ThirstySALMON/conv3x3-edge-accelerator/docs/figures/edge_demo_sobel_x.png

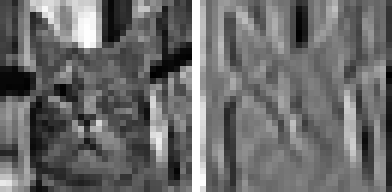
docs/figures/edge_demo_sobel_x.png
