ThirstySALMON/conv3x3-edge-accelerator/docs/figures/waveforms/edges.PNG

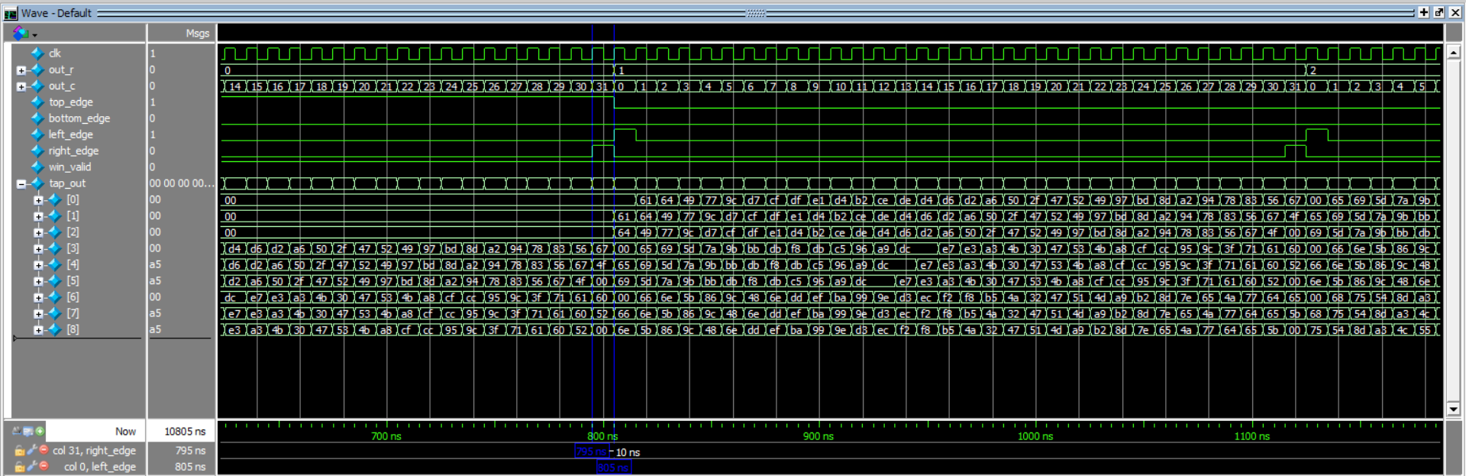
docs/figures/waveforms/edges.PNG
