ThirstySALMON/conv3x3-edge-accelerator/docs/report/REPORT_OUTLINE.md

# Report outline - what each section must say

> **Verified corrections - apply these while writing. They override any bullet below.**
>
> | Claim | Correct value | Source |
> |---|---|---|
> | STREAM state duration | **990 cycles**, not 1024 (cyc 35 -> 1025). Frame = 34 FILL + 990 STREAM + 34 DRAIN + 3 pipeline = 1061. 1024 is the count of inputs and of outputs, not of STREAM cycles - `consume` also runs in IDLE/FILL | `do sim/run.do window` trace |
> | Worst-15 path split | **10** from `bottom_edge_reg` (6 to prod_r[8], 4 to prod_r[6]), 4 from `top_edge_reg`, 1 from `right_edge_reg` | `fpga/reports/paths.rpt` |
> | Line buffers | **16 SRLC32E primitives** (two 8-bit-wide chains of 8), 16 LUTs. Never "2 x SRL32E". Do not claim 0 FFs - `utilization_hier.rpt` shows 61 FFs under LB0 | `synth.log`, `utilization.rpt` |
> | `throughput.PNG` | The shipped capture is the **whole frame** (cursors 515 / 10755 ns, delta 10240 ns = 1024 cycles), not a mid-frame zoom. Caption it as "valid_out unbroken for 1024 consecutive cycles" | the file itself |
> | Window-generator captures | The three `Window_generator_*.PNG` are from the **11 Sep** commit, not the 14 Sep retake; unchanged by later commits (tb_top_window reports 0 errors) | git log |
> | File line counts | cnn_pkg 33, line_buffer 31, window_gen 64, multiplier 8, coeff_reg 34, control_unit 106, top 141 = **417** RTL lines; tb_top 137, tb_top_all 180, tb_top_window 171, tb_window_gen_unit 165; golden.py 80; compile.do 21, run.do 25, build.tcl 76, pynq_z2.xdc 67 | `grep -c ''` |
> | Code line citations | top.sv saturate/ReLU is **lines 116-129**; control_unit nxt_c/nxt_r **40-51**, registered flags **97-100**; window_gen masks **54-62**. (Comments were trimmed on 14 Sep, so any earlier line number is stale - recount before citing, or cite by signal name instead) | the tagged files |
> | COEF_FRAC / Q1.7 | Declared in the package only, **no implementing logic** and no results. Say "a declared toggle with no shift/round stage", or omit | `rtl/cnn_pkg.sv` |
> | xsim version | The SAIF header stamps `VERSION "2020.2"` (the writer's format stamp) though it ran from the Vivado 2025.2 install. Quote both, or run `xsim -version` and quote that | `fpga/tb_top.saif` |
>
> **Also add to section 17 (Assumptions):** kernel size N = 3 assumed (the spec says NxN); coefficients applied unflipped (cross-correlation, the CNN convention, same as golden.py); power-analysis conditions are Vivado defaults (25 C ambient, ThetaJA 11.5 C/W, 250 LFM, no heat sink, commercial grade, typical process).
>
> **Assembly order:** write the report in the announcement's deliverable order - architecture, block diagram, datapath, FSM, memory, window generation, bit-width, RTL, testbench, golden model, waveforms, synthesis, timing, power, tradeoffs, Table 1 - then assumptions, bonuses, conclusion, appendix. The section numbers in this file are authoring groups, not the report's order.
>
> **Appendix fixes:** `modelsim.ini` is at the project root, not in `sim/`. The 14 `hw_out/` files are regenerated by `do sim/run.do all` (tb_top_all); `run.do kernels` rewrites only the five real-kernel `_out.hex`.

Bullets, not prose: the author writes every sentence. Each block says what the section
must cover, with the real numbers, and which figure or table belongs in it.

Numbers come from `fpga/reports/RESULTS.md`, `docs/notes/POWER_METHODOLOGY.md` and
`docs/notes/DESIGN_ITERATIONS.md`. Section order follows the announcement's deliverable list.

Two independent critics reviewed this outline - one against every announcement
requirement, one against the measured numbers. Their findings are at the end; fold them
in while writing.

---

## 1. Accelerator architecture
**Required by:** Deliverable "accelerator architecture"; Instruction 1 "clearly describe the datapath, control FSM, memory/buffer organization, window generation"; Instruction 4 "state all assumptions clearly"; spec items 1, 3, 5 (image size, programmable kernel, stride 1).
**Say:**
- Function (REQUIRED, items 1/3/5): 3x3 same (zero-padded) convolution over a 32x32 grayscale image, stride 1, 1024 input pixels in, 1024 output pixels out, one output pixel per clock.
- Precision at a glance (details in section 7): input 8-bit unsigned Q8.0; coefficients 8-bit signed integer Q8.0 (COEF_FRAC = 0; the package toggle COEF_FRAC = 7 rebuilds for Q1.7); output 16-bit signed, saturating; ReLU is a build-time parameter RELU, default off.
- Programmable kernel (REQUIRED, item 3): 9 coefficients loaded through write_en / write_addr[3:0] / data_write[7:0], write_addr = 3*row + col (0..8), row-major, same order as the taps; addresses 9..15 ignored; writes ignored while busy; reloadable between frames (proven by the back-to-back run, sobel_x then sharpen, kernel swapped while frame 1 drains).
- Architecture type (reuse the exact phrase in Table 1): streaming line-buffer sliding-window convolution, fully parallel 9-multiplier datapath, 3 pipeline register stages after the window, 1.0 output pixel per cycle.
- The architectural claim: strict control/datapath split. control_fsm (rtl/control_unit.sv) owns every counter and flag: state, in_cnt (10b), out_r/out_c (5b each), drain_cnt (6b), four registered edge flags. window_gen, line_buffer, coeff_reg, mult8x8 and the adder tree hold no position state; window_gen has no counters and no valid output.
- Control-to-datapath signals are only: en and the four edge flags into window_gen, busy into coeff_reg (write lock), win_valid into the 3-stage valid chain.
- Datapath in one line: 9 taps (9x8b) x 9 coefficients (9x8b) -> 9 LUT multipliers -> stage-1 register prod_r 9x16b -> three 3-input row adders -> stage-2 register row_r 3x18b -> one 3-input 20-bit adder -> saturate 20b->16b -> ReLU mux -> stage-3 register pixel_out.
- Valid chain runs level with the data: win_valid -> v_prod -> v_row -> valid_out; pipeline registers are free-running, so a valid_in stall becomes a bubble in valid_out exactly 3 cycles later, never corruption.
- Window generation: two 32-deep 8-bit line buffers in series (LB0 from input_in, LB1 from LB0) + 9 tap registers a..i + combinational zero-pad masks driven by the edge flags (section 6).
- Frame sequence: IDLE -> FILL (34 consume-only cycles) -> STREAM (consume + output until the 1024th pixel is consumed) -> DRAIN (34 output-only cycles, en forced high, input ignored) -> DONE (1 cycle, frame_done) -> IDLE. en = valid_in except DRAIN (1) and DONE (0). Consume-only cycles equal output-only cycles (34 = 34) so inputs and outputs both total 1024.
- Interface, 42 pins: clk, rst_n (active-low, synchronous, every module), input_in[7:0] + valid_in, write port 13 pins (write_en, write_addr[3:0], data_write[7:0]), pixel_out[15:0] signed + valid_out, busy. 1 + 1 + 8 + 1 + 13 + 16 + 1 + 1 = 42.
- Flow control: no ready signal. valid_in may drop on any cycle; en gates line buffers, taps and counters together (the window freezes coherently). Source-side frame gating: the source streams exactly 1024 pixels per frame and holds the next frame until busy falls. busy = not IDLE and not DONE; it falls 3 cycles before the last valid_out because the last window is already in the pipeline.
- Latency 37 cycles from first accepted pixel to first valid_out = 34 window fill + 3 pipeline stages. Throughput 1.0 output pixel/cycle peak, gapless within a frame; 1024 outputs in 1061 cycles = 0.965 sustained per frame including fill and drain.
- FoM lever 1 (REQUIRED rationale), throughput = 1 px/cycle: 9 parallel multipliers consume all 9 window pixels every cycle. The 3-multiplier / one-output-per-3-cycles alternative was rejected: throughput x3 for a denominator the pre-implementation estimate put at roughly 1.5x (docs/notes/ARCHITECTURE_LOCKED.md section 4; label it an estimate, not a measurement). It also claims the named bonus.
- FoM lever 2, 0 BRAM (100x penalty per tile): the line buffers are fabric shift registers, inferred as 16 SRLC32E = 16 LUTs for both. Even the cheapest block-RAM mapping (one tile, 100 LUT-equivalents) would raise the denominator from 879 to 879 - 16 + 100 = 963 (arithmetic, +9.6%).
- FoM lever 3, 0 DSP (50x penalty each): use_dsp = "no" attribute on mult8x8 (rtl/multiplier.sv) plus -max_dsp 0 in fpga/build.tcl; the nine 8u x 8s multipliers cost 52-59 LUTs each, 496 in total. Frame this honestly: 9 DSP48E1 would count 450 against 496 LUTs, so the choice is near-neutral on the denominator; it is kept because an 8x8 product uses a fraction of a 25x18 DSP48E1, keeps the whole design in one fabric type with one power model, and keeps the RTL vendor-neutral (one attribute).
- Where the 879 LUTs sit (routed, indicative because Vivado combines LUTs across hierarchy boundaries): 9 multipliers 496, window_gen 132 (116 logic + 16 SRL), coeff_reg 120, control_fsm 80, top-level adder tree / saturate / ReLU 90. DSPs and BRAMs are already 0, so every remaining FoM point is a LUT.
- Constant-coefficient multipliers were rejected: all shipped kernels use only 0, +-1, +-2, +-4, 5 and hardcoding would save roughly 300 LUTs, but forfeits mandatory programmability (item 3).
- Headline results, forward-referenced to sections 12-14: xc7z020clg400-1 (PYNQ-Z2, TUL), Vivado 2025.2, 125 MHz constraint (8.000 ns); 879 LUTs, 441 FFs, 0 DSP, 0 BRAM, 42 IOB, 1 BUFG; WNS +0.742 ns, WHS +0.153 ns, 0 failing endpoints of 602, Fmax 137.8 MHz; total power 0.158 W (0.107 static + 0.052 dynamic, SAIF-annotated, Medium confidence); FoM = 1.0 / (0.158 x 879) = 7.20e-3 at 125 MHz.
- Verification headline, forward-referenced to sections 9-11: golden_model/golden.py (numpy); 22 regression runs all pass (7 kernels x clean / fixed stalls / random stalls + one back-to-back run), RELU=0 and RELU=1 DUTs on the same stimulus; hw_out/ 14 files byte-identical to golden_model/hex/.
- Module/file map: rtl/cnn_pkg.sv (parameters), rtl/control_unit.sv (module control_fsm), rtl/window_gen.sv, rtl/line_buffer.sv, rtl/coeff_reg.sv, rtl/multiplier.sv (module mult8x8), rtl/top.sv (instantiation, 9 multipliers, adder tree, saturate, ReLU, three pipeline registers, valid chain).
- Bonuses claimed by this architecture: one-output-pixel-per-cycle pipelined; multiple kernels (programmable, 5 real kernels verified, reload between frames); ReLU (parameter, verified on all 7 kernels); edge-detection demo in simulation rendered from hw_out/. Board demo not claimed (fpga/top.bit exists for the real PYNQ-Z2 pinout; the pixel-source wrapper was not built).
- Assumptions (REQUIRED, Instruction 4), state as a list: 32x32 fixed image; zero-padded same convolution (1024 outputs) rather than valid (30x30); coefficient port order row-major; watts for the FoM power term (the PDF gives no unit); FoM at 125 MHz; no ready signal, source-side frame gating; I/O timing excluded from timing closure; write port ignored while busy; input is raster order, one pixel per cycle, stalls allowed; kernel choices are the standard ones.
**Show:**
- Table: Design parameters (rtl/cnn_pkg.sv) - Parameter | Value | Kind (fixed / toggle / derived) | Note - rows: IMG_W 32 fixed; IMG_H 32 fixed; KSIZE 3 fixed; NTAP 9 derived; N_MAC 9 fixed (fully parallel); LB_DEPTH 32 = IMG_W (one full row, not IMG_W-3); IN_W 8 unsigned Q8.0; COEF_W 8 signed; COEF_FRAC 0 toggle (7 = Q1.7 rebuild); OUT_W 16 signed saturating; RELU_EN 0 toggle (top parameter RELU); PROD_W 16 derived; ACC_W 20 derived; OUT_MAX +32767; OUT_MIN -32768; FILL_CYCLES 34 = LB_DEPTH + 2; NPIX 1024; DRAIN_CYCLES 34 = FILL_CYCLES.
- Table: Module map - File | Module | Role | Owns - rows from the module/file bullet above; mark control_fsm as the only holder of position state.
- Figure: docs/figures/waveforms/throughput.PNG - mid-frame, valid_out solid high, pixel_out changing every cycle: the 1 px/cycle claim (also reused in the throughput/bonus section).
- Diagram to draw: forward reference to the 5-box block diagram in section 2 - see docs/report/BLOCK_DIAGRAM_NOTES.md.
**Avoid:**
- Do not write "STREAM lasts 1024 cycles": FILL already consumes 34 pixels, so STREAM has 1024 - 34 = 990 consume+output cycles (control_unit.sv leaves STREAM at in_cnt == 1023). 1024 is the per-frame input/output count; the frame total 1061 = 34 + 1024 + 3 only adds up that way.
- Do not list mac3x3.sv, saturate.sv or relu.sv as modules (docs/notes/ARCHITECTURE_LOCKED.md names them, the shipped RTL folds them into top.sv). Do not call the input port pixel_in; it is input_in.
- Do not present 0 DSP as a large FoM saving (450 vs 496); do not fold Fmax 137.8 MHz into the FoM; do not say High confidence on power; do not claim a board demo.
- Do not quote the 3-MAC "1.7-1.9x better" figure from ARCHITECTURE_LOCKED.md as a measured result.
- Do not describe the design as vendor-locked or as needing the PS7; it is PL-only (the ZPS7-1 DRC warning is expected).
**Sources:** rtl/cnn_pkg.sv, rtl/top.sv, rtl/control_unit.sv, docs/notes/ARCHITECTURE_LOCKED.md (sections 1, 4, 5, 6), docs/notes/DESIGN_ITERATIONS.md (section 0), docs/report/BLOCK_DIAGRAM_NOTES.md (I/O count), fpga/reports/RESULTS.md, fpga/build.tcl, rtl/multiplier.sv.

## 2. Block diagram
**Required by:** Deliverable "block diagram" (listed separately from "datapath" and "FSM state diagram", so this figure is the top-level view only).
**Say:**
- One figure, five boxes, left to right: control_fsm (top-left), window_gen (with LB0, LB1, 9 tap registers and the zero-pad masks drawn inside), coeff_reg, MAC datapath (9 x mult8x8 + prod_r + 3 row adders + row_r + final 20-bit adder), saturate / ReLU + output register.
- Draw the control/datapath split as a horizontal divide: control_fsm alone above the line (holds counters and flags, no pixel data); the four datapath boxes below (hold data, no position state). Say this in the caption.
- External pins at the boundary, 42 total: clk, rst_n; input_in[7:0], valid_in; write_en, write_addr[3:0], data_write[7:0]; pixel_out[15:0], valid_out, busy. Annotate "42 pins" (it explains the 27% I/O share of power later).
- Arrows out of control_fsm: en (to window_gen), top_edge / bottom_edge / left_edge / right_edge (to window_gen, draw a register symbol on each - they are flip-flops computed one position ahead), busy (to coeff_reg as the write lock, and to the pin), win_valid (into the valid chain), frame_done (internal, may be shown dashed).
- Arrows into control_fsm: valid_in only (plus clk/rst_n). Nothing else - it never sees pixel data.
- Data arrows: input_in[7:0] -> window_gen; window_gen -> MAC datapath: tap_out[0..8], 9 x 8b; coeff_reg -> MAC datapath: coef[0..8], 9 x 8b; MAC datapath -> saturate/ReLU: acc, 20b; saturate/ReLU -> pixel_out[15:0].
- Valid chain drawn level with the three data registers: win_valid -> v_prod (next to prod_r) -> v_row (next to row_r) -> valid_out (next to pixel_out).
- Three dashed vertical stage boundaries labelled stage 1 (after the multipliers, prod_r 9x16b), stage 2 (after the row adders, row_r 3x18b), stage 3 (after saturate/ReLU, pixel_out 16b). This is the picture for the "Pipeline stages = 3" row of Table 1.
- Annotations to write on the figure: "LB0, LB1: 32 x 8, inferred as 16 SRLC32E (two 8-bit-wide chains), 16 LUTs, 0 BRAM"; "ReLU: RELU parameter, default off"; "latency 37 = 34 fill + 3 stages" near the output; "0 DSP: use_dsp = no" on the multiplier box.
- Optional per-box LUT labels (routed, indicative): control_fsm 80, window_gen 132, coeff_reg 120, multipliers 496, adder tree/saturate/ReLU 90; total 879.
- Show the write-lock explicitly: busy into coeff_reg with a note "writes ignored while busy".
- Show the stall path in one sentence in the caption: en = valid_in freezes window_gen and the counters; the pipeline registers keep clocking and the valid chain carries the bubble.
- Caption gist: "Top-level block diagram. control_fsm holds every counter and flag and no pixel data; window_gen, coeff_reg and the MAC datapath hold data and no position state. Solid arrows data, dashed arrows control. Three pipeline register stages follow the window; the valid bit travels with the data. 879 LUTs, 0 DSP, 0 BRAM on xc7z020clg400-1."
- Keep the detailed datapath drawing for section 3 and the state diagram for section 4; this figure must not duplicate their internals.
**Show:**
- Diagram to draw: 5-box block diagram exactly as sketched under "Block diagram (new figure, 5 boxes)" in docs/report/BLOCK_DIAGRAM_NOTES.md, with corrections 1-9 from that file applied (registered edge flags, valid chain level with stages, SRL annotation, RELU toggle, stage boundaries, latency 37, control outputs, 42 pins).
- Table: Inter-block signals (use it to label the drawing) - Signal | From | To | Width | Meaning - rows: en (control_fsm -> window_gen, 1, shift enable = valid_in except DRAIN/DONE); top/bottom/left/right_edge (control_fsm -> window_gen, 4 x 1, registered zero-pad selects); win_valid (control_fsm -> valid chain, 1); busy (control_fsm -> coeff_reg and pin, 1); frame_done (control_fsm internal, 1); tap_out (window_gen -> multipliers, 9 x 8); coef (coeff_reg -> multipliers, 9 x 8); prod_r (9 x 16, stage 1); row_r (3 x 18, stage 2); acc (20, combinational); pixel_out (16, stage 3).
**Avoid:**
- No BRAM, DSP, FIFO, AXI or ready/handshake symbols anywhere on the figure; nothing of the kind exists in the design.
- Do not label the line buffers 29 x 8 (an old, wrong figure); they are 32 x 8.
- Do not draw the edge flags as combinational decodes of out_r/out_c; they are registers.
- Do not draw mac3x3 / saturate / relu as separate modules or files.
- Do not draw a reset synchroniser or PS7; the RTL has neither.
**Sources:** docs/report/BLOCK_DIAGRAM_NOTES.md, rtl/top.sv (port list and instance names u_cu, u_wg, u_cr, g_mul[k].u_mul), rtl/control_unit.sv (output list), fpga/reports/utilization_hier.rpt (per-box LUTs).

## 5. Memory organization
**Required by:** Deliverable "memory organization"; Instruction 1 "memory/buffer organization"; spec item 9 "BRAMs" in the implementation results; the FoM's 100 x BRAMs term.
**Say:**
- (REQUIRED, item 9) Block RAM used: 0 of 140 tiles (RAMB36 0, RAMB18 0); LUT as Distributed RAM: 0; the only memory-class primitive in the whole design is 16 x SRLC32E (LUT as Shift Register 16). fpga/reports/utilization.rpt sections 1 and 3.
- The image is never stored. State on chip at any time is 2 rows + 9 pixels: two 32-deep line buffers (2 x 32 x 8 = 512 bits) and nine 8-bit tap registers (72 bits). One external read per output pixel; the 9 window pixels come from internal registers, nothing is re-read.
- Line buffer (rtl/line_buffer.sv): a DEPTH x WIDTH = 32 x 8 shift register, en-gated, synchronous reset; sr[0] takes d_in, d_out = sr[DEPTH-1]. No write pointer, no read pointer, no address compare - the delay is fixed by the structure.
- Why it infers as SRL despite the synchronous reset: nothing reads an intermediate element, only sr[DEPTH-1], so Vivado maps the chain into LUT shift registers (fpga/reports/RESULTS.md, "Line buffers came out as SRLs"). 16 LUTs instead of 512 flip-flops.
- Evidence, synth.log "Static Shift Register Report": two rows, u_wg/LB1/sr_reg[0][7] and u_wg/tap_reg_reg[2][7], each Length 30, Width 8, SRLC32E 8 - 16 SRLC32E in total; "Report Cell Usage" lists SRLC32E 16; utilization.rpt "LUT as Shift Register 16" and utilization_hier.rpt u_wg SRLs 16 agree.
- Reading that table for a judge: an SRLC32E is a single LUT6 used as a 32-bit shift register, so 8 cells carry one 8-bit-wide line; the "Pull out last Reg = YES" column shows Vivado kept the reset-bearing end stage as an ordinary flip-flop and put the other 30 stages of each chain in SRLs. Quote the 16 LUTs; do not over-specify beyond what the table says.
- Depth 32 exactly matches the primitive: SRLC32E is 32 deep, so a 32-pixel image row costs precisely one LUT per bit; a 29-deep buffer would cost the same 8 LUTs per line and buy nothing.
- The 100x argument (REQUIRED for the FoM story): one block RAM tile counts as 100 LUT-equivalents; both line buffers together cost 16 LUTs. The cheapest BRAM mapping (one tile for both) would make the denominator 879 - 16 + 100 = 963, +9.6% (arithmetic), and would also need write/read address counters, an output register and read-latency alignment that the fixed-depth shift register does not have. A 32 x 8 line is 256 bits, 1.4% of an 18 kbit tile.
- Tap registers: 9 x 8 bits = 72 FFs in window_gen, en-gated, shifted along each row (a<-b<-c, d<-e<-f, g<-h<-i); all 9 are read in parallel every cycle by the multipliers, so they cannot be a RAM of any kind.
- Coefficient registers (rtl/coeff_reg.sv): 9 x 8 bits = 72 FFs; single write port (write_en, write_addr[3:0], data_write[7:0]), guarded by write_en && !busy && write_addr < 9; 9 parallel read buses, no read mux; the multipliers see all 9 coefficients every cycle. Routed cost 120 LUTs (indicative) - that is the write-address decode fanning out to 9 byte-wide enables, not storage.
- Pipeline registers (rtl/top.sv), free-running (no enable): prod_r 9 x 16 = 144 FFs, row_r 3 x 18 = 54 FFs, pixel_out 16 FFs, valid chain v_prod / v_row / valid_out 3 FFs = 217 FFs, matching the top-level row of utilization_hier.rpt.
- Control state (rtl/control_unit.sv): in_cnt 10 + out_r 5 + out_c 5 + drain_cnt 6 + 4 edge flags + state = 35 FFs routed (Vivado re-encoded the 3-bit enum one-hot, see fpga/reports/RESULTS.md).
- Totals: 441 FFs routed = 217 (top-level pipeline) + 72 (coeff_reg) + 35 (control_fsm) + 117 (window_gen, includes the 72 taps); datapath storage 512 + 72 + 72 = 656 bits; BRAM 0; distributed RAM 0.
- Two kinds of enable, deliberately: everything that holds window position or window data (line buffers, taps, counters) is gated by en so a stall freezes the window coherently; everything downstream of the window is free-running and protected by the travelling valid bit. Unique control sets: 16 (utilization.rpt).
- Reset: every register in every module clears on synchronous rst_n. Correct borders do not depend on it - the zero-pad masks do that (section 6, back-to-back run).
- Scaling note for the tradeoffs section: the on-chip state grows with image width only (2 x IMG_W x 8 bits), never with height; larger widths would cascade SRLC32E cells rather than move to block RAM.
**Show:**
- Table: On-chip storage - Element | RTL location | Size (bits) | Routed implementation | Enable | Why not BRAM - rows: LB0 (window_gen / line_buffer, 32 x 8 = 256, 8 x SRLC32E, en, 100x penalty vs 8 LUTs and no address logic); LB1 (same, 256, 8 x SRLC32E, en, same); tap registers a..i (window_gen tap_reg, 72, FFs, en, 9 parallel reads per cycle); coefficient registers (coeff_reg, 72, FFs, write_en && !busy, 9 parallel reads per cycle); prod_r (top, 144, FFs, free-running, pipeline register); row_r (top, 54, FFs, free-running, pipeline register); pixel_out + valid chain (top, 16 + 3, FFs, free-running, output register); control counters / flags / state (control_fsm, 35 FFs, mixed, not memory). Footer: total 441 FFs, 16 SRL LUTs, 0 BRAM, 0 LUTRAM. Sources: utilization.rpt, utilization_hier.rpt, synth.log.
- Table: Memory-primitive evidence - Report | Line / section | Value - rows: synth.log Static Shift Register Report (2 chains, Length 30, Width 8, 8 SRLC32E each); synth.log Report Cell Usage (SRLC32E 16); utilization.rpt section 1 (LUT as Shift Register 16, LUT as Distributed RAM 0); utilization.rpt section 3 (Block RAM Tile 0 / 140); utilization_hier.rpt (u_wg SRLs 16, RAMB36 0, RAMB18 0).
- Figure: none required; if one is wanted, a small drawing of input_in -> LB0 (32x8) -> LB1 (32x8) with the three tap rows hanging off input_in, LB0 out and LB1 out - this is the same drawing as section 6, draw it once and reference it.
**Avoid:**
- Do not call the line buffers FIFOs, circular buffers or RAMs; they are fixed-depth shift registers with no pointers.
- Do not say the line buffers were "kept at 0 LUT-as-shift-register" (an old note, corrected in RESULTS.md); 16 is the right number and the better outcome.
- Do not quote the per-line-buffer rows of utilization_hier.rpt (LB0 36 LUTs / 61 FFs; LB1 has no row) as exact - the hierarchy report combines LUTs and registers across boundaries; quote the top-level 16 SRLs / 0 BRAM / 441 FFs.
- Do not claim the SAIF confidence is High or that the memory contributes measurably to power (the logic of the whole design is about 6% of 0.158 W).
- Do not say the design needs BRAM for a larger image; say wider SRL chains.
**Sources:** rtl/line_buffer.sv, rtl/window_gen.sv, rtl/coeff_reg.sv, rtl/top.sv, rtl/control_unit.sv, fpga/reports/synth.log (lines 229-270), fpga/reports/utilization.rpt (sections 1, 3, 8), fpga/reports/utilization_hier.rpt, fpga/reports/RESULTS.md, docs/notes/ARCHITECTURE_LOCKED.md (sections 1, 7).

## 6. Line-buffer or window-generation method
**Required by:** Deliverable "line-buffer or window-generation method"; Instruction 1 "window generation"; spec item 1 (32x32) and item 5 (stride 1); Instruction 2 (verified against golden vectors).
**Say:**
- (REQUIRED) Structure (rtl/window_gen.sv): input_in feeds tap i and line buffer LB0; LB0's output (in_f) feeds tap f and line buffer LB1; LB1's output (in_c) feeds tap c. Each tap row is a 3-register shift chain: c->b->a, f->e->d, i->h->g. All of it is en-gated; window_gen has no counters and produces no valid.
- Delay of each tap behind input_in, in enabled cycles: i 1, h 2, g 3 (bottom row, from input_in); f 33, e 34, d 35 (middle row, from LB0); c 65, b 66, a 67 (top row, from LB1). Row-to-row spacing is exactly 32 = IMG_W, column spacing exactly 1: the three rows are vertically aligned, the window is a true 3x3.
- When the centre e holds pixel (r, c), the taps hold: a (r-1,c-1) b (r-1,c) c (r-1,c+1) / d (r,c-1) e (r,c) f (r,c+1) / g (r+1,c-1) h (r+1,c) i (r+1,c+1). The window for (r, c) is at the taps once pixel (r+1, c+1) has entered.
- Stride 1 falls out of the structure: one enabled shift moves the window one column; the raster order of the input is the raster order of the output.
- Why depth 32 and not 29 (REQUIRED, the number a reviewer will question): the line buffer carries one full row of vertical delay. The horizontal tap chains hang off the buffer outputs as parallel branches (input_in also feeds LB0; in_f also feeds LB1), so they add no delay along the vertical axis. With 29 the middle row would sit 29 pixels behind the bottom row, a skewed parallelogram that fails the golden diff on every interior pixel (verified by sweep, docs/notes/ARCHITECTURE_LOCKED.md section 7). IMG_W - 3 = 29 belongs only to a topology with the taps inside the delay chain, and since an SRLC32E is 32 deep either way it would not save a LUT.
- Fill latency 34 = 32 + 2 (FILL_CYCLES = LB_DEPTH + 2 in rtl/cnn_pkg.sv): pixel (0,0) enters tap i on shift 1, leaves LB0 after 32 more shifts into tap f on shift 33, and moves f->e on shift 34. So output (0,0) is at the taps on enabled cycle 34, then one new window per enabled cycle for all 1024 positions.
- Only one line buffer sits between the input and the centre tap. LB1 feeds the top row only, and the top row is zero-masked on output row 0, so the first window does not wait the 66 cycles the top row would need. This is why fill is 34 and not 66.
- Zero padding (same convolution) is done by combinational masks after the tap registers, never by writing zeros into the buffers: top_edge -> taps 0,1,2 (a b c); bottom_edge -> 6,7,8 (g h i); left_edge -> 0,3,6 (a d g); right_edge -> 2,5,8 (c f i). Sequential ifs give OR behaviour, so a corner tap is zeroed by either flag; tap 4 (e, the centre) is never touched.
- Coverage of the masks: rows 0 and 31 and columns 0 and 31 = 124 border windows of 1024 are masked (3 taps on an edge, 5 taps at a corner); the 900 interior windows pass all 9 taps unchanged.
- The flags come from control_fsm as registers computed one position ahead (nxt_r == 0, nxt_r == 31, nxt_c == 0, nxt_c == 31, rtl/control_unit.sv), so on every cycle the flag and the window at the taps belong to the same output position. Registering them moved the comparator out of the multiplier path (WNS +0.332 -> +0.742 ns, Fmax 130.4 -> 137.8 MHz, 4 FFs, LUTs 882 -> 879).
- What is left on the critical path is the flag fanout: bottom_edge_reg -> tap zero mux -> multiplier -> prod_r[8][13], 7 logic levels, 7.297 ns, fanout 156, 1.517 ns on that net; all 15 worst paths start at an edge-flag register (detail in section 13).
- Stall behaviour: en low holds LB0, LB1 and all 9 taps; out_adv is low so out_r/out_c and hence the four flags hold; the masked window at the taps is frozen and win_valid is low. A stall is input starvation, never a design bubble.
- Drain behaviour: after the 1024th pixel the FSM forces en high for 34 cycles so the last windows can still shift out; whatever is on input_in during DRAIN enters the bottom tap row, but the only windows whose bottom row contains post-frame data are the row-31 windows (plus tap i of (30,31)), all zero-masked by bottom_edge / right_edge. Proven by hw_out equality on all 7 kernels.
- Back-to-back frames: there is no reset between frames, so when frame 2 starts LB0/LB1 and the taps still hold the tail of frame 1; the row-0 windows of frame 2 carry frame-1 data in taps a b c, and top_edge masks it. The back-to-back regression run (sobel_x then sharpen, 2048 outputs, byte-identical) shows the masks, not the reset, guarantee the border.
- Cost of the window generator (routed, indicative): 132 LUTs = 116 logic (masks and tap-row logic, partly merged into the multipliers' first LUT level by Vivado) + 16 SRL, 117 FFs including the 72 tap bits; 0 BRAM.
- Verification, unit level (tb/tb_window_gen_unit.sv, direct-drives en and the four flags, cycle-accurate shadow model of both line buffers and the nine taps): test 1 ramp of 3 x 32 + 20 = 116 enabled cycles checked every cycle; test 2 en low for 5 cycles, all 9 taps frozen, then one resume shift; test 3 each single edge flag; test 4 the four corner combinations plus an explicit top-left check (taps 0,1,2,3,6 zero, centre not zero). Verdict line: "PASS: window_gen unit tests all clean (shift, stall, edges, corners)".
- Verification, integration level (tb/tb_top_window.sv, the FSM driving window_gen inside top): on every win_valid cycle all 9 taps are compared with golden_model/vectors/hramp_windows_same.hex (1024 windows x 9 bytes, row-major), (out_r, out_c) with the expected raster position, the four flags with that position, and consecutive win_valid cycles must be adjacent; plus fill latency == FILL_CYCLES (34) and exactly 1024 windows per frame; result 0 tap / position / gap errors.
- Window-level golden vectors in golden_model/vectors/: hramp, vramp, impulse, random, ring (impulse and ring are the border and indexing stress cases).
- End-to-end, the window generator is exercised at all 1024 positions by every one of the 22 regression runs and by the byte-identical hw_out/ files (sections 9-11).
- Tie the numbers to the pictures: 34 fill cycles are the difference between latency 37 and the 3 pipeline stages in docs/figures/waveforms/latency.PNG (145 ns to 515 ns = 370 ns = 37 cycles at the 10 ns TB clock).
**Show:**
- Diagram to draw: the window generator: input_in -> LB0 (32 x 8, SRLC32E) -> LB1 (32 x 8, SRLC32E); tap rows g h i off input_in, d e f off LB0 out, a b c off LB1 out, each drawn as a 3-register shift chain; en into every register; the four flags entering the mask block after the taps; label the delays 1/2/3, 33/34/35, 65/66/67; annotate "one full row = 32, not 29" and "centre e never masked".
- Table: Tap map - Tap | Index | Window position | Fed from | Delay behind input_in (cycles) | Pixel when centre = (r,c) - the 9 rows from the delay bullet above.
- Table: Zero-padding masks - Flag | Condition in control_fsm | Taps zeroed | Output positions | Windows affected - rows: top_edge (nxt_r == 0; a b c = 0,1,2; row 0; 32), bottom_edge (nxt_r == 31; g h i = 6,7,8; row 31; 32), left_edge (nxt_c == 0; a d g = 0,3,6; column 0; 32), right_edge (nxt_c == 31; c f i = 2,5,8; column 31; 32), corners (two flags; 5 taps; 4 positions, counted inside the rows above), centre e (never). Source: rtl/window_gen.sv lines 61-69, rtl/control_unit.sv.
- Figure: docs/figures/waveforms/Window_generator_producing_valid_taps.PNG - unit test, the first complete 3x3 window appearing at the taps after the fill.
- Figure: docs/figures/waveforms/Window_generator_producing_valid_taps2.PNG - the window sliding one column per enabled cycle (a<-b<-c, d<-e<-f, g<-h<-i visible).
- Figure: docs/figures/waveforms/Window_generator_producing_last_valid_taps.PNG - the last window of the run at the taps.
- Figure: docs/figures/waveforms/edges.PNG - output column 31 then column 0: right_edge zeros c f i, next cycle left_edge zeros a d g, centre e untouched; the zero padding in action.
- Figure: docs/figures/waveforms/stall.PNG - valid_in low 3 cycles before pixel 300, en follows, the nine taps hold their values, bubble in valid_out 3 cycles later; the frozen window.
- Figure: docs/figures/waveforms/latency.PNG - first valid_in at 145 ns to first valid_out at 515 ns = 37 cycles = 34 fill + 3 pipeline; the 34 is the line-buffer fill.
**Avoid:**
- Never write 29 or IMG_W - 3 as the buffer depth; any old drawing labelled "Line Buffer (29x8)" must be corrected to 32x8.
- Do not say the borders are zero because reset cleared the buffers; the masks do it (back-to-back run).
- Do not say window_gen generates valid_out, counts positions or detects edges; control_fsm does all three.
- Do not say the first output waits for both line buffers (66 cycles); it waits for one (34).
- Do not say the centre tap is masked at corners, or that corners use a separate flag; two of the four flags overlap there.
- Do not describe the line buffers as RAM with pointers, and do not draw a BRAM.
- Do not claim the edge-flag replication (fanout 156 fix) was done; it is recorded as identified and estimated (0.5-1 ns), not implemented.
**Sources:** rtl/window_gen.sv, rtl/line_buffer.sv, rtl/cnn_pkg.sv (FILL_CYCLES / DRAIN_CYCLES comments), rtl/control_unit.sv (nxt_r / nxt_c, flag registers), docs/notes/ARCHITECTURE_LOCKED.md (sections 6, 7, 8), docs/notes/DESIGN_ITERATIONS.md (section 2 and the critical-path notes), tb/tb_window_gen_unit.sv, tb/tb_top_window.sv, docs/notes/WAVEFORM_CAPTURES.md (captions 4, 5, 8), golden_model/vectors/.

---

## 3. Datapath
**Required by:** Instruction 1 "Clearly describe the datapath ... fixed-point arithmetic"; deliverable "datapath"; bonus "one-output-pixel-per-cycle pipelined architecture"; Table 1 rows "Multipliers / MACs", "Pipeline stages", "Latency", "Throughput".
**Say:**
- Scope: the datapath is everything downstream of the 9 window taps - all in rtl/top.sv except the multiplier cell in rtl/multiplier.sv; it holds no position state (control_fsm owns that) and no feedback loop (pure feed-forward sum tree, not an accumulate-in-place MAC).
- Inputs every cycle: tap_out[0..8] (9 x 8-bit unsigned, already zero-masked by window_gen at borders, row-major a..i) and coef[0..8] (9 x 8-bit signed from coeff_reg, write_addr = 3*row+col, same order as the taps).
- Stage 1 combinational: 9 parallel multipliers 8u x 8s. mult8x8 computes prod = coef * signed'({1'b0, pix}) - the pixel is zero-extended to 9-bit signed so the signed-by-unsigned multiply is exact; Vivado's RTL component statistics list "8x9 Multipliers := 9" (fpga/reports/synth.log).
- Product is 16-bit signed (PROD_W = IN_W + COEF_W = 16), range -32640..+32385.
- Multipliers forced into LUTs: (* use_dsp = "no" *) on mult8x8 plus synth_design -max_dsp 0 in fpga/build.tcl (both, so the result does not depend on one tool default). Result: 0 DSP.
- Multiplier cost: 52 or 59 LUTs each (5 instances at 52, 4 at 59 in fpga/reports/utilization_hier.rpt), 496 LUTs total = 56% of the 879 routed LUTs; per-block split is indicative because Vivado combines LUTs across hierarchy boundaries.
- Stage 1 register: prod_r, 9 x 16 bits, plus v_prod (valid). Synchronous reset, no clock enable, free-running.
- Also inside stage 1's combinational cone, ahead of the multiplier: the tap zero-mask (top -> a,b,c; bottom -> g,h,i; left -> a,d,g; right -> c,f,i) driven by the four REGISTERED edge flags from control_fsm. Registering those flags (design iteration b) is what took WNS from +0.332 to +0.742 ns.
- Stage 2 combinational: three 3-input adders, one per window row: row_sum[0] = a+b+c, row_sum[1] = d+e+f, row_sum[2] = g+h+i. Each 18-bit signed (ROW_W = PROD_W + 2), range -97920..+97155.
- Why row-wise 3+3 rather than one 9-input sum: the grouping matches the window rows (same a-b-c / d-e-f / g-h-i structure as the taps and the masks), splits the 9-input sum into two 3-input adds in consecutive stages, and leaves stage 2 and 3 with large slack (+3.799 / +2.666 ns) so stage 1 alone is binding - the stages are balanced against the multiplier, which cannot be split further without touching the multiplier itself.
- Stage 2 register: row_r, 3 x 18 bits, plus v_row.
- Stage 3 combinational: acc = row_r[0] + row_r[1] + row_r[2], 20-bit signed (ACC_W = 20), range -293760..+291465, lossless; then saturate 20 -> 16 bits by the sign-extension check on acc[19:15] (details in section 7); then ReLU mux relu_out = (RELU && sat[15]) ? 0 : sat, where RELU is a build-time parameter (default 0) so the mux constant-folds away in the shipping build.
- Stage 3 register: pixel_out (16-bit signed) and valid_out.
- Register budget of the three stages: 144 + 54 + 16 data FFs plus 3 valid FFs; FFs do not appear in the FoM denominator, so full-width lossless intermediates cost nothing on the metric.
- Valid chain: win_valid (from control_fsm) -> v_prod -> v_row -> valid_out, one flip-flop per stage, level with the data registers; the pipeline registers have no enable, so the valid bit is the only thing that distinguishes a real result from a bubble.
- Stall behaviour: valid_in low -> en low -> taps and line buffers freeze -> win_valid low for that cycle -> a one-cycle bubble in valid_out exactly 3 cycles later; data already in the pipeline keeps advancing, so a stall can never corrupt an output. Regression asserts valid_out == win_valid delayed by exactly 3 every cycle (lat_err = 0) in all 22 runs; fixed-stall run: 16 stalls in STREAM, 16 bubbles observed.
- Latency accounting: 37 cycles from first accepted pixel to first valid_out = 34 window fill (FILL_CYCLES = LB_DEPTH 32 + 2 tap shifts) + 3 pipeline stages. Waveform: first valid_in at 145 ns, first valid_out at 515 ns, 370 ns = 37 cycles at the 10 ns TB clock.
- Throughput: one new window and 9 multiplies per enabled cycle, 1.0 output pixel per cycle peak, gapless within STREAM; 1024 outputs in 1061 cycles = 0.965 sustained per frame including fill and drain.
- Per-stage worst slack (routed, 8.000 ns, fpga/reports/paths.rpt): stage 1 window/coeffs -> prod_r +0.742 ns; stage 2 prod_r -> row_r +3.799 ns; stage 3 row_r -> pixel_out +2.666 ns. Stage 1 binds; stage 3 has 1.924 ns and stage 2 3.057 ns of headroom over it.
- Critical path: u_cu/bottom_edge_reg -> tap zero mux -> multiplier -> prod_r[8][13], 7 logic levels (4 CARRY4, LUT6, LUT5, LUT3), 7.297 ns, 59% routing; bottom_edge fanout 156 and 1.517 ns spent on that one net. Fmax = 1000/(8.000 - 0.742) = 137.8 MHz.
- All 15 worst paths start at an edge-flag register (bottom_edge_reg, top_edge_reg, right_edge_reg) and end in prod_r[8], [6], [2] or [5] - taps i, g, c, f, the ones masked by two flags or by the right flag - i.e. the limit is when the masks arrive at the multipliers, not the multiplier arithmetic itself.
- Known but not done: replicating the edge-flag registers per tap row to cut the fanout-156 net (est. 0.5-1 ns); timing already closes and Fmax is not in the FoM.
- Constant-coefficient multipliers (all real kernels are 0, +-1, +-2, +-4, 5) would cut roughly 300 LUTs but forfeit the mandatory programmability of spec item 3 - rejected; cross-reference the tradeoffs section.
**Show:**
- Diagram to draw: updated detailed datapath figure - 9 multipliers -> 9x16b register -> 3 row adders -> 3x18b register -> 20b adder -> "sat (top-bits check)" -> ReLU (labelled "RELU parameter, default off") -> 16b output register; dashed stage boundaries labelled stage 1/2/3; valid chain drawn level with the three registers; widths on every bus (8u, 8s, 16, 18, 20, 16); registered edge flags on the four arrows into window_gen; "LB0/LB1 inferred as 16 SRLC32E (two 8-bit-wide chains), 16 LUTs, 0 BRAM" annotation; "latency 37 = 34 fill + 3 stages" near the output - see docs/report/BLOCK_DIAGRAM_NOTES.md.
- Table: Pipeline stages and measured slack - columns: Stage | Combinational logic | Register | Width | Worst slack (ns) | Headroom vs stage 1 (ns) - rows: 1 / 9 LUT multipliers + tap mask / prod_r / 9x16 / +0.742 / -; 2 / 3 row adders / row_r / 3x18 / +3.799 / 3.057; 3 / 20b adder + saturate + ReLU / pixel_out / 16 / +2.666 / 1.924 - source fpga/reports/paths.rpt.
- Table (or listing): multiplier LUT count - rows g_mul[0..8].u_mul, 52/59/52/59/52/59/52/59/52 LUTs, 0 FFs, 0 DSP - source fpga/reports/utilization_hier.rpt.
- Code excerpt: rtl/multiplier.sv verbatim (8 lines: the use_dsp attribute and the single assign) - shows the LUT forcing and the zero-extension.
- Figure: docs/figures/waveforms/throughput.PNG - mid-frame, valid_out solid high, pixel_out changing every cycle: one output per cycle.
- Figure: docs/figures/waveforms/stall.PNG - valid_in low 3 cycles before pixel 300, en follows, taps hold, bubble in valid_out 3 cycles later: the valid chain in action.
- Figure: docs/figures/waveforms/latency.PNG - first valid_in 145 ns to first valid_out 515 ns = 37 cycles.
**Avoid:**
- Do not describe the design as a multiply-ACCUMULATE with a feedback register; acc is a feed-forward 3-input sum. Table 1 "Multipliers / MACs" = 9 multipliers, fully parallel.
- Do not claim the row-wise adder split or the saturation rewrite bought timing - stage 2 and 3 were never binding (1.9-3.1 ns spare); they are structural choices.
- Do not count the window taps or line buffers as pipeline stages; Table 1 "Pipeline stages" is the 3 register stages after the window.
- Do not fold Fmax into throughput or the FoM; throughput is 1.0 per cycle and the FoM is computed at 125 MHz.
- Do not quote the post-synthesis 910 LUTs; the routed 879 is the number. Do not present the per-multiplier 52/59 as exact - Vivado combines LUTs across boundaries.
- Do not oversell LUT-versus-DSP on the FoM: 9 DSPs would count 9 x 50 = 450 in the denominator against 496 LUTs, which is close; the defensible statements are 0 DSP, an all-LUT portable datapath, and that the dominant FoM lever was the measured power.
- Do not claim the fanout replication or DRIVE-strength changes were done.
**Sources:** rtl/top.sv, rtl/multiplier.sv, rtl/cnn_pkg.sv, rtl/window_gen.sv, fpga/build.tcl, fpga/reports/paths.rpt, fpga/reports/utilization_hier.rpt, fpga/reports/synth.log, fpga/reports/timing_summary.rpt, docs/notes/DESIGN_ITERATIONS.md, docs/report/BLOCK_DIAGRAM_NOTES.md, docs/figures/waveforms/throughput.PNG, docs/figures/waveforms/stall.PNG, docs/figures/waveforms/latency.PNG

## 7. Fixed-point bit-width analysis
**Required by:** Spec item 2 "Input precision: fixed point unsigned. Teams must justify the chosen precision in the report"; spec item 4 "Kernel precision: 8-bit signed fixed-point or integer"; spec item 6 "Output precision: minimum 16-bit signed. Teams must explain how overflow, truncation, saturation, or rounding is handled"; deliverable "fixed-point bit-width analysis"; Table 1 rows "Input precision", "Kernel precision".
**Say:**
- (REQUIRED, spec item 2) Input precision justification: 8-bit unsigned, Q8.0, 0..255 - matches 8-bit grayscale sensors and 8-bit feature maps exactly, so the image enters with no quantisation; it is the narrowest width that carries the input losslessly; Q8.0 (no fractional bits) needs no scaling or normalisation logic; unsigned because intensities are non-negative, so no bit is spent on a sign - the sign only appears after multiplication by a signed coefficient (the pixel is zero-extended to 9-bit signed inside mult8x8 for that multiply).
- Kernel precision: 8-bit signed two's complement, Q8.0 integer, -128..+127, exactly spec item 4. The five real kernels use only 0, +-1, +-2, +-4, 5, but every width below is sized for the full -128..+127 because the port is programmable (spec item 3) and any coefficient may be loaded.
- COEF_FRAC in rtl/cnn_pkg.sv: 0 = Q8.0 integer coefficients (the shipping build, all results in this report); 7 = Q1.7 rebuild intended for normalised blur/Gaussian kernels. At COEF_FRAC = 0 there is no shifter or rounder anywhere in the netlist.
- Widths are derived, not chosen: each intermediate is exactly the width that holds the full range of its stage for any 8-bit pixels and any 8-bit signed coefficients - no intermediate is ever truncated.
- Product: 8u x 8s, extreme values 255 x -128 = -32640 and 255 x 127 = +32385 -> 16-bit signed (PROD_W = IN_W + COEF_W = 16; 16-bit signed holds -32768..+32767).
- Row sum of 3 products: -97920..+97155 -> 18-bit signed (ROW_W = PROD_W + 2); 17-bit signed tops out at +-65535/65536 and would overflow.
- Accumulator, sum of 9 products (= 3 row sums): -293760..+291465 -> 20-bit signed (ACC_W = 20), lossless.
- Why ACC_W is exactly 20: the worst-case magnitude 9 x 255 x 128 = 293760 lies between 2^18 = 262144 and 2^19 = 524288, so 19 signed bits (max magnitude 2^18) are insufficient and 20 are sufficient; 21 or 22 would add flip-flops and carry length without adding information (an early 22-bit guess in older notes is superseded, docs/notes/ARCHITECTURE_LOCKED.md section 3).
- Output: 16-bit signed, -32768..+32767, the spec minimum met exactly; the only narrowing in the whole datapath is 20 -> 16 bits at this point.
- (REQUIRED, spec item 6) Overflow: cannot occur inside the datapath, because every intermediate width is lossless through the accumulator; the only place a value can exceed its container is the 20 -> 16-bit output narrowing, and that is handled by saturation (clamp to -32768 / +32767), never by wrap-around.
- (REQUIRED, spec item 6) Saturation mechanism (rtl/top.sv lines 143-153): a 20-bit signed value fits in 16 bits exactly when its top five bits acc[19:15] are all copies of the sign bit, i.e. all 0 or all 1. fits -> pixel = acc[15:0]; not fits and acc[19] = 1 -> -32768 (OUT_MIN); not fits and acc[19] = 0 -> +32767 (OUT_MAX).
- Why the top-bits check equals two magnitude compares: acc > +32767 exactly when acc is non-negative and at least one of bits 19..15 is 1 (i.e. acc >= 2^15), and acc < -32768 exactly when acc is negative and at least one of bits 19..15 is 0 (i.e. acc < -2^15); the all-zeros / all-ones test on 5 bits captures both cases in about 2 LUTs instead of two 20-bit carry-chain comparators (design iteration c).
- Proof of equivalence: exhaustively checked in Python against max(-32768, min(32767, acc)) for all 2^20 = 1,048,576 accumulator values, 0 mismatches (docs/notes/DESIGN_ITERATIONS.md section 3).
- Exercised in RTL: satmax (all nine coefficients +127) and satmin (all -128) kernels were added to the golden model specifically because no real kernel ever reaches the clamp; the golden model reports satmax output range [32767, 32767] and satmin [-32768, -32768], i.e. every one of the 1024 outputs of each, including the zero-padded borders, takes the clamp branch; hw_out/satmax_out.hex and hw_out/satmin_out.hex are byte-identical to golden, in clean, fixed-stall and random-stall runs, RELU=0 and RELU=1.
- Measured accumulator ranges on the 32x32 test image (golden_model/golden.py "acc range" printout): identity 41..255, sobel_x -715..+875, sobel_y -898..+934, sharpen -169..+557, laplacian -357..+241. The widest, sobel_y at 934, needs only 11 signed bits.
- Contrast: the datapath is sized for -293760..+291465, roughly 300x wider than any real kernel produces; the widths are set by the programmability requirement, not by the shipping kernels, and this gap is exactly why the saturation branches had to be covered by synthetic kernels.
- (REQUIRED, spec item 6) Truncation and rounding: none anywhere. All arithmetic is integer - Q8.0 x Q8.0 products, integer row sums, integer accumulator - so there are no fractional bits to drop and no rounding decision to make; the output is the exact integer convolution result whenever |acc| <= 32767 and the clamped value otherwise. State this explicitly as the answer to the "truncation or rounding" part of spec item 6.
- Zero padding costs no precision: masked taps are forced to 0 before the multiply, giving exact zero products, so border outputs are exact same-convolution results.
- ReLU (RELU = 1 build): negative saturated values -> 0 by a sign-bit test after saturation, so -32768 clamps first and is then zeroed; output range becomes 0..+32767, width unchanged at 16 bits.
- Golden model uses the same arithmetic: Python unbounded-integer accumulate, then clamp to [-32768, +32767], optional ReLU - 14 hw_out files x 1024 outputs bit-exact against it.
- Q1.7 rebuild (COEF_FRAC = 7) would require a right shift by 7 at the accumulator output with a rounding choice; only the Q8.0 build was synthesised, implemented and verified.
- Cost of full-width intermediates: 144 + 54 + 16 pipeline data FFs; FFs are not in the FoM denominator (LUTs + 50 x DSPs + 100 x BRAMs), so lossless widths are free on the metric and cheaper in LUTs than any intermediate rounding logic would be.
**Show:**
- Table: Bit-width analysis - columns: Stage | RTL signal | Format | Range | Width (bits) | Derivation - rows: input pixel / input_in, tap_out / unsigned Q8.0 / 0..255 / 8 / spec item 2, 8-bit grayscale; coefficient / coef / signed Q8.0 integer / -128..+127 / 8 / spec item 4; product / prod, prod_r / signed / -32640..+32385 / 16 / IN_W + COEF_W; row sum / row_sum, row_r / signed / -97920..+97155 / 18 / PROD_W + 2; accumulator / acc / signed / -293760..+291465 / 20 / 9 x 255 x 128 = 293760 needs 20; output / sat, pixel_out / signed Q16.0 / -32768..+32767 / 16 / spec minimum, clamp; ReLU output / relu_out / signed / 0..+32767 / 16 / RELU = 1 only - source rtl/cnn_pkg.sv, rtl/top.sv.
- Table: Measured accumulator range per kernel - columns: Kernel | min | max | Saturates? - rows: identity 41 255 no; sobel_x -715 875 no; sobel_y -898 934 no; sharpen -169 557 no; laplacian -357 241 no; satmax (all +127) +32767 +32767 yes, all 1024 outputs; satmin (all -128) -32768 -32768 yes, all 1024 outputs - source golden_model/golden.py printout, hw_out/*.hex.
- Code excerpt: rtl/top.sv lines 143-153 (acc_top, fits, the three-way sat assignment) with the comment on the 2^20 exhaustive check.
- Diagram to draw (optional, small): the 20-bit accumulator word with bits [19:15] bracketed as "must all equal bit 15" and bits [15:0] bracketed as "passed to output when they do" - illustrates the top-bits check in one glance.
**Avoid:**
- Do not present the Q1.7 rebuild as implemented or verified: COEF_FRAC is declared in rtl/cnn_pkg.sv but no RTL module reads it and no shift/round logic exists; describe it as a declared build option with no results, or leave it out. No Q1.7 numbers exist.
- Do not mention rounding or truncation as something the design "does"; the correct statement is that neither arises because the arithmetic is integer.
- Do not say the output "cannot overflow" - it can for extreme programmable kernels, and that case is handled by the clamp; say overflow cannot occur before the clamp.
- Do not quote a symmetric product range (+-32768); it is -32640..+32385. Do not cite the 22-bit or 21-bit accumulator from older planning notes.
- Do not claim the saturation rewrite improved timing (stage 3 had +2.666 ns slack before and after); its value is 2 LUTs and the coverage gap it exposed.
- Do not call satmax/satmin real filters; they exist only to drive the clamp.
**Sources:** rtl/cnn_pkg.sv, rtl/top.sv, rtl/multiplier.sv, rtl/window_gen.sv, golden_model/golden.py, golden_model/hex/satmax_out.hex, golden_model/hex/satmin_out.hex, hw_out/satmax_out.hex, hw_out/satmin_out.hex, tb/tb_top_all.sv, docs/notes/DESIGN_ITERATIONS.md (section 3), docs/notes/ARCHITECTURE_LOCKED.md (section 3)

---

## 4. FSM state diagram
**Required by:** Deliverable "FSM state diagram"; Instruction 1 "clearly describe the ... control FSM"; Instruction 4 "state all assumptions clearly" (no-ready frame contract); judged under "digital design quality" and "latency".
**Say:**
- control_fsm (rtl/control_unit.sv) is the only block that knows the frame position: window_gen has no counters, the datapath has no position state. From valid_in alone it drives en, the four registered edge flags (top/bottom/left/right_edge), win_valid, busy and frame_done. frame_done is internal to top, not one of the 42 pins.
- Five states, 3-bit enum S_IDLE, S_FILL, S_STREAM, S_DRAIN, S_DONE; Vivado one-hot encodes it. Routed hierarchy (fpga/reports/utilization_hier.rpt, indicative): u_cu = 80 LUTs, 35 FFs = 5 state + 10 in_cnt + 5 out_r + 5 out_c + 6 drain_cnt + 4 edge flags.
- Transitions: IDLE -> FILL on valid_in; FILL -> STREAM on valid_in && in_cnt == 33 (FILL_CYCLES-1); STREAM -> DRAIN on last_consume = consume && in_cnt == 1023 (NPIX-1); DRAIN -> DONE on drain_cnt == 33 (DRAIN_CYCLES-1); DONE -> IDLE unconditionally after exactly 1 cycle.
- Output equations: en = valid_in in IDLE/FILL/STREAM, forced 1 in DRAIN, 0 in DONE; consume = en && state != DRAIN; out_adv = en && (state == STREAM || state == DRAIN); win_valid = out_adv; busy = (state != IDLE) && (state != DONE); frame_done = (state == DONE).
- IDLE is not a dead cycle: en = valid_in there too, so the first pixel is consumed on the IDLE -> FILL transition itself (in_cnt 0 -> 1, LB0 shifts). busy therefore rises one cycle after the first accepted pixel.
- (REQUIRED, latency) Frame bookkeeping in enabled cycles: 34 consume-only (1 in IDLE + 33 in FILL, in_cnt 0..33) -> 990 consume+output in STREAM (in_cnt 34..1023, output positions (0,0)..(30,29)) -> 34 output-only in DRAIN (drain_cnt 0..33, positions (30,30)..(31,31)) -> 1 DONE cycle. Consumes 34 + 990 = 1024, outputs 990 + 34 = 1024.
- FILL = DRAIN = 34 is forced, not chosen: every enabled cycle is consume-only, consume+output, or output-only; consumes must total 1024 and outputs must total 1024, so output-only cycles == consume-only cycles. cnn_pkg.sv defines DRAIN_CYCLES = FILL_CYCLES for exactly this reason.
- Why 34: line-buffer depth 32 + 2 tap shifts (LB0 output -> tap f -> tap e). Only LB0 sits between the input and the centre tap; LB1 feeds the top row, which is zero-masked on row 0, so it does not gate the first output. (Cross-reference the window-generation section.)
- Why DRAIN with en forced high is safe: output (31,31) needs 34 + 1024 - 1 = 1057 shifts but only 1024 real pixels exist; the 33 extra shifts push whatever is on input_in into the bottom tap row (the TB drives 0xA5 during drain), and every window that sees it is bottom_edge- or right_edge-masked, so nothing leaks into any output.
- Whole-frame numbers that follow: latency 37 cycles = 34 window fill + 3 pipeline stages (latency.PNG: 145 ns -> 515 ns = 370 ns at the 10 ns TB clock); frame span 1061 cycles first valid_in to last valid_out = 34 + 990 + 34 + 3; throughput 1.0 output/cycle peak, gapless in-frame, 1024/1061 = 0.965 sustained.
- Counters and widths: in_cnt 10 b (0..1023, increments on consume, wraps to 0 on the last consume); out_c 5 b and out_r 5 b (advance on out_adv through nxt_c/nxt_r, 31 wraps to 0); drain_cnt 6 b (counts only in DRAIN, held at 0 elsewhere). Synchronous active-low reset puts state IDLE, every counter 0, flags at position (0,0).
- in_cnt is not redundant (docs/notes/DESIGN_ITERATIONS.md, item 1): consume also runs during FILL, so the input count leads the output position by exactly 34; at the last consume the output position is (30,29), not a corner, so bottom_edge && right_edge cannot replace the in_cnt == 1023 trigger. The substitution was modelled and gave 1059 consumed / 1058 out instead of 1024 / 1024; reverted.
- Edge flags are four FFs inside the FSM: reset to top=1, left=1, bottom=0, right=0 (position (0,0)); every cycle they are registered from nxt_r/nxt_c, which is the position after the current one when out_adv is high and the current position otherwise. top = (nxt_r == 0), bottom = (nxt_r == 31), left = (nxt_c == 0), right = (nxt_c == 31). On the cycle a window sits at the taps its flags are already in flip-flops.
- (REQUIRED, critical path) Why they are registered: the baseline critical path was u_cu/out_c_reg[4] -> right_edge comparator -> tap zero mux -> multiplier -> prod_r[8][13], 8 logic levels, 7.633 ns, 62% routing, comparator net fanout 127, WNS +0.332 ns. After registering: u_cu/bottom_edge_reg -> tap zero mux -> multiplier -> prod_r[8][13], 7 levels (4 CARRY4, LUT6, LUT5, LUT3), 7.297 ns, 59% routing; WNS +0.332 -> +0.742 ns, Fmax 130.4 -> 137.8 MHz.
- Cost of registering: 4 FFs (441 total, from 437); LUTs 882 -> 879, i.e. flat - the comparator logic moved out of the multiplier cycle, it did not shrink. Latency, throughput and the module interface unchanged.
- What is left on the path: bottom_edge fanout 156, 1.517 ns of the 7.297 ns is that one net into window_gen; all 15 worst paths start at an edge-flag register and end in prod_r (bottom_edge -> prod_r[8] and prod_r[6] 10 of 15, top_edge -> prod_r[2][*] 4, right_edge -> prod_r[5][13] 1). Replicating the flag registers per tap row (about 8 FFs, est. 0.5-1 ns) was identified and not done - timing closes, and Fmax is not in the FoM.
- Flags verified: tb_top_window checks out_r/out_c and all four flags against the expected raster position on every one of the 1024 windows - 0 position/edge errors, fill latency 34, 0 gaps in win_valid.
- Stall in FILL (or IDLE): en = 0 freezes LB0, LB1, the taps and in_cnt; out_adv is already 0, so the only effect is that the first valid_out moves later by the stall length. Fixed-stall run: 2 cycles before pixel 10, no bubble.
- Stall in STREAM: en = 0 freezes the window, in_cnt, out_r/out_c and the flags (nxt = current when out_adv = 0) and drops win_valid; the three pipeline registers are free-running with a valid bit travelling alongside the data, so the identical gap appears in valid_out exactly 3 cycles later - a bubble, never a corrupted or duplicated pixel (stall.PNG: 3 cycles before pixel 300).
- Stall in DRAIN: impossible by construction - en is forced 1, consume is 0, valid_in is ignored; DRAIN always takes exactly 34 cycles, so the frame tail (frame_done, busy falling) is deterministic relative to the last accepted pixel. In DONE en = 0.
- Regression evidence for stalls (tb/tb_top_all.sv, 22/22 runs pass): fixed stalls before pixels 10 (2 cycles), 300 (3), 511 (1, row boundary), 700 (8), 1023 (4) = 18 cycles, 16 in STREAM, 16 bubbles observed; random stalls hold about 1 in 5 pixels for 1-4 cycles, roughly 500 stall cycles per run, bubbles always equal to STREAM stalls; every cycle valid_out must equal win_valid delayed by exactly 3 (lat_err = 0), checked on both the RELU=0 and RELU=1 DUTs.
- (REQUIRED, assumption) Frame-to-frame contract: there is no ready signal in either direction. The source streams exactly 1024 pixels per frame and holds the next frame until busy falls; the sink must accept every valid_out. Pixels driven during DRAIN would be shifted in (en = 1) but never counted, so they would be lost - hence wait for busy.
- busy falls when the FSM enters DONE, 3 cycles before the final valid_out: the last window has already been multiplied into prod_r and the last three outputs are in the adder / saturate stages. The TB's finish_frame waits for !busy and then 8 more cycles (drain.PNG).
- (assumption) A pixel presented in the single DONE cycle is not consumed (en = 0); the first pixel of the next frame must arrive no earlier than the following IDLE cycle. A source that registers busy before reacting satisfies this automatically.
- Coefficient write lock (rtl/coeff_reg.sv): a write lands only when write_en && !busy && write_addr < 9; writes during FILL, STREAM or DRAIN are silently dropped, writes in IDLE and DONE are accepted. Consequence: every output of a frame is computed with one kernel (kernel_load.PNG: 9 writes with busy low).
- Back-to-back proof (tb_top_all run "sobel_x -> sharpen, back to back"): frame 1 streamed, wait(!busy), sharpen's 9 coefficients written immediately while frame 1's last three outputs are still leaving the pipeline, frame 2 streamed with no idle gap; 2048 outputs, all match their golden files on both DUTs. Safe because coefficients feed only stage 1 and the last window has already been multiplied when busy drops.
- frame_done is a one-cycle pulse in DONE, coincident with busy low; tb_top_window uses it to end the frame. The per-state values of all outputs are in the state/output table.
**Show:**
- Figure: docs/figures/waveforms/fsm.PNG - whole frame IDLE -> FILL -> STREAM -> DRAIN -> DONE -> IDLE, in_cnt counting to 1023 and drain_cnt to 33; the state sequence and counter ranges of the table in one capture.
- Figure: docs/figures/waveforms/drain.PNG - last pixel in at 10385 ns, FSM in DRAIN with en high and junk on the bus masked by bottom_edge/right_edge, output count reaches 1024, frame_done pulses, busy drops 3 cycles before the final valid_out.
- Figure: docs/figures/waveforms/stall.PNG - valid_in low for 3 cycles before pixel 300, en follows, taps hold, win_valid drops, the same 3-cycle gap in valid_out exactly 3 clocks later; nothing lost or duplicated.
- Figure: docs/figures/waveforms/latency.PNG - cursor 1 at valid_in rising (145 ns), cursor 2 at valid_out rising (515 ns): 370 ns = 37 cycles = 34 fill + 3 stages; coefficient writes finish before the frame starts.
- Figure: docs/figures/waveforms/kernel_load.PNG (cross-reference, primary in the RTL/interface section) - 9 write_en pulses, write_addr 0..8, busy low throughout: the write-lock half of the contract.
- Figure: docs/figures/waveforms/edges.PNG (cross-reference, primary in the window-generation section) - registered right_edge at column 31 then left_edge at column 0 acting on the taps, centre untouched.
- Diagram to draw: FSM state diagram - five state bubbles; arcs labelled IDLE->FILL "valid_in", FILL->STREAM "valid_in && in_cnt == 33", STREAM->DRAIN "consume && in_cnt == 1023", DRAIN->DONE "drain_cnt == 33", DONE->IDLE "1 cycle"; each state annotated with en / consume / out_adv=win_valid / busy / frame_done and its enabled-cycle count (34 incl. the IDLE pixel / 990 / 34 / 1); a side note that top/bottom/left/right_edge are registered FSM outputs computed from nxt_r/nxt_c, not decodes of out_r/out_c - see docs/report/BLOCK_DIAGRAM_NOTES.md "FSM diagram".
- Table: FSM state/output table - columns State | Entered on | Left on | en | consume | out_adv = win_valid | busy | frame_done | Counters / cycles - rows from rtl/control_unit.sv:
  - IDLE | reset, or from DONE | valid_in (that pixel is consumed) | valid_in | en | 0 | 0 | 0 | in_cnt 0 -> 1 on exit; out_r/out_c = (0,0); flags top=1, left=1
  - FILL | first pixel accepted | valid_in && in_cnt == 33 | valid_in | en | 0 | 1 | 0 | in_cnt 1 -> 34; output position held at (0,0); 33 enabled cycles (34 consume-only with the IDLE pixel)
  - STREAM | in_cnt == 34 | consume && in_cnt == 1023 | valid_in | en | en | 1 | 0 | in_cnt 34 -> 1023 then 0; out (0,0) -> (30,29); 990 enabled cycles; stalls become bubbles
  - DRAIN | pixel 1023 consumed | drain_cnt == 33 | 1 | 0 | 1 | 1 | 0 | drain_cnt 0 -> 33; out (30,30) -> (31,31); exactly 34 cycles; valid_in ignored
  - DONE | drain_cnt == 33 | always, after 1 cycle | 0 | 0 | 0 | 0 | 1 | drain_cnt cleared; last 3 outputs still in the pipeline; coefficient writes accepted again
**Avoid:**
- Do not write "STREAM lasts 1024 cycles": the state runs 990 enabled cycles (in_cnt 34..1023, since 34 pixels were consumed before it). 1024 is the number of consumes and of outputs per frame; the 1061-cycle frame figure (34 + 990 + 34 + 3) only adds up with 990.
- Do not call busy a ready or handshake signal; there is no backpressure on either side, and the sink must accept every valid_out.
- Do not claim stalls are tolerated in DRAIN or that valid_in has any meaning there.
- Do not draw or describe the edge flags as combinational decodes of out_r/out_c (the old drawing) - they are FSM registers.
- Do not claim registering the flags saved area: 882 -> 879 LUTs is flat; the gain was WNS +0.332 -> +0.742 ns and Fmax 130.4 -> 137.8 MHz. Do not fold 137.8 MHz into the FoM (FoM is at 125 MHz).
- Do not claim edge-flag replication was done, or a board demo.
- Do not present 80 LUTs / 35 FFs for control_fsm as exact - hierarchical numbers are indicative because Vivado merges LUTs across boundaries; 879 / 441 is the number.
- Do not describe frame_done as a pin; the 42 pins are clk, rst_n, 8 input_in, valid_in, 13 write-port, 16 pixel_out, valid_out, busy.
- Do not say the kernel can be changed mid-frame; writes are dropped while busy and the back-to-back swap happens after busy falls.
- Do not say the FSM "predicts" the flags; they are computed from the next position and registered so they are exact on the cycle they are used - verified on all 1024 windows.
**Sources:** rtl/control_unit.sv, rtl/cnn_pkg.sv (FILL_CYCLES / DRAIN_CYCLES comments), rtl/top.sv (valid chain), rtl/coeff_reg.sv (write lock), rtl/window_gen.sv (mask polarity), tb/tb_top_all.sv, tb/tb_top.sv, tb/tb_top_window.sv, docs/notes/WAVEFORM_CAPTURES.md, docs/notes/DESIGN_ITERATIONS.md (items 1 and 2, per-stage slack), docs/report/BLOCK_DIAGRAM_NOTES.md, fpga/reports/utilization_hier.rpt, fpga/reports/timing_summary.rpt, fpga/reports/paths.rpt

---

## 8. RTL implementation details
**Required by:** Instruction 1 "Clearly describe the datapath, control FSM, memory/buffer organization, window generation, and/or fixed-point arithmetic"; deliverable "RTL implementation details"; submission item "RTL source files"; judging criterion "digital design quality".
**Say:**
- Seven SystemVerilog-2012 files in rtl/, 476 lines total: cnn_pkg.sv 59, line_buffer.sv 33, window_gen.sv 71, multiplier.sv 7, coeff_reg.sv 33, control_unit.sv 106, top.sv 167; compile order is cnn_pkg first (sim/compile.do, fpga/build.tcl), every other file begins with `import cnn_pkg::*`.
- Module hierarchy: top -> u_cu (control_fsm), u_wg (window_gen) -> LB0, LB1 (line_buffer), u_cr (coeff_reg), g_mul[0..8].u_mul (mult8x8); these instance names are the ones that appear in the timing report (u_cu/bottom_edge_reg -> prod_r_reg[8][13]).
- cnn_pkg.sv: package, parameters only, the single source of every width, depth and cycle count; nothing in the RTL carries a literal 32, 9, 20 or 34 - counters size themselves with $clog2(NPIX), $clog2(IMG_W), $clog2(DRAIN_CYCLES); values split into fixed / derived / toggle (parameter table below).
- line_buffer.sv, `module line_buffer #(DEPTH = LB_DEPTH, WIDTH = IN_W)`, ports clk, rst_n, d_in[7:0], en, d_out[7:0]:
  - unpacked array sr[0:31], sr[0] <= d_in and shift on en, d_out = sr[31]; only the tail is ever read, which is what lets Vivado fold it into SRLC32E even with the synchronous reset (synth.log Static Shift Register Report: two chains, length 30, width 8, 8 SRLC32E each, "Pull out last Reg YES") -> 16 LUTs as shift register, 0 FFs of its own, 0 BRAM.
  - en-gated so a valid_in stall freezes the whole window coherently; the file comment still says "FF/LUTRAM", the routed result is SRL.
- window_gen.sv, `module window_gen`, ports clk, rst_n, input_in[7:0], top_edge, left_edge, right_edge, bottom_edge, en, tap_out[0:8][7:0]:
  - two line_buffer instances in series, LB0 (input_in -> in_f) and LB1 (in_f -> in_c); nine en-gated tap registers tap_reg[0:8], row-major shift a<-b<-c<-in_c, d<-e<-f<-in_f, g<-h<-i<-input_in.
  - zero padding is one always_comb block: copy tap_reg to tap_out, then four sequential ifs (top -> 0,1,2; bottom -> 6,7,8; left -> 0,3,6; right -> 2,5,8); sequential ifs give OR behaviour so a corner tap is cleared by both flags; tap[4] appears in no if and is never zeroed.
  - holds no counters and produces no valid: control owns all position state, which is why it can be unit-tested by direct-driving en and the four flags (tb_window_gen_unit.sv).
  - routed: 132 LUTs (116 logic + 16 SRL), 117 FFs.
- multiplier.sv, `module mult8x8`, ports coef signed[7:0], pix[7:0], prod signed[15:0], 7 lines: `assign prod = coef * signed'({1'b0, pix})` - the unsigned pixel is zero-extended to a 9-bit signed operand so the product is a true signed 8 x 9 multiply (synth.log RTL Component Statistics: "8x9 Multipliers := 9"); carries `(* use_dsp = "no" *)`, the only vendor-specific line in the RTL; 52-59 LUTs each, 496 in total, 0 DSP.
- coeff_reg.sv, `module coeff_reg`, ports clk, rst_n, write_addr[3:0], data_write[7:0], write_en, busy, coef_out[0:8][7:0]:
  - storage coef_reg[0:8], 72 FFs; write guard `write_en && !busy && write_addr < NTAP` - a write during FILL/STREAM/DRAIN is ignored so a kernel can never change under a frame, and the unused addresses 9..15 of the 4-bit port are dropped instead of aliasing.
  - reset clears all nine coefficients to 0; write_addr = 3*row + col, the same row-major order as the taps.
  - the 120 LUTs are the address decoder and nine byte-wide enables, not the storage; the write port shape (addr + data + enable) is part of the documented interface and was kept.
  - the guard is timed to the pipeline: busy falls when the last window's products are already in prod_r, so a rewrite the cycle busy drops cannot touch frame 1 - exercised by the back-to-back run in tb_top_all (sobel_x then sharpen, `wait(!busy); load("sharpen")`, 2048 outputs correct).
- control_unit.sv, module name `control_fsm` (file name and module name differ), ports clk, rst_n, valid_in -> en, win_valid, top_edge, bottom_edge, left_edge, right_edge, busy, frame_done:
  - `typedef enum logic [2:0] {S_IDLE, S_FILL, S_STREAM, S_DRAIN, S_DONE}`; Vivado re-encoded it one-hot, 5 FFs (synth.log "encoded FSM with state register 'state_reg' using encoding 'one-hot'").
  - counters: in_cnt 10 b (consumed pixels, wraps at NPIX-1), out_c / out_r 5 b each (output raster position, wrap (31,31) -> (0,0) which is also the reset position), drain_cnt 6 b (counts only in DRAIN, else 0).
  - en by state: DRAIN -> 1, DONE -> 0, otherwise valid_in; consume = en && state != DRAIN; out_adv = en && (STREAM or DRAIN); last_consume = consume && in_cnt == NPIX-1; win_valid = out_adv; busy = not IDLE and not DONE; frame_done = (state == DONE).
  - transitions: IDLE -> FILL on valid_in; FILL -> STREAM on valid_in && in_cnt == FILL_CYCLES-1 (33); STREAM -> DRAIN on last_consume; DRAIN -> DONE on drain_cnt == DRAIN_CYCLES-1 (33); DONE -> IDLE unconditionally; default arm -> IDLE.
  - edge flags are registered: nxt_c / nxt_r are the next output position (combinational), and top_edge <= nxt_r == 0, bottom_edge <= nxt_r == IMG_H-1, left_edge <= nxt_c == 0, right_edge <= nxt_c == IMG_W-1 are clocked, so the flag used at position (r,c) was computed one cycle earlier; reset values top_edge = left_edge = 1 (position (0,0)), bottom = right = 0.
  - frame_done is internal to top (not one of the 42 pins); it exists for the testbenches and the drain waveform and is trimmed in synthesis; routed control_fsm: 80 LUTs, 35 FFs.
- top.sv, `module top #(parameter bit RELU = RELU_EN)`, 42 pins: clk, rst_n, input_in[7:0], valid_in, write_en, write_addr[3:0], data_write[7:0], pixel_out signed[15:0], valid_out, busy (24 IBUF + 18 OBUF in synth.log matches 24 inputs / 18 outputs):
  - `generate for (k = 0; k < NTAP; k++) begin : g_mul` instantiates the nine multipliers on tap_out[k] x coef[k]; localparam ROW_W = PROD_W + 2 = 18.
  - stage 1 register prod_r[0:8] 9 x 16 b + v_prod; stage 2: row_sum[0..2] three 3-input adds -> row_r 3 x 18 b + v_row; stage 3: acc = row_r[0]+row_r[1]+row_r[2] (20 b) -> saturate -> ReLU mux -> pixel_out + valid_out.
  - saturation: acc_top = acc[19:15]; fits = (acc_top == '0) || (acc_top == '1); sat = fits ? acc[15:0] : (acc[19] ? OUT_MIN : OUT_MAX) - a 5-bit equality instead of two 20-bit compares, exhaustively equal over all 2^20 values (REQUIRED for spec item 6, cross-reference the bit-width section).
  - `assign relu_out = (RELU && sat[15]) ? '0 : sat` - RELU is an elaboration-time parameter, so the RELU = 0 build folds the mux away at zero cost; tb_top_all instantiates top (RELU = 0) and top #(.RELU(1'b1)) on the same stimulus.
  - pipeline registers are free-running (no en); the valid bit win_valid -> v_prod -> v_row -> valid_out travels with the data, so a valid_in stall is a bubble three cycles later, never corruption; the design has only 16 unique control sets (utilization.rpt).
  - synthesis saw exactly the RTL arithmetic: 1 x 3-input 20-bit adder, 3 x 3-input 18-bit adders, 9 x 8x9 multipliers, one 10-bit, one 6-bit and two 5-bit counter adders (synth.log RTL Component Statistics); routed top-level glue 90 LUTs, 217 FFs.
- Synchronous reset everywhere: every always_ff is `@(posedge clk) if (!rst_n) ... else ...`, no asynchronous reset in any file; utilization.rpt 1.1 confirms 0 asynchronous registers, 438 FDRE + 3 FDSE, 0 latches; the 3 set-type flops are top_edge, left_edge (reset to 1) and the one-hot IDLE bit; rst_n is false-pathed in the XDC and a board wrapper would add a 2-flop synchroniser.
- en-gating rule: window-side state (both line buffers, nine taps, in_cnt via consume, out_r/out_c via out_adv) is enable-gated and freezes on a stall; datapath pipeline registers are deliberately not gated (see stall.PNG: taps hold, bubble appears in valid_out 3 cycles later).
- Style: always_ff / always_comb only, no `always @*`; unpacked arrays as ports (tap_out, coef_out); no `timescale in the RTL (testbenches carry 1ns/1ps, xelab is given --timescale 1ns/1ps); named instances; one module per file.
- Register inventory, 441 FFs, per module from utilization_hier.rpt: top 217 + coeff_reg 72 + control_fsm 35 + window_gen 117 = 441.
  - top 217 = prod_r 9 x 16 = 144 + row_r 3 x 18 = 54 + pixel_out 16 + valid chain 3 (v_prod, v_row, valid_out).
  - control_fsm 35 = one-hot state 5 + in_cnt 10 + out_r 5 + out_c 5 + drain_cnt 6 + edge flags 4.
  - coeff_reg 72 = 9 x 8 coefficients; window_gen 117 = 72 tap bits + 45 flip-flops belonging to the delay lines.
  - RTL-level cross-check from synth.log RTL Component Statistics: 906 register bits declared (3 x 18, 10 x 16, 1 x 10, 82 x 8 = 9 coef + 9 taps + 64 delay stages, 1 x 6, 2 x 5, 7 x 1, state 3); 480 of the 512 delay bits fold into 16 SRLC32E (two chains of 30 x 8), one-hot adds 2, leaving 428 named plus 13 tool-inserted FFs (fanout replication of control registers is the usual cause) = 441.
  - baseline was 437 FFs; the +4 are the registered edge flags.
- LUT split (routed, indicative because Vivado combines LUTs across hierarchy): 9 multipliers 496, coeff_reg 120, window_gen 132 (116 + 16 SRL), control_fsm 80, top-level adder tree / saturate / relu 90; flat total 879 (863 logic + 16 shift register); post-synthesis 910 before opt_design; primitives: 399 LUT6, 251 LUT3, 211 LUT4, 182 LUT5, 101 LUT2, 3 LUT1, 128 CARRY4, 16 SRLC32E, 1 BUFG.
- Iteration (a), pointer to the tradeoffs section: removing in_cnt as "redundant" was tried and reverted - consume runs during FILL, so the last consume lands at output position (30,29), not a corner; the modified FSM ran 1059 consumed / 1058 out instead of 1024 / 1024.
- Iteration (b): edge flags registered (nxt_r / nxt_c one position ahead) - WNS +0.332 -> +0.742 ns, Fmax 130.4 -> 137.8 MHz, LUTs 882 -> 879, FFs 437 -> 441; critical path went from 8 levels / 7.633 ns (out_c_reg -> comparator -> mux -> multiplier) to 7 levels / 7.297 ns (bottom_edge_reg -> mux -> multiplier).
- Iteration (c): saturation by top-bits check instead of two 20-bit magnitude compares (about 2 LUTs); proven equivalent over all 2^20 accumulator values; it exposed that neither clamp branch had ever been exercised (widest real kernel is sobel_y at -898..+934), so satmax (all +127) and satmin (all -128) were added and the regression went 16 -> 22 runs.
- Iteration (d), no RTL change: SAIF-annotated power replaced the vectorless estimate, 0.181 -> 0.158 W, FoM 6.285e-3 -> 7.20e-3 (+14.6%); details in the power section.
- Constant-coefficient multipliers were analysed and rejected: all real kernels use only 0, +-1, +-2, +-4, 5 and hardcoding would save roughly 300 LUTs, but forfeits the mandatory programmable-kernel requirement.
- Vendor neutrality: the only vendor-specific text in the RTL is `(* use_dsp = "no" *)` in multiplier.sv; no primitives, no IP, no vendor macros; `-max_dsp 0` is a synth_design switch in build.tcl, not RTL; SRL mapping is a consequence of the coding style, not an instantiated SRLC32E; the same source compiles under ModelSim ASE 2020.1 (vlog -sv), Vivado xsim (xvlog -sv) and Vivado 2025.2 synthesis; another vendor needs only the equivalent attribute (e.g. multstyle = "logic").
- Reproducibility: two independent flows (11 Sep in-memory Tcl, 13 Sep project flow) gave identical results, 879 LUTs / 441 FFs / WNS +0.742 / 0.158 W; the submission RTL is tagged v1.0-submission.
- sim/compile.do (22 lines): `do sim/compile.do` from the project root; creates and maps sim/work, mkdir sim/out, `vlog -sv` the seven RTL files in dependency order (cnn_pkg first) then the four testbenches.
- sim/run.do (28 lines): `do sim/run.do all|kernels|window|unit|<kernel> [stall]`; all -> tb_top_all (7 kernels x 3 stall modes + back-to-back = 22 runs, writes hw_out/); kernels -> the five real kernels through tb_top one after another; window -> tb_top_window; unit -> tb_window_gen_unit; `<kernel> 1` -> tb_top +KERNEL= +STALL=1; vsim runs with -voptargs=+acc so every internal signal is visible for the waveform scripts.
- sim/waves/*.do (8 scripts): setup.do fixes a 10 ns grid, one gridline per cycle; latency.do, coeff.do, throughput.do, stall.do, edges.do, drain.do, fsm.do each add the signals and place the cursors (145 / 515 ns, 3165 / 3195 ns, 795 / 805 ns, 10385 / 10755 ns) that produced docs/figures/waveforms/*.PNG.
- fpga/build.tcl (84 lines): `vivado -mode batch -source fpga/build.tcl`; part xc7z020clg400-1; read_verilog -sv of the seven files, read_xdc; `synth_design -top top -max_dsp 0`; synth_utilization.rpt; opt_design, place_design, route_design; utilization.rpt, utilization_hier.rpt, timing_summary.rpt, drc.rpt; `read_saif fpga/tb_top.saif -strip_path tb_top/dut` when the SAIF exists (hand-set toggle rates are only the fallback branch); report_power -> power.rpt; write_checkpoint; prints and writes summary.txt with LUTs, FFs, SRL, DSP, BRAM, WNS/WHS, Fmax = 1000/(8.000 - WNS) and the FoM.
- fpga/pynq_z2.xdc (71 lines): clock on H16, `create_clock -period 8.000`; all 42 pins LVCMOS33 on real PYNQ-Z2 sites (SW0 M20 = rst_n, PmodA = input_in, PmodB = data_write, Arduino header = write_addr / valid_in / write_en, RPi header = pixel_out, LEDs R14 / P14 = valid_out / busy); `set_false_path` from all_inputs to all_registers, all_registers to all_outputs, and from rst_n.
- fpga/saif.bat + fpga/saif_xsim.tcl: xvlog / xelab / xsim of tb_top; run to 145 ns, open_saif, `log_saif [get_objects -r /tb_top/dut/*]`, run to 10800 ns, close_saif -> fpga/tb_top.saif (the active-convolution window the organiser asked for); fpga/paths.tcl: report_timing filtered to *prod_r_reg*, *row_r_reg*, *pixel_out_reg* -> fpga/reports/paths.rpt, the source of the per-stage slacks +0.742 / +3.799 / +2.666 ns.
- Testbench and model sizes for context: tb_top.sv 138, tb_top_all.sv 183, tb_top_window.sv 189, tb_window_gen_unit.sv 175 lines; golden_model/golden.py 80 lines (details in the testbench and golden-model sections).
**Show:**
- Table: cnn_pkg parameter table - Parameter | Value | Kind | Consumed by | Note - source rtl/cnn_pkg.sv, rows: IMG_W 32 fixed (control_fsm wrap, right_edge; LB_DEPTH); IMG_H 32 fixed (control_fsm wrap, bottom_edge); KSIZE 3 fixed (row_r array, NTAP); NTAP 9 derived = KSIZE^2 (taps, coeff_reg, generate loop); N_MAC 9 fixed, documentation constant (loop iterates NTAP); LB_DEPTH 32 derived = IMG_W (line_buffer DEPTH); IN_W 8 fixed (input_in, taps, line buffers); COEF_W 8 fixed (data_write, coef); COEF_FRAC 0 toggle, 7 = Q1.7 rebuild, declared and not read by any shipping module (no shift stage at Q8.0); OUT_W 16 fixed (pixel_out, clamp width); RELU_EN 0 toggle (default of top's RELU); PROD_W 16 derived = IN_W + COEF_W; ACC_W 20 derived, 9 x 255 x 128 = 293,760; OUT_MAX +32767 derived; OUT_MIN -32768 derived; FILL_CYCLES 34 derived = LB_DEPTH + 2; NPIX 1024 derived = IMG_W x IMG_H; DRAIN_CYCLES 34 derived = FILL_CYCLES; plus top.sv localparam ROW_W 18 derived = PROD_W + 2 and module parameter RELU toggle.
- Table: Module inventory - File | Module | Lines | Purpose | Inputs | Outputs | Parameters | Routed LUTs / FFs - rows from the module bullets above, source rtl/ and fpga/reports/utilization_hier.rpt.
- Table: Register inventory - Register | Module | Bits | Why it exists - prod_r 144, row_r 54, pixel_out 16, v_prod / v_row / valid_out 3, coef_reg 72, tap_reg 72, state (one-hot) 5, in_cnt 10, out_r 5, out_c 5, drain_cnt 6, edge flags 4, delay-line FFs beside the 16 SRLC32E 32, tool-inserted 13, total 441 - sources fpga/reports/utilization_hier.rpt, fpga/reports/synth.log (RTL Component Statistics, Static Shift Register Report).
- Table: Script inventory - Script | Invocation | What it produces - sim/compile.do, sim/run.do, sim/waves/*.do, fpga/build.tcl, fpga/pynq_z2.xdc, fpga/saif.bat + saif_xsim.tcl, fpga/paths.tcl.
- Listing: rtl/multiplier.sv, all 7 lines - shows the use_dsp attribute and the signed' zero-extension; the whole multiplier is one assign.
- Listing: rtl/top.sv lines 143-155 - the saturate block (acc_top, fits, 3-way sat mux) and the RELU mux; the code that iteration (c) replaced two 20-bit compares with.
- Listing: rtl/control_unit.sv lines 41-52 and 98-101 - nxt_c / nxt_r and the four registered flag assignments; the code behind iteration (b).
- Figure: docs/figures/waveforms/kernel_load.PNG - 9 write_en pulses, write_addr 0..8, coef_reg filling while busy is low; the write guard in action.
- Figure: docs/figures/waveforms/stall.PNG - taps hold while valid_in is low, bubble reaches valid_out 3 cycles later; en-gated window vs free-running pipeline.
- Diagram to draw: datapath diagram with the three dashed stage boundaries, registered edge flags and SRL annotation on LB0 / LB1 - reference the datapath-section figure rather than duplicating it - see docs/report/BLOCK_DIAGRAM_NOTES.md.
**Avoid:**
- Do not list mac3x3.sv, saturate.sv or relu.sv as files (the early module map in docs/notes/ARCHITECTURE_LOCKED.md); those functions live inside top.sv and the shipped RTL is exactly seven files.
- Do not describe the line buffers as "FF/LUTRAM shift registers" (stale comment in line_buffer.sv); the routed result is 16 SRLC32E, 0 BRAM.
- Do not claim the Q1.7 (COEF_FRAC = 7) build was synthesised or simulated; only the Q8.0 build has numbers, and COEF_FRAC is a declared toggle that no shipping module reads.
- Do not repeat the README / build.tcl comments that xsim does not run or that toggle rates were hand-set; the reported 0.158 W is SAIF-annotated (Medium confidence, not High) and the hand-set branch is only a fallback.
- Do not say every sequential element is en-gated; the three pipeline stages are deliberately free-running and the valid bit does the gating.
- Do not present 441 as a pure RTL count; 32 delay-line FFs and 13 tool-inserted FFs have no one-to-one RTL name, and the per-module LUT split is indicative only.
- Do not say the FSM is 3-bit encoded in hardware; the enum is 3 bits in RTL, Vivado implemented it one-hot (5 FFs).
- Do not say the kernel is swapped "mid-frame"; the write guard forbids it - the back-to-back run rewrites coefficients the cycle busy falls, while frame 1's last three outputs are still in the pipeline.
- Do not quote sim/run.do's header comment "5 kernels"; the regression is 7 kernels, 22 runs; only the `kernels` target loops the five real filters.
- Do not call frame_done a pin (42 pins total) or claim it is present in the netlist.
- Do not call the design vendor-neutral without the use_dsp caveat, and do not claim it has been run through another vendor's tools.
- Do not say write_bitstream is part of build.tcl (the line is commented out); fpga/top.bit came from the 13 Sep project flow, and no board demo is claimed.
**Sources:** rtl/cnn_pkg.sv, rtl/line_buffer.sv, rtl/window_gen.sv, rtl/multiplier.sv, rtl/coeff_reg.sv, rtl/control_unit.sv, rtl/top.sv, sim/compile.do, sim/run.do, sim/waves/*.do, fpga/build.tcl, fpga/pynq_z2.xdc, fpga/saif.bat, fpga/saif_xsim.tcl, fpga/paths.tcl, fpga/reports/utilization.rpt, fpga/reports/utilization_hier.rpt, fpga/reports/synth.log, fpga/reports/paths.rpt, docs/notes/DESIGN_ITERATIONS.md, docs/notes/ARCHITECTURE_LOCKED.md, docs/report/BLOCK_DIAGRAM_NOTES.md, fpga/reports/RESULTS.md, tb/tb_top_all.sv

---

## 9. Testbench
**Required by:** spec item 8 ("verified against a golden reference model ... The report should include test cases, expected outputs, hardware outputs, and a comparison showing correctness"); instruction 2 ("Verify the RTL against a golden model using multiple test cases"); deliverable "testbench"; Table 1 row "Verification status".
**Say:**
- Four SystemVerilog testbenches in tb/, compiled by sim/compile.do and launched by sim/run.do from the project root (ModelSim ASE 2020.1, 10 ns TB clock): tb_top_all.sv (22-run regression), tb_top.sv (one kernel, used for the waveform captures), tb_top_window.sv (window generator + FSM checked at the top level), tb_window_gen_unit.sv (window_gen in isolation). Commands: `do sim/compile.do` then `do sim/run.do all | window | unit | <kernel> [1]`.
- (REQUIRED) Test cases: 7 kernels (identity, sobel_x, sobel_y, sharpen, laplacian, satmax, satmin) on the 32x32 image golden_model/hex/image.hex (cat.png resized), each in three stall modes (clean, fixed stalls, random stalls) = 21 runs, plus one back-to-back run (sobel_x frame immediately followed by a sharpen frame, 2048 outputs) = 22 runs.
- (REQUIRED) Expected outputs: golden_model/hex/<k>_out.hex and <k>_relu_out.hex (1024 lines each, 16-bit two's-complement hex, raster order), produced by golden.py (section 10).
- (REQUIRED) Hardware outputs: hw_out/<k>_out.hex and hw_out/<k>_relu_out.hex, 14 files, 1024 lines each, written by tb_top_all during the clean run of each kernel (RELU=0 DUT and RELU=1 DUT respectively), same %04h format as the golden files.
- (REQUIRED) Comparison: (a) cycle-by-cycle inside the TB - every valid_out is compared against the next queued expected value for both DUTs, err = 0 and relu_err = 0 in all 22 runs; (b) file level - all 14 hw_out files are byte-identical to their golden counterparts. A judge can check (b) with `diff hw_out/sobel_x_out.hex golden_model/hex/sobel_x_out.hex` (empty output = identical) or `for f in hw_out/*.hex; do cmp $f golden_model/hex/$(basename $f) && echo "$f identical"; done` (`fc` on Windows).
- Regression result: 22 runs, 0 failed, PASS; the whole regression is 285645 ns of simulated time and runs in a few seconds (3.48 s process time in ModelSim ASE). Rerunning it rewrites hw_out/ with identical bytes (deterministic stimulus, fixed seed).
- Two DUTs on one stimulus: `top dut` (RELU=0) and `top #(.RELU(1'b1)) dut_r` share clk, rst_n, input_in, valid_in and the coefficient writes; each has its own expected queue (<k>_out.hex vs <k>_relu_out.hex); every cycle the TB also requires `vo_r === vo` (both builds assert valid_out on the same cycles), so ReLU is verified on all 7 kernels x 3 modes with zero extra stimulus.
- Every run loads its kernel through the write port (9 writes, write_addr 0..8, data from <k>_coef.hex) while busy is low - 23 port loads in the regression (21 single runs + 2 in the back-to-back run); kernel programmability is exercised, not assumed.
- Stall injection: while valid_in is low the TB drives 8'hA5 on input_in (junk), and it keeps 8'hA5 on the bus after the last pixel for the whole DRAIN - proves that en gates the window and that the bottom/right masks hide whatever is on the bus.
- Fixed stalls (mode 1, +STALL=1 in tb_top): valid_in dropped before pixel 10 (2 cycles, still in FILL), 300 (3), 511 (1, last pixel of a row), 700 (8), 1023 (4, right before the last pixel) = 18 cycles injected, 16 of them in STREAM, 16 bubbles observed in valid_out in every +stalls run; the 2 FILL-time stalls only delay the first output (tb_top +STALL=1 reports latency 39 = 37 + 2 and 1024 outputs in 1040 cycles = 1024 + 16).
- Random stalls (mode 2): each pixel with probability 1/5 held 1-4 cycles (`$urandom % 5 == 0 ? $urandom % 4 + 1 : 0`), seed fixed by `$urandom(1)` so the runs reproduce; injected stall cycles per run 493-558 (table), STREAM stalls 476-538, bubbles equal to STREAM stalls in every run.
- Latency invariant checked every clock (lat_err): valid_out must equal win_valid delayed by exactly 3 cycles (3-bit shift register wv_d on dut.win_valid); lat_err = 0 in all 22 runs - this is the proof that a stall becomes a bubble three cycles later and never a shifted or corrupted output.
- Bubble accounting: bubbles = empty cycles between consecutive valid_out cycles; stall_stream = cycles with valid_in low while u_cu.state == STREAM after the first window; pass requires bubbles == stall_stream. In the back-to-back run this check is intentionally off: its 44 reported bubbles are the inter-frame gap = 10 cycles of coefficient load (9 writes + 1) + 37 latency - 3 (busy falls 3 cycles before frame 1's last valid_out).
- Output-count check: exactly 1024 valid_out per frame (2048 for back-to-back); an extra valid_out with an empty expected queue counts as an error, a non-empty queue at the end fails the run.
- Pass criterion per run: out_cnt == nframes x 1024, err == 0, relu_err == 0, lat_err == 0, expected queue empty, bubbles == STREAM stalls (where checked).
- Back-to-back run: sobel_x frame streams, the TB waits for busy to fall (3 cycles before frame 1's final valid_out), writes the sharpen coefficients through the port and streams frame 2 with no idle gap; 2048 outputs, 0 errors - proves reload-between-frames and that the write lock releases at the right moment (evidence for the multiple-kernels bonus).
- tb_top.sv: one kernel via +KERNEL=<name>, optional +STALL=1, diffs pixel_out against <k>_out.hex, writes hw_out/<k>_out.hex, prints outputs, latency, throughput, stalls/bubbles, pixel errors, PASS/FAIL; clean sobel_x: 1024/1024 outputs, latency 37, 1024 outputs in 1024 cycles, 0 errors. This is the TB behind all seven tb_top waveform captures and behind the xsim run that produced the power SAIF (same TB, second simulator).
- tb_top_window.sv: control_fsm + window_gen as integrated in top, hramp vector (golden_model/vectors/hramp_in.hex and hramp_windows_same.hex); every win_valid cycle it checks (1) all 9 tap_out against the golden window, (2) u_cu.out_r/out_c against the raster position, (3) the four edge flags against that position, (4) no gap in win_valid; also fill latency == FILL_CYCLES and exactly 1024 windows. Result: 1024 windows, fill latency 34 cycles, 1024 windows over 1024 cycles, 0 tap errors, 0 position/edge errors, 0 gaps, PASS. pixel_out is not checked here.
- tb_top_window also prints the FSM trace with counters: IDLE->FILL at cyc 2, FILL->STREAM at cyc 35 (in_cnt = 34), STREAM->DRAIN at cyc 1025, DRAIN->DONE at cyc 1059 (drain_cnt = 34), DONE->IDLE at cyc 1060 - the 34 / 1024 / 34 / 1 cycle structure of section 4, measured.
- tb_window_gen_unit.sv: window_gen alone, en and the four edge flags driven directly, a shadow model of LB0, LB1 and the 9 taps stepped in lockstep. T1 shift correctness: 116 enabled cycles (3x32+20) of a ramp with all 9 taps checked every cycle; T2 stall freeze: en low for 5 cycles with 0xEE on the bus, taps must hold, then one enabled step resumes correctly; T3 single-edge zeroing: top, bottom, left, right one at a time, centre tap must keep tracking; T4 corner overlap: all four corners, explicit check that top-left zeros taps 0,1,2,3,6 and leaves tap 4. Result: 0 errors in all four tests, PASS.
- Coverage in one line for Table 1 "Verification status": 22/22 runs pass, 7 kernels x 1024 pixels bit-exact vs the Python golden model, both saturation branches (satmax/satmin), ReLU on every kernel, fixed and random stalls, two frames back to back, plus window-level and unit tests with 0 errors.
- Window-level vectors available beyond hramp: vramp, impulse, random, ring (section 10); tb_top_window reads hramp by name.
**Show:**
- Table 9.1: Regression matrix (22 rows) - columns: Run | Kernel | Stall mode | Outputs | Pixel errors (RELU=0) | ReLU errors (RELU=1) | Bubbles / STREAM stalls (injected) | lat_err | Result - source: the `do sim/run.do all` transcript. Rows: 1 identity clean 1024 0 0 0/0 (0) 0 ok; 2 identity fixed 1024 0 0 16/16 (18) 0 ok; 3 identity random 1024 0 0 534/534 (558) 0 ok; 4 sobel_x clean 1024 0 0 0/0 (0) 0 ok; 5 sobel_x fixed 1024 0 0 16/16 (18) 0 ok; 6 sobel_x random 1024 0 0 476/476 (502) 0 ok; 7 sobel_y clean 1024 0 0 0/0 (0) 0 ok; 8 sobel_y fixed 1024 0 0 16/16 (18) 0 ok; 9 sobel_y random 1024 0 0 523/523 (551) 0 ok; 10 sharpen clean 1024 0 0 0/0 (0) 0 ok; 11 sharpen fixed 1024 0 0 16/16 (18) 0 ok; 12 sharpen random 1024 0 0 479/479 (493) 0 ok; 13 laplacian clean 1024 0 0 0/0 (0) 0 ok; 14 laplacian fixed 1024 0 0 16/16 (18) 0 ok; 15 laplacian random 1024 0 0 480/480 (498) 0 ok; 16 satmax clean 1024 0 0 0/0 (0) 0 ok; 17 satmax fixed 1024 0 0 16/16 (18) 0 ok; 18 satmax random 1024 0 0 538/538 (555) 0 ok; 19 satmin clean 1024 0 0 0/0 (0) 0 ok; 20 satmin fixed 1024 0 0 16/16 (18) 0 ok; 21 satmin random 1024 0 0 512/512 (537) 0 ok; 22 sobel_x -> sharpen back-to-back, clean, 2048 0 0 44/0 (0, bubble check off: inter-frame gap) 0 ok. Footer: 22 runs, 0 failed, PASS.
- Table 9.2: Expected vs hardware files (14 rows) - columns: Kernel | Expected file (golden_model/hex/) | Hardware file (hw_out/) | Lines | cmp result | Output range - rows: identity 41..255 (identical to image.hex line for line); sobel_x -715..875; sobel_y -898..934; sharpen -169..557; laplacian -357..241; satmax 32767 on all 1024; satmin -32768 on all 1024; and the seven _relu_out pairs (identity 41..255, sobel_x 0..875, sobel_y 0..934, sharpen 0..557, laplacian 0..241, satmax 32767, satmin 0 on all 1024); every row: 1024 lines, identical.
- Table 9.3: Fixed stall schedule - columns: Pixel index | (row, col) | Cycles held | FSM state | Bubbles expected - rows: 10 (0,10) 2 FILL 0; 300 (9,12) 3 STREAM 3; 511 (15,31) 1 STREAM 1; 700 (21,28) 8 STREAM 8; 1023 (31,31) 4 STREAM 4; total 18 injected, 16 in STREAM, 16 bubbles.
- Text box: sample values - sobel_x_out.hex lines 1-5 are 0131 ffc8 0037 00e4 0101 = 305, -56, 55, 228, 257 in both golden and hw_out, and the same 305, -56, 55, 228, 257 are readable on docs/figures/waveforms/latency.PNG at the first valid_out.
- Figure cross-reference: docs/figures/waveforms/stall.PNG (section 11) - the bubble mechanism that Table 9.1's bubbles/stalls column counts.
- Optional text box: the 22-line summary block from the transcript as printed.
**Avoid:**
- Do not call the datapath test "exhaustive" or "formal"; only the saturation check was exhaustive (all 2^20 accumulator values, in Python). The RTL was tested on 7 kernels x 1024 pixels x 3 modes.
- Do not say the random stalls differ from run to run - the seed is fixed, the numbers in Table 9.1 reproduce exactly.
- Do not claim gate-level or post-route simulation; this is RTL simulation (timing is by STA in the timing section).
- Do not describe hw_out/ as board output - it is RTL simulation output; no board demo is claimed.
- Do not write "5 kernels" (older notes) - the regression has 7.
- Do not present the back-to-back run's 44 bubbles as stalls or as a defect; the bubble check is disabled there by design and the 44 is the coefficient-load plus fill gap.
- Do not quote the tb_top +STALL=1 latency of 39 as the design latency; the design latency is 37, the extra 2 are the injected FILL-time stall.
**Sources:** tb/tb_top_all.sv, tb/tb_top.sv, tb/tb_top_window.sv, tb/tb_window_gen_unit.sv, sim/run.do, sim/compile.do, README.md, hw_out/, golden_model/hex/, the `do sim/run.do all` transcript (and `do sim/run.do window`, `unit`, `sobel_x 1`).

## 10. Golden model
**Required by:** spec item 8 ("golden reference model implemented in Python, MATLAB, or C"); deliverables "golden model", "input test images", "expected output files"; supports spec item 6 (evidence that saturation is handled as explained).
**Say:**
- (REQUIRED) golden_model/golden.py, Python 3 + numpy; Pillow only to load a PNG and write the preview renders. The convolution path is pure integer arithmetic - Python ints, no floating point, no rounding anywhere.
- conv(img, k, relu): for every output (y, x) in 0..31: acc = sum over dy, dx in {-1, 0, 1} of img[y+dy, x+dx] * k[dy+1, dx+1], taps that fall outside the image are skipped - that is zero padding, "same" convolution, 1024 outputs per frame; then acc = max(-32768, min(32767, acc)) - the clamp that defines the required saturation behaviour; if relu and acc < 0 then 0 - ReLU after saturation, the same order as the RTL (saturate, then the ReLU mux).
- Kernel orientation (state as an assumption): k[row][col] is applied unflipped to the window, i.e. cross-correlation, the usual CNN convention; identical to the RTL, which multiplies tap[n] by coef[n] with tap[0] = top-left of the window and write_addr = 3*row + col.
- Input image: golden_model/cat.png -> PIL convert("L") -> resize to 32x32 -> uint8 -> hex/image.hex (1024 lines, %02x, one pixel per line, raster order); the pixel values in the shipped file span 41..255.
- The shipped outputs were generated with `python golden.py hex/image.hex`, which re-reads the existing image.hex so the outputs stay in sync with the image the testbenches read; `python golden.py cat.png` builds a new image.hex from the PNG; no argument gives a seed-0 random image (not used for the submission).
- Seven kernels as Python lists in KERNELS: identity [[0,0,0],[0,1,0],[0,0,0]]; sobel_x [[-1,0,1],[-2,0,2],[-1,0,1]]; sobel_y [[-1,-2,-1],[0,0,0],[1,2,1]]; sharpen [[0,-1,0],[-1,5,-1],[0,-1,0]]; laplacian [[0,1,0],[1,-4,1],[0,1,0]]; satmax all +127; satmin all -128. All coefficients are 8-bit signed integers (Q8.0), the shipping precision.
- (REQUIRED) satmax / satmin rationale: on this image the real kernels never leave -898..+934 (sobel_y is the widest), so the 20-bit-to-16-bit clamp would never fire and both saturation branches would be untested; satmax (all +127) drives every one of the 1024 outputs to +32767 and satmin (all -128) drives all 1024 to -32768; satmin with ReLU gives 1024 zeros, which checks that ReLU sees the clamped value. These are the only test cases that make acc[19:15] leave the all-equal pattern in the RTL.
- Coefficient files: hex/<k>_coef.hex, 9 lines, %02x, two's complement (c & 0xff), line n = write_addr n = row-major tap n; contents: identity 00 00 00 00 01 00 00 00 00; sobel_x ff 00 01 fe 00 02 ff 00 01; sobel_y ff fe ff 00 00 00 01 02 01; sharpen 00 ff 00 ff 05 ff 00 ff 00; laplacian 00 01 00 01 fc 01 00 01 00; satmax 7f x 9; satmin 80 x 9. The testbenches drive these bytes straight onto data_write.
- Output files: hex/<k>_out.hex and hex/<k>_relu_out.hex, 1024 lines, %04x, 16-bit two's complement (v & 0xffff), raster order, line n = output pixel (n div 32, n mod 32); decode rule for a reader: value > 0x7fff means value - 65536 (this is what hw_to_png.py and the TB's $signed do). hw_out/ uses the same format (%04h), which is why a plain diff is meaningful.
- golden.py prints the accumulator range per kernel; from the shipped files: identity 41..255, sobel_x -715..875, sobel_y -898..934, sharpen -169..557, laplacian -357..241, satmax 32767..32767, satmin -32768..-32768. These ranges are also the justification that 16-bit output never clips for the standard kernels (section 7).
- Built-in alignment check: identity_out.hex equals image.hex line for line (only tap e times 1 survives), so any tap-to-coefficient misalignment in the RTL would fail the identity run first.
- Preview renders: png/image.png and png/<k>.png, min-max normalised to 0..255 and upscaled 8x nearest-neighbour - for looking at, not for comparison (normalisation discards absolute values); the hex files are the comparison.
- golden_model/hw_to_png.py renders hw_out/<k>_out.hex (the RTL output, not the model) beside hex/image.hex at 6x into docs/figures/edge_demo_<k>.png; the edge-detection bonus figures therefore show hardware outputs.
- Window-level model and vectors (golden_model/vectors/): <name>_in.hex (1024 lines, %02x, raster) and <name>_windows_same.hex (1024 lines x 9 space-separated hex bytes, tap order a b c d e f g h i row-major), the zero-padded "same" windows in raster order - each windows file is exactly the 3x3 slices of the 1-pixel zero-padded input (checked with numpy for all five).
- Five patterns and what each isolates: hramp pixel = 8 x col (0..248, every row identical) - horizontal shift order a->b->c; vramp pixel = 8 x row - line-buffer alignment across rows; impulse a single 255 at (row 10, col 17), 0 elsewhere - the 255 must appear in exactly 9 windows, at a different tap in each; random 0..255 (250 distinct values) - no accidental symmetry; ring 255 on rows 0 and 31 and columns 0 and 31, 0 inside - the border/mask stress case where a padded zero and a real pixel differ.
- golden_model/view_windows.py prints any window by index, by (row, col), by range, `all`, or `valid` (the 30x30 interior), with -d decimal, -s source pixels (".." for off-image) and -c compact; golden_model/hramp_windows_all.txt and hramp_windows_all_grid.txt are its full dumps for hramp and are the key for reading the window-generator captures in section 11.
- Regeneration: `cd golden_model && python golden.py hex/image.hex` (README); the window vectors are shipped as fixed files.
**Show:**
- Table 10.1: Kernels - columns: Name | 3x3 matrix | coef.hex bytes (write_addr 0..8) | Purpose | Output range on image.hex (RELU=0) - 7 rows from the bullets above.
- Table 10.2: File formats - columns: File | Lines | Format | Encoding | Written by | Read by - rows: hex/image.hex 1024 %02x unsigned golden.py / $readmemh in all TBs; hex/<k>_coef.hex 9 %02x two's complement row-major golden.py / TB write-port loop; hex/<k>_out.hex 1024 %04x two's complement golden.py / TB expected queue; hex/<k>_relu_out.hex same for the RELU=1 DUT; hw_out/<k>_out.hex and _relu_out.hex 1024 %04h tb_top_all / diff and hw_to_png.py; vectors/<n>_in.hex 1024 %02x / tb_top_window; vectors/<n>_windows_same.hex 1024 x 9 bytes / tb_top_window.
- Table 10.3: Window vectors - columns: Name | Pattern | What it isolates | Files - 5 rows.
- Code listing: the conv() function (about 15 lines) verbatim - the entire reference in one box, so a judge sees the padding, the clamp and the ReLU order.
- Figure: golden_model/png/image.png next to golden_model/png/sobel_x.png - golden renders (optional; the hardware renders docs/figures/edge_demo_sobel_x.png, docs/figures/edge_demo_sobel_y.png, docs/figures/edge_demo_laplacian.png belong to the demo/bonus part).
**Avoid:**
- Do not call it a floating-point reference and do not mention rounding - integers throughout, clamp only.
- Do not say the kernel is flipped (true convolution) - both model and RTL correlate; state the convention once.
- Do not claim a cross-check against scipy or OpenCV unless one is actually run.
- Do not claim the window-vector generator script is shipped - only the vectors are (docs refer to an older window_model_same.py that is not in the repo); say the vectors are fixed files that match the numpy zero-padding rule.
- Do not claim the golden model covers the Q1.7 COEF_FRAC rebuild - golden.py is Q8.0 integer only.
- Do not imply the PNG renders were compared - the hex files were.
**Sources:** golden_model/golden.py, golden_model/hw_to_png.py, golden_model/view_windows.py, golden_model/hex/, golden_model/vectors/, golden_model/hramp_windows_all.txt, README.md, docs/notes/ARCHITECTURE_LOCKED.md (tap order S8, vector list), rtl/top.sv (saturate/ReLU order), rtl/coeff_reg.sv (write_addr order).

## 11. Waveform screenshots
**Required by:** deliverable "waveform screenshots"; supports spec item 8 (correctness) and the bonus items "one-output-pixel-per-cycle pipelined architecture" and "support for multiple kernels".
**Say:**
- Ten captures in docs/figures/waveforms/, all ModelSim ASE 2020.1 wave-window exports (File > Export > Image), 10 ns testbench clock, one gridline per cycle, timeline in ns - divide any cursor delta by 10 to get cycles. Seven come from tb_top with the sobel_x kernel, three from the window-generator run on the hramp vector.
- The seven tb_top captures were retaken on 14 Sep from the tagged RTL with the scripted setups sim/waves/latency.do, coeff.do, throughput.do, stall.do, edges.do, drain.do, fsm.do (`do sim/run.do sobel_x`, or `do sim/run.do sobel_x 1` for stall.PNG, then `do sim/waves/<name>.do`); cursor times are fixed in the scripts (145/515, 3165/3195, 795/805, 10385/10755 ns), so the numbers below are reproducible.
- Radix conventions: pixel_out decimal, taps and input_in hex, state as the enum name, counters unsigned.
- Every pixel value quoted in a caption can be looked up in golden_model/hex/sobel_x_out.hex (line n+1 = output n, two's-complement hex) and every tap value in golden_model/hex/image.hex (line 32*row + col + 1) or golden_model/vectors/hramp_windows_same.hex.
- Order in the report: latency (fill) -> kernel_load -> throughput -> stall -> edges -> drain -> fsm -> the three window-generator captures.
- Figure 11.1 docs/figures/waveforms/latency.PNG - signals: clk, rst_n, input_in (hex), valid_in, write_en, busy, valid_out, pixel_out (dec); cursors "first pixel in" 145 ns and "first pixel out" 515 ns, delta 370 ns = 37 cycles; visible: write_en already low before 145 ns (coefficient load finished), busy rising after the first accepted pixel, input_in 61 64 49 77 ... = image.hex lines 1-4, pixel_out toggling while valid_out is low (pipeline contents during fill, not outputs), then at 515 ns valid_out high with pixel_out = 305 = 0x0131 = sobel_x_out.hex line 1, followed by -56, 55, 228, 257 (lines 2-5). Caption gist: first valid_in at 145 ns to first valid_out at 515 ns is 370 ns = 37 cycles (34 window fill + 3 pipeline), and the first output 305 matches the golden file.
- Figure 11.2 docs/figures/waveforms/kernel_load.PNG - signals: clk, rst_n, write_en, write_addr (uns), data_write (dec), dut/u_cr/coef_reg (dec, 9 entries), busy; reference cursor at 145 ns (first pixel in); visible: rst_n released, nine consecutive write_en cycles with write_addr 0..8 and data_write -1 0 1 -2 0 2 -1 0 1 (sobel_x, row-major), coef_reg filling one entry per write to -1 0 1 -2 0 2 -1 0 1, busy low throughout so every write is accepted, all before the first pixel. Caption gist: the kernel is loaded through the write port in 9 cycles while busy is low; write_addr = 3*row + col.
- Figure 11.3 docs/figures/waveforms/throughput.PNG - as shipped this is the whole frame, not a mid-frame zoom: signals clk, valid_in, input_in, busy, valid_out, pixel_out; cursors "First Pixel out" 515 ns and "Last pixel out" 10755 ns, delta 10240 ns = 1024 cycles; valid_out is one unbroken high bar between the cursors = 1024 outputs in 1024 consecutive cycles, no bubble in a clean frame; busy high from the first pixel until 3 cycles before the end. Caption gist: valid_out stays high for 10240 ns = 1024 consecutive cycles - one output pixel per clock for the entire frame. Optional: add a zoomed inset with throughput.do's `wave zoom range 3000ns 3300ns` so individual pixel_out transitions are visible (the WAVEFORM_CAPTURES.md note asked for about 30 cycles).
- Figure 11.4 docs/figures/waveforms/stall.PNG (run with +STALL=1) - signals: clk, valid_in, input_in (hex), dut/en, dut/tap_out (hex, 9 values), dut/win_valid, valid_out, pixel_out (dec); cursors "valid_in drops" 3165 ns and "bubble reaches valid_out" 3195 ns, delta 30 ns = 3 cycles; visible: valid_in low 3165-3195 ns with input_in = a5 (junk) during the gap, en and win_valid low for exactly the same three cycles, tap_out frozen at 71 8f 97 6b 75 63 75 67 5c (image rows 7-9, columns 9-11), valid_out low 3195-3225 ns; pixel_out before the gap 92, -6, -6 (outputs 263-265) and after it -3, -66, 83, 261 (outputs 266-269) = sobel_x_out.hex lines 264-270 consecutively, so nothing is lost or repeated; -3 is the sobel_x response of the frozen window, output (8,10). Caption gist: a 3-cycle valid_in stall freezes the window and reappears as a 3-cycle bubble in valid_out exactly 30 ns later; the output sequence around it is unbroken. Note: in this run the first valid_out is at 535 ns (the 2-cycle FILL stall shifts the frame by 20 ns), not 515.
- Figure 11.5 docs/figures/waveforms/edges.PNG - signals: clk, u_cu/out_r, u_cu/out_c (uns), top_edge, bottom_edge, left_edge, right_edge, win_valid, tap_out[0..8] expanded (hex); cursors "col 31, right_edge" 795 ns and "col 0, left_edge" 805 ns, 10 ns apart; visible: out_c 31 -> 0 and out_r 0 -> 1 at 805 ns; right_edge a one-cycle pulse at 795, left_edge a one-cycle pulse at 805; top_edge high for all of row 0 and falling at 805; at 795 ns (window (0,31)) taps 2, 5, 8 (c f i) are 00 while tap 3 = 67 = image(0,30), tap 4 = 4f = image(0,31), tap 6 = 60 = image(1,30); at 805 ns (window (1,0)) taps 0, 3, 6 (a d g) are 00 while tap 1 = 61 and tap 2 = 64 (image(0,0), (0,1)), tap 4 = 65 and tap 5 = 69 (image(1,0), (1,1)), tap 7 = 66 and tap 8 = 6e (image(2,0), (2,1)); taps 0-2 are 00 throughout row 0 (top mask) and carry row-0 pixels from 805 ns on; the centre tap 4 is never 00; the next right/left pulse pair is visible at the following row boundary. Caption gist: at column 31 right_edge zeros c, f, i and one cycle later at column 0 left_edge zeros a, d, g, while the centre tap always carries the real pixel - zero padding by masks, flags landing on the right cycle.
- Figure 11.6 docs/figures/waveforms/drain.PNG - signals: clk, valid_in, u_cu/state (enum), u_cu/drain_cnt (uns), busy, win_valid, valid_out, pixel_out (dec), frame_done; cursors "last pixel in" 10385 ns and "last pixel out" 10755 ns, delta 370 ns = 37 cycles (34 drain + 3 pipeline, the mirror of the fill latency); visible: valid_in low from 10385 ns while state = S_DRAIN and drain_cnt counts 0..33, win_valid held high (en forced), valid_out high through the whole drain and falling at 10755 ns, busy falling at 10725 ns = 3 cycles earlier, frame_done a one-cycle pulse in S_DONE (10725-10735 ns), then S_IDLE; pixel_out at the 10385 ns cursor = -46 = output 987 (line 988). S_DONE is one cycle wide and too narrow to read at this zoom, so the value column shows S_DRAIN. Caption gist: after the last input the FSM drains 34 more windows from the masked taps, valid_out reaches exactly 1024, frame_done pulses, and busy falls 3 cycles before the last valid_out because the last window is already in the pipeline.
- Figure 11.7 docs/figures/waveforms/fsm.PNG - signals: clk, valid_in, u_cu/state, u_cu/in_cnt, u_cu/out_r, u_cu/drain_cnt, busy, valid_out, frame_done; whole frame (zoom full, 0-10805 ns); visible: S_STREAM spanning nearly the whole frame, out_r stepping 0..31, in_cnt ramping to 1023 then clearing, drain_cnt ramping at the end, busy and valid_out envelopes, the frame_done pulse; the state durations to quote come from the tb_top_window trace: FILL->STREAM at in_cnt = 34, STREAM lasts 990 cycles (cyc 35 to 1025 in the trace), DRAIN->DONE at drain_cnt = 34, DONE is 1 cycle; the frame spans first valid_in 145 ns to last valid_out 10755 ns = 1061 cycles for 1024 outputs (0.965 sustained). The four hand-placed cursors in the file (5 / 313.984 / 10503.562 / 10730.067 ns) are off-edge; re-snap them to the state transitions with Tab so the deltas are whole cycles, or leave cursors out of the caption. Caption gist: one frame through IDLE, FILL, STREAM, DRAIN, DONE and back to IDLE with in_cnt, out_r and drain_cnt driving the transitions.
- Figures 11.8-11.10 are the window-generator captures (9 Sep, hramp vector, signals /tb_top/clk, /tb_top/rst_n, /tb_top/input_in, /tb_top/dut/taps[0..8], /tb_top/dut/win_valid - taps was a debug port, since commented out in top.sv); the hramp input steps 00 08 10 ... f8 (8 x column, identical on every row). Per docs/notes/FINAL_TWO_DAYS.md the later RTL commits do not change these pictures (same tap values on the same cycles, confirmed by tb_top_window's 0 position/edge errors on the tagged RTL).
- Figure 11.8 docs/figures/waveforms/Window_generator_producing_valid_taps.PNG - cursor on the first win_valid rising edge; at that instant taps = 00 00 00 | 00 00 08 | 00 00 08 = line 1 of hramp_windows_same.hex = window (0,0): top row and left column padded, e = image(0,0) = 00, f = 08, i = 08; taps 0-2 stay 00 across the visible span (row 0, top mask) while rows d-f and g-i fill from LB0 and the input. Caption gist: the first valid window appears with exactly the golden contents for (0,0), after the 34-cycle fill.
- Figure 11.9 docs/figures/waveforms/Window_generator_producing_valid_taps2.PNG - mid-frame, win_valid high throughout; each tap row holds three consecutive ramp values and shifts one column per clock (c8 d0 d8 -> d0 d8 e0 -> ...); the three rows are identical because hramp has no vertical variation, which is what a correctly aligned LB0/LB1 pair must show; the ramp wraps f8 -> 00 at the row boundary. Caption gist: with both line buffers full, the 3x3 window slides one column per clock and the three rows agree.
- Figure 11.10 docs/figures/waveforms/Window_generator_producing_last_valid_taps.PNG - end of frame, input_in = a5 (junk) during the drain; cursor on the last win_valid cycle: taps = f0 f8 00 | f0 f8 00 | 00 00 00 = line 1024 of hramp_windows_same.hex = window (31,31): right column c f i and bottom row g h i masked, e = f8 = image(31,31); the a5 values reach the taps only after win_valid has fallen. Caption gist: the last window (31,31) is correct with the junk on the bus masked out, and win_valid drops before the junk can reach a valid window.
**Show:**
- Figures 11.1-11.10 at the paths above, in the order listed.
- Table 11.1: Capture index - columns: Figure | File | Run | Setup script | Cursors (ns) | Number it proves - rows: 11.1 latency.PNG sobel_x latency.do 145/515 37 cycles; 11.2 kernel_load.PNG sobel_x coeff.do 145 9 writes, addr 0..8; 11.3 throughput.PNG sobel_x throughput.do 515/10755 1024 outputs in 1024 cycles; 11.4 stall.PNG sobel_x +STALL=1 stall.do 3165/3195 3-cycle bubble, 3 cycles later; 11.5 edges.PNG sobel_x edges.do 795/805 masks c f i then a d g; 11.6 drain.PNG sobel_x drain.do 10385/10755 34 + 3 drain, busy 3 cycles early; 11.7 fsm.PNG sobel_x fsm.do (re-snap) 34 / 990 / 34 / 1; 11.8-11.10 window captures hramp - first, sliding, last window.
**Avoid:**
- Do not quote the off-edge cursor values in fsm.PNG (313.984, 10503.562, 10730.067 ns or the deltas 10189.578 and 226.505 ns).
- Do not quote "495" (visible at the right of throughput.PNG and drain.PNG) as an output value - it is the register content after the last valid output, with valid_out low; the last valid output is -401 = 0xfe6f, line 1024.
- Do not reuse 515 ns as the first-output time in the stall.PNG caption - in that run it is 535 ns.
- Do not describe throughput.PNG as a mid-frame zoom - as shipped it is the whole frame; either caption it that way or retake with the 3000-3300 ns zoom.
- Do not say the three window captures come from tb_window_gen_unit.sv - the signal paths (/tb_top/dut/taps) show a top-level run on the hramp vector; call them window-generator captures. Do not claim the left mask is visible in 11.9 - with hramp the column-0 pixel is itself 00; edges.PNG shows the masks with real image data.
- Do not present the waveforms as board measurements or at 125 MHz - they are RTL simulation at the 10 ns testbench clock.
- Do not state cycle counts without the 10 ns-per-cycle note somewhere on the page.
**Sources:** docs/notes/WAVEFORM_CAPTURES.md, sim/waves/setup.do, latency.do, coeff.do, throughput.do, stall.do, edges.do, drain.do, fsm.do, tb/tb_top.sv, golden_model/hex/sobel_x_out.hex, golden_model/hex/image.hex, golden_model/vectors/hramp_windows_same.hex, golden_model/hramp_windows_all.txt, docs/notes/FINAL_TWO_DAYS.md ("Do the waveforms need retaking?"), the `do sim/run.do window` transcript (FSM trace cycles).

---

## 12. FPGA synthesis results
**Required by:** Spec 9 "synthesis and implementation results, including LUTs, FFs, DSPs, BRAMs"; Instruction 3 "Report FPGA utilization"; judging criterion "FPGA resource usage"; FoM item 10 (LUTs, DSPs, BRAMs form the denominator).
**Say:**
- (REQUIRED, organiser item: device and board) xc7z020clg400-1, PYNQ-Z2 (TUL), Zynq-7000, speed grade -1; the target board is fixed (PYNQ-Z2 is a hard requirement of the design).
- Tool: Vivado 2025.2 (v2025.2 win64, Build 6299465); flow synth_design -> opt_design -> place_design -> route_design; every number in this section is from the routed design (report headers: "Design State : Routed", 13 Sep 2026).
- Constraints: fpga/pynq_z2.xdc, 125 MHz clock on H16 (8.000 ns), all 42 pins on their real PYNQ-Z2 package locations, LVCMOS33 everywhere.
- Headline routed utilization: 879 slice LUTs (863 LUT as logic + 16 LUT as shift register), 441 slice registers (438 FDRE + 3 FDSE, 0 latches), 0 DSP48, 0 block RAM tiles, 42 bonded IOB, 1 BUFG.
- Device share: LUTs 1.65% of 53200, FFs 0.41% of 106400, IOB 33.60% of 125 (the pin count is the 42-port interface, not the core); 279 slices (157 SLICEL + 122 SLICEM), 16 unique control sets, 0 F7/F8 muxes.
- Post-synthesis estimate was 910 LUTs (894 logic + 16 SRL, 441 FFs) - synth_utilization.rpt; that report itself says "The Final LUT count, after physical optimizations and full implementation, is typically lower. Run opt_design after synthesis"; post-route 879 is the number used everywhere (FoM, Table 1); the 31-LUT difference is opt_design and LUT packing (284 of the 863 logic LUTs use both O5 and O6 outputs, utilization.rpt section 2).
- Hierarchical breakdown (routed, utilization_hier.rpt): 9 x mult8x8 = 496 LUTs (five at 52, four at 59); control_fsm 80 LUTs / 35 FFs; coeff_reg 120 LUTs / 72 FFs; window_gen 132 LUTs (116 logic + 16 SRL) / 117 FFs; top-level adder tree + saturate + ReLU + pipeline registers 90 LUTs / 217 FFs.
- (REQUIRED caveat) the block LUT numbers are indicative, not exact: they sum to 918 against the flat 879 because Vivado combines LUTs across hierarchy boundaries - quote the report's own footnote: "The sum of lower-level cells may be larger than their parent cells total, due to cross-hierarchy LUT combining"; the FF split (217 + 72 + 35 + 117) sums to 441 exactly.
- FF inventory, traceable to the RTL: top 217 = prod_r 9 x 16 = 144 + row_r 3 x 18 = 54 + pixel_out 16 + valid chain 3; coeff_reg 72 = 9 x 8; control_fsm 35 = in_cnt 10 + out_r 5 + out_c 5 + drain_cnt 6 + 4 registered edge flags + 5 one-hot state bits (Vivado re-encoded the 5-state enum one-hot: FSM_onehot_state_reg appears in the timing report); window_gen 117 = 72 tap bits + the end stages Vivado kept as flip-flops on the extracted SRL chains.
- The multipliers are about 56% of the LUTs (496 of 879) and are irreducible while the coefficients stay programmable (mandatory spec 3); each 8u x 8s multiplier is 52-59 LUTs of LUT6 + CARRY4.
- SRL evidence: synth.log "Static Shift Register Report" lists two 8-bit-wide chains (RTL names u_wg/LB1/sr_reg[0][7] and u_wg/tap_reg_reg[2][7]), each mapped to 8 SRLC32E = 16 total, "Pull out last Reg = YES"; utilization.rpt "LUT as Shift Register 16, LUT as Distributed RAM 0"; primitives SRLC32E 16; power.rpt "LUT as Shift Register 16". The two 32 x 8 line buffers hold 512 bits of delay in 16 LUTs rather than 512 flip-flops - the outcome that keeps BRAM at 0 at almost no LUT cost.
- DSP = 0, forced twice: (* use_dsp = "no" *) on mult8x8 (rtl/multiplier.sv line 1) and synth_design -max_dsp 0 (fpga/build.tcl); utilization.rpt DSP table reads 0 of 220. Reason: one DSP counts 50 LUTs in the FoM denominator; a 52-59-LUT multiplier is cheaper.
- BRAM = 0 by construction: 0 of 140 RAMB36, 0 of 280 RAMB18; nothing in the design is a memory beyond the shift registers; one BRAM would cost 100 LUT-equivalents, more than the whole window generator (132).
- Total on-chip storage: 2 x 32 x 8 bits of line delay + 72 bits of taps + 72 bits of coefficients; no BRAM anywhere.
- I/O: 42 pins = 24 inputs (clk, rst_n, valid_in, write_en, write_addr[3:0], input_in[7:0], data_write[7:0]) + 18 outputs (pixel_out[15:0], valid_out, busy) = 24 IBUF + 18 OBUF, 21 master + 21 slave pads; outputs at the default 12 mA, slow slew (io.rpt); board map in pynq_z2.xdc: clock H16, reset on SW0 (M20), pixels in on PmodA, coefficient data on PmodB, control on the Arduino header, pixel_out on the RPi header, valid_out / busy on LED0 / LED1.
- Clocking: the 125 MHz pin goes IBUF -> BUFG straight into the fabric; no MMCM or PLL (Clocking table: BUFGCTRL 1, MMCME2_ADV 0, PLLE2_ADV 0).
- Primitive census (utilization.rpt section 8 = synth.log "Report Cell Usage"): LUT6 399, LUT3 251, LUT4 211, LUT5 182, LUT2 101, LUT1 3, CARRY4 128, FDRE 438, FDSE 3, SRLC32E 16, IBUF 24, OBUF 18, BUFG 1.
- synth_design finished with 0 critical warnings and 0 errors (synth.log).
- DRC (drc.rpt): exactly one check found, ZPS7-1 Warning "PS7 block required" - expected: the design is PL-only and never instantiates the Zynq processing system; Vivado warns because a Zynq bitstream normally has the PS configure the PL; it has no effect on utilisation, timing or power; a PL-only bitstream still loads over JTAG.
- Reproducibility: the flow was run twice on the same tagged RTL (v1.0-submission) - 11 Sep in-memory Tcl flow (fpga/build.tcl) and 13 Sep fresh Vivado project GUI flow - with identical results: 879 LUTs / 441 FFs / 16 SRL / 0 DSP / 0 BRAM / WNS +0.742 / WHS +0.153 / 0.158 W / FoM 7.20e-3; Vivado is deterministic for the same inputs and settings.
- Bitstream: fpga/top.bit generated (13 Sep, PL-only, real PYNQ-Z2 pinout); it would load on the board, but a demonstration needs a wrapper (pixel source via PS or UART, reset synchroniser) and was not performed.
- Context (detail in section 15): baseline 882 LUTs / 437 FFs -> 879 / 441 after registering the four edge flags (+4 FFs) and the top-bits saturation rewrite (-3 LUTs net).
- Regenerate: `vivado -mode batch -source fpga/build.tcl` from the project root; reports land in fpga/reports/.
**Show:**
- Table: Routed utilization summary - Resource | Used | Available | Util % - rows: Slice LUTs 879 / 53200 / 1.65; LUT as logic 863; LUT as shift register 16 / 17400 / 0.09; Slice registers 441 / 106400 / 0.41; Slices 279 / 13300 / 2.10; DSP48 0 / 220 / 0.00; Block RAM tiles 0 / 140 / 0.00; Bonded IOB 42 / 125 / 33.60; BUFG 1 / 32 / 3.13 - fpga/reports/utilization.rpt sections 1-6.
- Table: Post-synthesis estimate vs post-route - Stage | Slice LUTs | LUT as logic | LUT as SRL | FFs - Synthesized 910 / 894 / 16 / 441; Routed 879 / 863 / 16 / 441 - fpga/reports/synth_utilization.rpt, fpga/reports/utilization.rpt.
- Table: Hierarchical breakdown - Block | Instance | LUTs | of which SRL | FFs - 9 x mult8x8 | g_mul[0..8].u_mul | 496 (5 x 52 + 4 x 59) | 0 | 0; control_fsm | u_cu | 80 | 0 | 35; coeff_reg | u_cr | 120 | 0 | 72; window_gen incl. LB0/LB1 | u_wg | 132 | 16 | 117; adder tree + saturate + ReLU + pipeline regs | (top) | 90 | 0 | 217; sum of blocks | | 918 | 16 | 441; flat routed total | top | 879 | 16 | 441 - with the cross-boundary footnote under it - fpga/reports/utilization_hier.rpt.
- Table (optional): Primitive census - Primitive | Count - fpga/reports/utilization.rpt section 8.
- Quote: the "Static Shift Register Report" table from fpga/reports/synth.log, verbatim (two rows, width 8, SRLC32E 8 each).
- Table (optional): Pin map - Port | Dir | Width | Package pin(s) | Board location - fpga/pynq_z2.xdc, fpga/reports/io.rpt.
- Quote: the ZPS7-1 block from fpga/reports/drc.rpt verbatim (rule, severity, description).
- No figure in the inventory for this section; a screenshot of Vivado's Project Summary utilization panel is optional (not in inventory).
**Avoid:**
- Do not quote 910 (post-synthesis) or 882 / 437 (baseline) as the utilization; 879 / 441 routed is the number.
- Do not present the hierarchical LUT split as exact or force it to sum to 879; give it with the caveat.
- Do not say "0 warnings" overall (synth_design had 18 ordinary warnings, DRC has the one ZPS7-1); say 0 critical warnings, 0 errors, one expected DRC warning.
- Do not write "0 FFs" as a block-level count for the line buffers: utilization_hier.rpt shows flip-flops under LB0 (SRL end-stage registers); say the 512-bit delay storage is in 16 SRLC32E rather than 512 flip-flops.
- Do not call the line buffers distributed RAM or BRAM.
- Do not claim the bitstream was loaded or a board demonstration was done.
- Do not reuse RESULTS.md's early hierarchy split (485 / 165 / 96 / 96 / 89) - that is the baseline build, not the submission.
- Do not describe the 16 SRL LUTs as outside the FoM - they are inside the 879.
**Sources:** fpga/reports/utilization.rpt, fpga/reports/utilization_hier.rpt, fpga/reports/synth_utilization.rpt, fpga/reports/synth.log, fpga/reports/drc.rpt, fpga/reports/io.rpt, fpga/pynq_z2.xdc, fpga/build.tcl, rtl/multiplier.sv, rtl/top.sv, rtl/control_unit.sv, fpga/reports/RESULTS.md, docs/notes/DESIGN_ITERATIONS.md.

## 13. Timing report
**Required by:** Spec 9 "maximum frequency, timing status"; Instruction 3 "timing, maximum frequency"; judging criterion "timing closure"; organiser item "operating frequency used in the FoM".
**Say:**
- Constraint: create_clock -period 8.000 -waveform {0 4} on port clk, package pin H16 = the PYNQ-Z2 Ethernet-PHY 125 MHz clock; one clock domain, no generated clocks, no MMCM.
- Result (timing_summary.rpt, routed, multi-corner Slow + Fast, pessimism removal on): setup WNS +0.742 ns, TNS 0.000, 0 failing of 602 endpoints; hold WHS +0.153 ns, THS 0.000, 0 failing of 602; pulse width WPWS +3.020 ns, 0 failing of 458; "All user specified timing constraints are met."
- (REQUIRED) Fmax derivation: Fmax = 1000 / (8.000 - 0.742) = 1000 / 7.258 = 137.8 MHz; this is the core register-to-register limit; the design is operated, verified and power-measured at 125 MHz; 137.8 MHz is reported here as the timing-closure result and is not the FoM frequency.
- check_timing: 0 unconstrained internal endpoints, 0 combinational loops, 0 registers without a clock; the only items flagged are "23 input ports with no input delay but user has a false path constraint (MEDIUM)" and "18 ports with no output delay but user has a false path constraint (MEDIUM)" - the exclusion is declared to the tool, not hidden.
- (REQUIRED) I/O paths are excluded from timing: fpga/pynq_z2.xdc contains set_false_path -from [all_inputs] -to [all_registers], set_false_path -from [all_registers] -to [all_outputs], and set_false_path -from [get_ports rst_n]; justification: nothing external drives or samples these 42 pins with a defined timing relationship (no interface contract, no source device on the board); in a system the core sits on-chip behind a wrapper and the pad delays do not exist.
- (REQUIRED) Evidence that the exclusion is honest: with a nominal 1 ns input/output delay budget instead, all 84 setup failures were I/O paths and every register-to-register path passed; the worst had 2 logic levels (a LUT2 and an OBUF) where the 3.3 V OBUF alone was 3.557 ns of the 8 ns period - pad delay, not logic (optional: RESULTS.md records that experiment's WNS as -5.166 ns).
- Clock insertion, for the reader who checks the path: IBUF 1.451 ns + route 2.522 ns + BUFG 0.101 ns + fabric 2.054 ns = 6.128 ns source clock delay; it appears on both launch and capture, net skew -0.034 ns; clock uncertainty 0.035 ns (system jitter 0.071 ns).
- Critical path (setup, Slow corner): u_cu/bottom_edge_reg/C -> net u_wg/bottom_edge (fanout 156, 1.517 ns) -> tap zero-mask LUT3 (u_wg/prod_r[8][3]_i_10) -> net tap_out[8][4] (0.880 ns) -> g_mul[8] LUT6 -> CARRY4 -> CARRY4 -> LUT5 -> CARRY4 -> CARRY4 -> prod_r_reg[8][13]/D; 7 logic levels (CARRY4 x 4, LUT6, LUT5, LUT3); data path 7.297 ns = logic 2.973 ns (40.7%) + routing 4.324 ns (59.3%); required 14.167 - arrival 13.425 = slack 0.742 ns.
- The path starts at an edge flag, not at a tap or a coefficient: the flag is already registered, and what remains is fanout - bottom_edge drives 156 loads and that single net is the largest term in the path; the endpoint prod_r[8] is tap i (bottom-right corner), masked by both bottom_edge and right_edge, so it carries the most mask logic ahead of the multiply.
- All 15 worst paths (paths.rpt, slack 0.742 .. 1.077 ns) start at an edge-flag register and end in prod_r: 10 from bottom_edge_reg (to prod_r[8] and prod_r[6]), 4 from top_edge_reg (to prod_r[2]), 1 from right_edge_reg (to prod_r[5][13]); none start at coeff_reg or the tap registers. (Count them from paths.rpt: 10 / 4 / 1; DESIGN_ITERATIONS.md says 9 - use the report.)
- Per-stage worst slack (fpga/paths.tcl on the routed design): stage 1, window/coefficients -> prod_r (9 multipliers) +0.742 ns (u_cu/bottom_edge_reg -> prod_r_reg[8][13]); stage 2, prod_r -> row_r (three 3-input row adders) +3.799 ns (prod_r_reg[0][2] -> row_r_reg[0][17]); stage 3, row_r -> pixel_out (3-input 20-bit add + saturate + ReLU) +2.666 ns (row_r_reg[2][3] -> pixel_out_reg[13]); stage 1 binds; stage 3 has 1.924 ns and stage 2 3.057 ns of headroom over it.
- Consequence: the saturate stage was never the constraint (nearly 2 ns spare), so the top-bits saturation rewrite bought no timing; it is kept for being 2 LUTs cheaper, exhaustively equivalent, and for the test gap it exposed (section 15).
- Hold: worst +0.153 ns on u_cu/FSM_onehot_state_reg[2] -> u_cu/out_c_reg[1], 1 LUT6, 0.257 ns data path (Fast corner). Pulse width: worst +3.020 ns on the SRLC32E clock pins (0.980 ns required against the 4.000 ns half-period).
- How the number was reached (detail in section 15): baseline critical path u_cu/out_c_reg[4] -> right_edge comparator -> tap mux -> multiplier -> prod_r[8][13], 8 levels, 7.633 ns, 62% routing, WNS +0.332 ns, Fmax 130.4 MHz; registering the four edge flags in control_fsm (computed one position ahead from nxt_r / nxt_c) took the comparator out of the multiplier path: WNS +0.742 ns, Fmax 137.8 MHz, +4 FFs, LUTs 882 -> 879, no change to latency, throughput or interface.
- Identified, not taken: replicate the edge-flag registers per tap row (max_fanout attribute, or explicit duplicates with dont_touch) so each copy drives about 24 loads instead of 156 - about 8 FFs, estimated 0.5-1 ns; not done because timing closes at the board clock, Fmax is not in the FoM, and the gain is routing-dependent rather than structural.
- Same timing in both flows: WNS +0.742 / WHS +0.153 on 11 Sep (in-memory) and 13 Sep (project flow).
- Operating point for the FoM, repeated so the two sections agree: 125 MHz.
**Show:**
- Table: Timing summary - Check | Worst slack (ns) | Total violation (ns) | Failing endpoints | Total endpoints - Setup 0.742 / 0.000 / 0 / 602; Hold 0.153 / 0.000 / 0 / 602; Pulse width 3.020 / 0.000 / 0 / 458 - fpga/reports/timing_summary.rpt "Design Timing Summary".
- Table: Per-stage slack - Stage | Logic in the stage | Worst path (start -> end) | Worst slack (ns) | Headroom over stage 1 (ns) - rows from the bullet above - fpga/reports/paths.rpt.
- Table: Worst 15 paths - Startpoint | Endpoint | Slack (ns) - paste the "worst 15 paths, whole design" block as is - fpga/reports/paths.rpt.
- Code block: the critical-path delay table (Location / Delay type / Incr / Path / Netlist resource) from fpga/reports/timing_summary.rpt "Max Delay Paths", verbatim - it shows the fo=156 net at 1.517 ns and the four CARRY4 hops.
- Quote: the three set_false_path lines from fpga/pynq_z2.xdc together with the comment block above them.
- Optional figure (not in inventory): screenshot of Vivado's Design Timing Summary panel showing WNS 0.742 / WHS 0.153 / constraints met.
**Avoid:**
- Do not fold 137.8 MHz into the FoM or report power at 137.8 MHz.
- Do not describe timing as closed "with I/O constrained" or leave the false paths unmentioned - state them and the 84-failure evidence.
- Do not call the critical path "the multiplier": it is edge-flag register -> tap mask -> multiplier -> prod_r, and routing is 59% of it.
- Do not quote the baseline path (out_c_reg[4], 8 levels, 7.633 ns, WNS +0.332) as the current one.
- Do not present the 0.5-1 ns from flag replication as measured; it is an estimate for a change that was not made.
- Do not repeat RESULTS.md's "H16 is not a clock-capable pin" unless verified against the PYNQ-Z2 schematic; the argument does not need it.
- Do not say "no timing warnings": check_timing flags the false-pathed ports as MEDIUM by design.
**Sources:** fpga/reports/timing_summary.rpt, fpga/reports/paths.rpt, fpga/paths.tcl, fpga/pynq_z2.xdc, fpga/reports/RESULTS.md ("Timing: io paths are excluded", "Critical path"), docs/notes/DESIGN_ITERATIONS.md (section 2, "The critical path moved", "Per-stage slack"), rtl/control_unit.sv (nxt_r / nxt_c and the registered flags).

## 14. Power report
**Required by:** Spec 9 "estimated power"; Instruction 3 "power estimate, and FoM"; organiser clarification 11 Sep (total post-implementation power static + dynamic; SAIF of active convolution excluding reset/idle; five items to state); FoM item 10; judging criterion "power estimate".
**Say:**
- (REQUIRED, organiser item 1) FPGA device and board: xc7z020clg400-1, PYNQ-Z2 (TUL), Zynq-7000, speed grade -1; report_power ran with grade commercial, process typical, Production characterization (power.rpt header).
- (REQUIRED, organiser item 2) Operating frequency used in the FoM: 125 MHz (8.000 ns) - the constraint the design was implemented and verified against, the board's clock, and the clock report_power applies the switching activity to.
- Why 125 MHz and not 137.8: the organiser left the frequency to the team; throughput in the FoM is per cycle and does not change with clock, dynamic power scales roughly linearly with it, so a higher clock only lowers the FoM; going below the board clock would read as gaming the metric; 125 MHz makes power, timing and the SAIF self-consistent.
- (REQUIRED, organiser item 3) Static 0.107 W, dynamic 0.052 W, total 0.158 W (Vivado report_power on the routed design, SAIF-annotated).
- Dynamic breakdown (power.rpt 1.1): I/O 0.042 W (42 pads), clocks 0.004 W, slice logic 0.003 W (LUT as logic 0.003, CARRY4 <0.001, registers <0.001, SRL 0.000), signals 0.003 W; sum 0.052 W.
- Shares of the 0.158 W total: static 68%, I/O pads 27%, the design's own logic + signals + clocks about 6%.
- (REQUIRED, organiser item 4) SAIF simulation interval: tb_top with the sobel_x kernel in Vivado xsim, logging windowed from 145 ns to 10800 ns = 10.655 us (fpga/saif_xsim.tcl, run by fpga/saif.bat, output fpga/tb_top.saif, DURATION 10,655,000 ps); 145 ns is the first accepted pixel (valid_in asserts), last pixel in at 10385 ns, last valid_out (the 1024th output) at 10755 ns; excluded, because they precede the window: reset (released after 4 cycles) and the 9 coefficient writes (~50 ns); inside the window: fill, 1024 gapless outputs, drain, pipeline flush - no idle, no reset; scope logged recursively under /tb_top/dut (datapath, window_gen, control_fsm, coeff_reg).
- Cycle count of the interval - word it carefully: the testbench clock is 10 ns (`always #5` in tb/tb_top.sv), so the frame occupies 1061 TB cycles (34 fill + 1024 outputs + 3 pipeline) inside a 1065.5-cycle window; report_power ignores the SAIF's own clock and applies the toggle counts to the 8.000 ns constraint clock (the read_saif warning "Simulation is not consistent with clock constraints on net clk" says exactly that), i.e. 10.655 us = 1332 periods at 125 MHz - which is what makes 0.158 W a 125 MHz number.
- (REQUIRED, organiser item 5) Tools: Vivado 2025.2 for synthesis, implementation and report_power; Vivado xsim (2025.2) for the SAIF; ModelSim ASE 2020.1 for the functional regression; annotation commands: read_saif fpga/tb_top.saif -strip_path tb_top/dut, then report_power.
- Confidence: Medium (power.rpt 1.3): design implementation state High (routed), clock nodes activity High, I/O nodes activity High ("more than 95% of inputs"), device models High (Production), internal nodes activity Medium ("User specified less than 25% of internal nodes").
- Honest reason for Medium: "Design Nets Matched 19% (414/2229)". The SAIF carries RTL names (prod_r, tap_out, row_sum); the routed netlist is mostly synthesis-invented LUT-to-LUT nets (e.g. prod_r_reg[8][11]_i_1_n_0) that never existed in RTL, so no RTL simulation can annotate them - a naming ceiling, not a coverage gap; logging recursively doubled the SAIF (1087 -> 2380 nets) and changed the matched count by exactly zero; the 414 matched nets are the I/O, taps, products, accumulator and pipeline registers - the high-activity nets that set the power - and Vivado propagates activity probabilistically through the combinational nets between them; High would need a post-implementation timing simulation with a netlist-level testbench, which the organiser did not ask for.
- Vectorless vs SAIF (REQUIRED comparison for the "estimated power" discussion): vectorless (Vivado default 12.5% toggle, Low confidence) gave dynamic 0.074 W, static 0.107 W, total 0.181 W, I/O 0.059 W; SAIF gives 0.052 / 0.107 / 0.158, I/O 0.042; dynamic -30%, total -13%; FoM 6.285e-3 -> 7.20e-3, +14.6% with no RTL change - measuring properly was the largest single FoM gain in the project.
- I/O observation: 0.042 W of the 0.052 W dynamic is pad switching (81% of dynamic, 27% of total) - an artifact of exposing all 42 core ports at the device boundary as LVCMOS33 at the default 12 mA drive (io.rpt); in a larger design these nets stay on-chip and the core's dynamic power would be a small fraction of this figure; lowering output DRIVE to 4 mA was estimated at roughly 10% of total power and was not done (section 15).
- Static observation: 0.107 W is a property of the die and the operating conditions, not of the RTL - the 879-LUT design cannot move it; power.rpt 1.2 shows it includes the PS and XADC supplies (Vccpint, Vccpaux, Vccpll, Vccadc) that a PL-only design still powers.
- Analysis conditions (power.rpt 2.1, Vivado defaults - state as assumptions): ambient 25 C, ThetaJA 11.5 C/W, airflow 250 LFM, no heat sink, junction 26.8 C, medium 10" x 10" board with 8-11 layers.
- Two read_saif warnings, both benign and reproducible: (1) "Simulation is not consistent with clock constraints on net clk" - TB clock 10 ns vs constraint 8 ns, the constraint wins, which is intended; (2) "high-fanout reset nets asserted for excessive periods" - false positive: rst_n is high (deasserted) for the whole window with zero toggles, reset was released before capture began.
- (REQUIRED) FoM computation line: FoM = Throughput / (Power x (LUTs + 50 x DSPs + 100 x BRAMs)) = 1.0 / (0.158 x (879 + 50 x 0 + 100 x 0)) = 1.0 / 138.9 = 7.20e-3, at 125 MHz, throughput 1.0 output pixel per cycle, power = total static + dynamic as the organiser specified.
- (REQUIRED assumption) Power unit: the PDF gives no unit for the power term; watts is assumed and stated; the same 0.158 W is used in Table 1.
- Both flows (11 Sep in-memory, 13 Sep project) reproduced 0.158 W = 0.052 + 0.107 identically.
**Show:**
- Table: The five organiser items - Item | Value - FPGA device and board: xc7z020clg400-1, PYNQ-Z2 (TUL), Zynq-7000, -1; Operating frequency used in the FoM: 125 MHz; Static power: 0.107 W; Dynamic power: 0.052 W; Total power: 0.158 W; SAIF interval: tb_top 145 ns to 10800 ns (10.655 us), active convolution only; Implementation tool: Vivado 2025.2; Power-analysis tool: Vivado 2025.2 report_power; SAIF simulator: Vivado xsim; Regression simulator: ModelSim ASE 2020.1 - docs/notes/POWER_METHODOLOGY.md.
- Table: On-chip power components - Component | Power (W) | Used - Clocks 0.004 / 3; Slice logic 0.003 / 1757; Signals 0.003 / 1403; I/O 0.042 / 42; Static 0.107; Total 0.158 - fpga/reports/power.rpt 1.1.
- Table: Confidence breakdown - User input | Confidence | Detail - the six rows of fpga/reports/power.rpt 1.3, ending "Overall confidence level: Medium".
- Table: Vectorless vs SAIF - Quantity | Vectorless | SAIF - Dynamic 0.074 / 0.052; Static 0.107 / 0.107; Total 0.181 / 0.158; I/O 0.059 / 0.042; Confidence Low / Medium; Nets matched - / 19% (414/2229); FoM 6.285e-3 / 7.20e-3 - docs/notes/POWER_METHODOLOGY.md.
- Table: SAIF window timeline - Time (ns) | Event - 0 reset asserted (4 cycles); ~50 nine coefficient writes; 145 first pixel in, SAIF starts; 10385 last pixel in; 10755 last valid_out; 10800 SAIF stops - docs/notes/POWER_METHODOLOGY.md, fpga/saif_xsim.tcl.
- Figure: docs/figures/waveforms/latency.PNG - first valid_in at 145 ns with the coefficient writes before it: the SAIF window opens exactly at the first accepted pixel, reset and kernel load outside it.
- Figure: docs/figures/waveforms/fsm.PNG - whole frame IDLE FILL STREAM DRAIN DONE: the logged interval is the FILL/STREAM/DRAIN span, no idle inside it.
- Quote: the power.rpt Summary block verbatim (Total 0.158, Dynamic 0.052, Device Static 0.107, Confidence Level Medium, Simulation Activity File fpga/tb_top.saif, Design Nets Matched 19% (414/2229)).
**Avoid:**
- Do not write High confidence; it is Medium, and say why.
- Do not use 0.181 W or 0.074 W as the result anywhere except in the vectorless comparison.
- Do not write "1332 cycles at the 10 ns TB clock" - at 10 ns the window is 1065.5 cycles; 1332 is the 8 ns count report_power uses.
- Do not present the 19% as a simulation-coverage figure or claim the SAIF annotated the whole design.
- Do not report or scale power at 137.8 MHz.
- Do not claim the I/O power would "disappear" in a system; say it would be a small fraction.
- Do not present the DRIVE 4 mA ~10% as measured.
- Do not state the power without the frequency and the unit assumption beside it.
- Do not say the SAIF includes reset or the kernel load; it starts after both.
**Sources:** fpga/reports/power.rpt, docs/notes/POWER_METHODOLOGY.md, fpga/saif_xsim.tcl, fpga/saif.bat, fpga/build.tcl (read_saif / report_power lines), fpga/reports/io.rpt (drive, slew), docs/notes/DESIGN_ITERATIONS.md section 4, tb/tb_top.sv (10 ns clock), fpga/reports/RESULTS.md ("Final run, 13 Sep").

## 16. Table 1
**Required by:** Deliverable "Table 1" - rows Input image size, Input precision, Kernel precision, Architecture type, Multipliers / MACs, Pipeline stages, Latency, Throughput, FPGA utilization, Maximum frequency, Power estimate, Verification status, FOM; columns Parameter | Specification | Team Result | Units | Comments.
**Say:**
- Place the table last, after the tradeoffs discussion, as the deliverable order requires; every number is the routed, SAIF-annotated, 125 MHz result already used in sections 12-14.
- Specification column: quote the PDF's mandatory value where it gives one; write "not specified" where it does not (architecture type, multipliers, pipeline stages, latency, throughput) - stating that is itself an assumption the announcement asks for; note the 1 output pixel/cycle bonus in the throughput row.
- Team Result column: numbers only; units in their own column; the Comments column carries the qualifier (routed, SAIF, 125 MHz, core Fmax) so no cell can be read two ways.
- Latency: 37 cycles first, then the time at 125 MHz (37 x 8.000 ns = 296 ns).
- Throughput: both 1.0 peak and 0.965 sustained per frame in the cell; 125 Mpixel/s at 125 MHz in Comments.
- FPGA utilization cell lists all four FoM resources with the SRL split so the 16 shift-register LUTs are visibly inside 879.
- Maximum frequency: 137.8 with "125 MHz constraint met, WNS +0.742 ns" and "core register-to-register, I/O false-pathed; FoM at 125 MHz" in Comments.
- Power: 0.158 with the split, "SAIF-annotated, Medium confidence, 125 MHz, total = static + dynamic as the organiser specified".
- Verification: PASS with the counts (22/22 regression runs; 14/14 hardware output files byte-identical to golden; RELU=0 and RELU=1 builds; 1024 windows checked against golden vectors).
- FOM: 7.20e-3 with the full computation and the watts assumption in Comments.
- One-line note under the table: PYNQ-Z2 / xc7z020clg400-1, Vivado 2025.2, routed; board demonstration not performed; bonuses claimed: one-output-pixel-per-cycle pipelined architecture, multiple (programmable) kernels, ReLU, edge-detection demo in simulation.
**Show:**
- Table: Table 1 - Parameter | Specification | Team Result | Units | Comments - ready to paste:

| Parameter | Specification | Team Result | Units | Comments |
|---|---|---|---|---|
| Input image size | minimum 32x32, grayscale / single channel | 32 x 32, grayscale, 1 channel | pixels | fixed at 32x32; zero-padded "same" convolution, 1024 outputs per frame; raster order, one pixel per cycle, stalls allowed |
| Input precision | fixed point unsigned; justification required | 8-bit unsigned, Q8.0 | bits | matches 8-bit grayscale sensors / feature maps exactly, narrowest lossless width, no scaling logic (section 7) |
| Kernel precision | 8-bit signed fixed-point or integer | 8-bit signed integer, Q8.0 | bits | 9 programmable coefficients via write port (write_addr = 3*row + col); Q1.7 available as a COEF_FRAC rebuild |
| Architecture type | not specified | streaming, fully parallel 3x3, line-buffer window generator, 3-stage pipelined datapath, one output pixel per cycle | - | control_fsm / window_gen / coeff_reg / 9 multipliers + adder tree / saturate + ReLU; ReLU as build parameter (default off) |
| Multipliers / MACs | not specified | 9 | multipliers | 8u x 8s in LUTs (52-59 LUTs each, 496 total); 0 DSP by use_dsp="no" and -max_dsp 0 |
| Pipeline stages | not specified | 3 | register stages | prod_r, row_r, pixel_out after the window; valid bit travels with the data; stage 1 (multipliers) binds timing |
| Latency | not specified | 37 | clock cycles | 34 window fill + 3 pipeline; 296 ns at 125 MHz; first accepted pixel to first valid_out |
| Throughput | not specified; one output pixel per cycle is a bonus item | 1.0 peak; 0.965 sustained per frame | output pixels / cycle | gapless valid_out within a frame; 1024 outputs in 1061 cycles including fill and drain; 125 Mpixel/s at 125 MHz |
| FPGA utilization | report LUTs, FFs, DSPs, BRAMs | 879 LUT (863 logic + 16 SRL); 441 FF; 0 DSP; 0 BRAM | count | routed, xc7z020clg400-1; 1.65% LUTs, 0.41% FFs; 42 IOB, 1 BUFG; post-synthesis estimate was 910 |
| Maximum frequency | report maximum frequency and timing status | 137.8 | MHz | 1000 / (8.000 - 0.742); constraint 125 MHz met, WNS +0.742 ns, WHS +0.153 ns, 0 failing of 602 endpoints; core register-to-register, I/O paths false-pathed; FoM computed at 125 MHz |
| Power estimate | total post-implementation power, static + dynamic | 0.158 (0.107 static + 0.052 dynamic) | W | Vivado 2025.2 report_power, routed, SAIF-annotated (tb_top, 145-10800 ns), Medium confidence, 125 MHz; I/O 0.042 of the dynamic |
| Verification status | verified against a golden model in Python, MATLAB or C, multiple test cases | PASS: 22/22 regression runs; 14/14 hardware output files byte-identical to golden | - | numpy golden model; 7 kernels x {clean, fixed stalls, random stalls} + back-to-back frames; RELU=0 and RELU=1 builds; 1024 windows checked against golden vectors |
| FOM | Throughput / (Power x (LUTs + 50 x DSPs + 100 x BRAMs)) | 7.20e-3 | (px/cycle) / (W x LUT-equivalent) | 1.0 / (0.158 x (879 + 50x0 + 100x0)) = 1.0 / 138.9; at 125 MHz; total power; watts assumed (PDF gives no unit); vectorless would have been 6.285e-3 |

**Avoid:**
- Do not put 137.8 MHz, 0.181 W, 910 LUTs or 882 LUTs in any Team Result cell.
- Do not leave Specification blank; "not specified" is the assumption the judges asked to see.
- Do not write "board demo" anywhere in the table; simulation-verified, bitstream generated only.
- Do not round the FoM to 7.2e-3 or 0.0072; keep 7.20e-3, the form used in sections 14 and 15.
- Do not mix units inside a cell without labelling them (cycles vs ns, W vs mW).
- Do not state "High confidence" or omit the frequency next to the power.
**Sources:** sections 12-14 above; docs/notes/POWER_METHODOLOGY.md ("The five required items"); fpga/reports/RESULTS.md ("Final run, 13 Sep - numbers frozen"); docs/notes/ARCHITECTURE_LOCKED.md (precision, interface); tb/tb_top_all.sv and golden_model/golden.py (verification counts); hw_out/ and golden_model/hex/ (the 14 byte-identical files).

---

## 15. Discussion of design tradeoffs
**Required by:** deliverable "discussion of design tradeoffs"; judging on "digital design quality, FPGA resource usage, latency, throughput, timing closure, and power estimate"; FoM definition (requirement 10).
**Say:**
- Frame every choice against the one equation: FoM = Throughput / (Power x (LUTs + 50 x DSPs + 100 x BRAMs)); with DSP = BRAM = 0 the denominator is 0.158 W x 879 LUTs = 138.9, and every tradeoff below was judged on that product *after* the mandatory specs were satisfied, never instead of them.
- **9 parallel MACs vs 3 vs 1** (throughput vs area):
  - chosen: 9 multipliers, all 9 taps consumed every clock, 1.0 output pixel/cycle peak, 0.965 sustained per frame (1024 outputs in 1061 cycles) - this is what earns the one-output-pixel-per-cycle bonus.
  - cost: 496 of 879 LUTs (56%) are the nine multipliers, 52-59 LUTs each.
  - 3-MAC alternative (one row per cycle): throughput 1/3 px/cycle; removes 6 multipliers = roughly 312-354 LUTs (estimate from the 52-59 LUTs/multiplier figure, not synthesised) but window_gen (132), control_fsm (80), coeff_reg (120) and the adder/saturate glue (90) stay, so the denominator falls to only about 0.6x while the numerator falls 3x - FoM roughly halves.
  - 1-MAC: 1/9 px/cycle, needs a 9-step sequencer and accumulator on top; same arithmetic, roughly 4-5x worse FoM (estimate).
  - point to make: throughput is the only term in the numerator and the frame machinery is a fixed cost, so full parallelism wins on the metric as well as on the bonus.
- **LUT multipliers vs DSP48 (the x50 arithmetic)** (REQUIRED - FPGA resource usage):
  - one DSP counts as 50 LUT-equivalents; a measured 8u x 8s LUT multiplier is 52-59 LUTs; 9 DSPs = 450 units vs the 496 LUTs actually used - a difference of 46 units, about 5% of the 879 denominator, so nearly a wash.
  - LUTs chosen at architecture lock (docs/notes/ARCHITECTURE_LOCKED.md §1): denominator becomes a single measured term (LUTs only), RTL stays vendor-neutral (one attribute use_dsp="no" plus -max_dsp 0 at synthesis), and an 8x8 product is small enough that the LUT version still closes with +0.742 ns at 125 MHz.
  - be candid that the x50 weight is evidently calibrated to make a small multiplier cost about the same either way; this was not a large FoM win, it was a simplicity/portability decision.
- **Line buffers: SRL vs FF vs BRAM (the x100 arithmetic)**:
  - the delay is 2 x 32 x 8 = 512 bits; one BRAM would be 100 denominator units (200 if one per line) against the 16 LUTs Vivado actually used (16 SRLC32E, 0 BRAM): a BRAM would have added 84-184 units to 879, i.e. 10-21% worse FoM, to hold 512 bits in an 18/36 kbit block.
  - Vivado inferred the SRLs despite the synchronous reset because only sr[DEPTH-1] is ever read; 16 LUTs instead of 512 FFs; "LUT as Shift Register = 16" in fpga/reports/utilization.rpt is the expected, good outcome.
- **Same (zero-padded) vs valid convolution**:
  - same: 1024 outputs per 1024 inputs, valid_out gapless for the whole frame, 32x32 in -> 32x32 out as a CNN layer expects; valid: 30x30 = 900 outputs and valid_out drops for 2 cycles at every row boundary, which forfeits the *sustained* (not peak) 1 px/cycle claim.
  - price paid: 4 edge flags and 24 tap zero-muxes (top->0,1,2; bottom->6,7,8; left->0,3,6; right->2,5,8) sit in front of the multipliers - all 15 worst timing paths start at an edge-flag register, so the border logic cost timing headroom, not LUTs or throughput.
- **Registered edge flags (iteration b)** - before/after path:
  - before: u_cu/out_c_reg[4] -> right_edge -> tap zero mux -> multiplier -> prod_r[8][13], 8 logic levels (4 CARRY4, 2 LUT6, LUT5, LUT4), 7.633 ns, 62% routing; WNS +0.332 ns, Fmax 130.4 MHz.
  - after: u_cu/bottom_edge_reg -> tap zero mux -> multiplier -> prod_r[8][13], 7 levels (4 CARRY4, LUT6, LUT5, LUT3), 7.297 ns, 59% routing; WNS +0.742 ns, Fmax 137.8 MHz (+5.6%).
  - cost: +4 FFs (437 -> 441), LUTs 882 -> 879 (the logic moved, it did not grow); latency, throughput and interface unchanged; flags are computed one position ahead (nxt_r / nxt_c) so they are valid on the cycle they are used.
  - what is left is fanout, not logic: bottom_edge drives 156 loads and 1.517 ns of the 7.297 ns path is that single net into window_gen.
- **Saturation rewrite (iteration c)** - why it is kept although it bought no timing:
  - two 20-bit signed compares (acc > 32767, acc < -32768) replaced by one 5-bit all-equal test on acc[19:15], clamp by the sign bit when it fails; about 2 LUTs cheaper; proven equivalent over all 2^20 accumulator values in Python (0 mismatches).
  - bought no timing: stage 3 worst slack +2.666 ns vs stage 1 +0.742 ns, 1.92 ns headroom - the saturate stage was never the constraint (report_timing_summary only prints the single worst path, so this was not knowable before fpga/paths.tcl was written).
  - kept because it is cheaper, proven, and writing it exposed that no real kernel ever reaches the clamp (widest is sobel_y, -898..+934), so both clamp branches had been untested -> satmax (all +127) and satmin (all -128) added, regression 16 -> 22 runs; the verification gap is the real outcome.
- **The in_cnt removal that failed (iteration a)** - present as engineering rigour:
  - idea: in_cnt (10-bit) only feeds last_consume = consume && in_cnt == 1023, and out_r/out_c already count the frame, so STREAM -> DRAIN could reuse bottom_edge && right_edge and drop the counter plus its 10-bit comparator.
  - why it is wrong: consume is asserted during FILL as well as STREAM, so inputs lead outputs by exactly 34 positions; at the last consumed pixel the output position is (30, 29) - not a corner, not expressible by the edge flags.
  - caught by modelling the modified FSM in Python before touching RTL: 1059 consumed / 1058 output instead of 1024 / 1024; reverted; never reached RTL or the regression.
  - the workable variant out_r == 30 && out_c == 29 was also rejected: two 5-bit compares for one 10-bit compare, and it silently breaks if FILL_CYCLES ever changes.
  - what the exercise established: the baseline 165 LUTs in control_fsm were not a redundant counter but the four edge comparators (each driving 24 tap muxes), the en/consume/out_adv fanout and a replicated one-hot state register - which is exactly the work that iteration (b) moved (control_fsm 165 -> 80, indicative).
- **SAIF-annotated vs vectorless power (iteration d)**:
  - vectorless (Vivado default 12.5% toggle, Low confidence): 0.181 W total, 0.074 W dynamic; SAIF-annotated: 0.158 W total, 0.052 W dynamic, static 0.107 W in both, Medium confidence.
  - FoM 6.285e-3 -> 7.20e-3, +14.6%, with zero RTL change - the largest single FoM gain in the project came from measuring properly, not from design.
  - 414 of 2229 design nets annotated (19%) is a naming ceiling: the unmatched nets are synthesis-invented LUT-to-LUT nets no RTL simulation can name; the matched ones are the I/O, taps, products, accumulator and pipeline registers - the high-activity nets; High confidence would need post-implementation timing simulation with a netlist-level testbench, which was not asked for.
- **Constant-coefficient multipliers rejected**:
  - every shipping kernel uses only 0, +-1, +-2, +-4, 5; hard-coding them collapses the multipliers to shifts and adds and would cut roughly 300 LUTs.
  - rejected because requirement 3 makes coefficient programmability mandatory, and trading a mandatory spec for a tiebreaker metric is the wrong trade; the datapath widths (16b products, 18b row sums, 20b accumulator, saturation) are sized for any 8-bit signed coefficients for the same reason.
- **Where the power actually goes and what it means for further work** (REQUIRED - power estimate):
  - 0.158 W = static 0.107 (68%) + I/O 0.042 (27%) + clocks 0.004 + slice logic 0.003 + signals 0.003 (the design's own logic, about 6%).
  - every RTL iteration above moved only that 6%; static power is a property of the xc7z020 die, and the I/O share is an artefact of exposing all 42 core ports on LVCMOS33 pads (inside a real system these signals stay on-chip and the dynamic figure would be a fraction of this).
  - so the remaining levers are the device (ruled out: PYNQ-Z2 is the required board) and the I/O standard / drive strength of the 42 pads - not the RTL.
- **FoM frequency: 125 MHz, not Fmax** (REQUIRED - organiser asked for the frequency used):
  - throughput in the formula is per cycle and therefore clock-independent; dynamic power scales roughly linearly with clock; so a higher clock only lowers the FoM.
  - 125 MHz is the constraint the design was implemented and verified against, the board's clock on H16, and the clock the SAIF represents - power and frequency are self-consistent; going below the board clock would read as gaming the metric; the organiser left the choice to the team.
  - Fmax 137.8 MHz is reported under timing closure only and is deliberately not folded into the FoM.
- **Identified and quantified, not done**:
  - replicate the edge-flag registers per tap row (max_fanout or explicit dont_touch duplicates): about 8 FFs, free in the FoM, est. 0.5-1 ns off the fanout-156 net; not done because timing closes, Fmax is not in the FoM, and the gain is routing-dependent rather than structural.
  - DRIVE 4 on the outputs (pixel_out, valid_out, busy): est. ~10% of total power; not done - by decision no experiments were run on the frozen submission build once the numbers were reproduced on 13 Sep.
  - any other device: static 0.107 W (68% of the power term) would fall on a smaller die; not done - PYNQ-Z2 is a hard requirement.
  - coeff_reg at 120 LUTs is mostly the 4-bit write-address decoder fanning out to 9 byte-wide enables; a shift-in chain would shrink it, but the addressed write port is the documented interface (fpga/reports/RESULTS.md).
- Reproducibility as a quality claim: 879 / 441 / 0 / 0, WNS +0.742 / WHS +0.153, 0.158 W, FoM 7.20e-3 obtained identically by two different flows two days apart (11 Sep in-memory Tcl flow, 13 Sep project flow); post-synthesis 910 LUTs is an estimate before opt_design / LUT packing and is not the number.
**Show:**
- Table: Design iterations - columns: iteration | change | LUTs | FFs | WNS at 8 ns (ns) | Fmax (MHz) | power (W) | FoM | outcome - rows: baseline (882, 437, +0.332, 130.4, 0.181 vectorless); (a) in_cnt removal - reverted before RTL, 1059/1058 counter-example; (b) registered edge flags + (c) top-bits saturation (879, 441, +0.742, 137.8, 0.181 vectorless, 6.285e-3); (d) SAIF power (879, 441, +0.742, 137.8, 0.158, 7.20e-3, +14.6%) - source docs/notes/DESIGN_ITERATIONS.md "Status" table.
- Table: Power breakdown - columns: component | W | % of total - rows: static 0.107 / 68; I/O 0.042 / 27; clocks 0.004; slice logic 0.003; signals 0.003; total 0.158 - source fpga/reports/power.rpt.
- Table: Per-stage slack - columns: stage | endpoints | worst slack (ns) | headroom over stage 1 (ns) - rows: 1 window/coeffs -> prod_r +0.742 / -; 3 row_r -> pixel_out +2.666 / 1.92; 2 prod_r -> row_r +3.799 / 3.06 - source fpga/reports/paths.rpt.
- Table: Alternatives arithmetic - columns: alternative | throughput (px/cycle) | denominator effect on 879 | FoM effect | why not - rows: 3-MAC, 1-MAC, 9 x DSP48, BRAM line buffers, constant coefficients - mark every entry except the DSP and BRAM arithmetic as an estimate.
- Figure: docs/figures/waveforms/throughput.PNG - cross-reference only (already in the waveform section): the gapless valid_out that the 9-MAC decision buys.
**Avoid:**
- Do not present the constant-coefficient option as a missed opportunity - it violates requirement 3; the report should read as "analysed and rejected on principle".
- Do not say DSPs would have "added 450" to the denominator; they would replace the 496 multiplier LUTs, and the honest difference is about 46 units.
- The "roughly 300 LUTs" and "3-4x FoM" figures (docs/notes/DESIGN_ITERATIONS.md §0) do not reconcile by simple arithmetic (879 - 300 = 579 gives about 1.5x on the LUT term alone); either quote only the 300-LUT figure, or make explicit that the 3-4x ceiling assumes coeff_reg and its write decoder (120 LUTs) also disappear - do not put both numbers side by side unexplained.
- Do not claim the saturation rewrite improved timing (stage 3 was never binding) or that fanout replication / DRIVE 4 "would" give the quoted gains as results - they are estimates.
- Do not compute the FoM at 137.8 MHz or fold Fmax into it; do not call the power confidence High.
- Per-block LUT numbers (496 / 80 / 120 / 132 / 90) are indicative - Vivado combines LUTs across hierarchy boundaries; only the 879 total is exact. Say so wherever a per-block number appears.
- Do not describe the in_cnt attempt as a bug that shipped - it was caught in a Python model of the FSM before any RTL changed.
**Sources:** docs/notes/DESIGN_ITERATIONS.md, docs/notes/POWER_METHODOLOGY.md, fpga/reports/RESULTS.md, docs/notes/ARCHITECTURE_LOCKED.md (§1, §2, §4, §10), fpga/reports/paths.rpt, fpga/reports/power.rpt, fpga/reports/utilization_hier.rpt, fpga/reports/timing_summary.rpt, rtl/cnn_pkg.sv, rtl/control_unit.sv, rtl/multiplier.sv, fpga/pynq_z2.xdc, docs/notes/FINAL_TWO_DAYS.md (why DRIVE 4 was skipped).

## 17. Assumptions
**Required by:** Instruction 4: "Assume any missing information, but state all assumptions clearly in the report."
**Say:**
- (REQUIRED) Image size fixed at 32x32 (the spec minimum): IMG_W = IMG_H = 32 in rtl/cnn_pkg.sv, line-buffer depth = IMG_W = 32, in_cnt counts to 1023; a larger image is a parameter rebuild, not a run-time option.
- (REQUIRED) Input is grayscale, single channel, 8-bit unsigned Q8.0 - the spec fixes "fixed point unsigned" but not the width; the justification lives in the bit-width section and is repeated here in one line (matches 8-bit sensors exactly, no scaling logic, narrowest lossless width).
- (REQUIRED) Kernel coefficients are 8-bit signed integers Q8.0 (spec allows "fixed-point or integer"); COEF_FRAC = 0 is the shipping build; the COEF_FRAC = 7 (Q1.7) rebuild exists as a package toggle but is not part of the 22 regression runs or the FPGA numbers.
- (REQUIRED) Border handling is zero-padded "same" convolution: 1024 outputs per 1024 inputs, rather than "valid" (900 outputs); the announcement does not specify; chosen for a gapless valid_out and a 32x32 output map.
- (REQUIRED) Coefficient write-port order: write_addr = 3*row + col, 0..8, row-major, identical to the tap order a..i; golden_model/hex/<k>_coef.hex is written in that order and is the definition.
- (REQUIRED) Coefficient writes are accepted only while busy is low (between frames); writes during a frame are ignored - the kernel is constant for the duration of a frame.
- (REQUIRED) Input protocol: raster order, one pixel per accepted cycle, valid_in may deassert for any number of cycles (a stall becomes a bubble in valid_out three cycles later, never corruption); there is no ready / back-pressure signal.
- (REQUIRED) Frame gating is source-side: the source streams exactly 1024 pixels per frame and holds the next frame until busy falls; pixels presented during DRAIN are shifted through but not counted and are masked by the bottom/right edge flags.
- (REQUIRED) busy is a frame-gating and write-lock signal, not an end-of-data marker: it falls 3 cycles before the final valid_out; consumers must key off valid_out.
- (REQUIRED) rst_n is active-low and synchronous, assumed already synchronous to clk; a board wrapper would add a 2-flop synchroniser (comment in fpga/pynq_z2.xdc).
- (REQUIRED) I/O timing is excluded: no external interface timing contract exists, so set_false_path is applied to all inputs, all outputs and rst_n; the reported Fmax 137.8 MHz is the core register-to-register limit (with a nominal 1 ns I/O budget all 84 failures were pad delay - the 3.3 V OBUF alone is 3.557 ns of the 8 ns period).
- (REQUIRED) FoM power unit is watts - the PDF gives none; FoM = 1.0 / (0.158 x (879 + 50x0 + 100x0)) = 7.20e-3.
- (REQUIRED) FoM operating frequency is 125 MHz (the organiser left it to the team); Fmax 137.8 MHz is reported separately under timing.
- (REQUIRED) FoM power term is total post-implementation power, static + dynamic (organiser clarification, 11 Sep): 0.107 + 0.052 = 0.158 W, SAIF-annotated, Medium confidence.
- (REQUIRED) SAIF stimulus: tb_top with the sobel_x kernel, 145 ns to 10800 ns (10.655 us), first pixel in to last pixel out, reset and coefficient load excluded, no idle; sobel_x is assumed representative of the switching activity of any kernel.
- (REQUIRED) The SAIF was captured with the 10 ns testbench clock and applied to the 8 ns constraint clock: Vivado uses create_clock for clock activity and the read_saif warning "not consistent with clock constraints on net clk" is benign; the second warning ("high-fanout reset nets asserted") is a polarity false positive - rst_n is high and static for the whole window.
- (REQUIRED) Reported FPGA numbers are the default build: RELU = 0, COEF_FRAC = 0; the RELU = 1 build is verified in simulation on all 7 kernels but was not separately implemented.
- (REQUIRED) Throughput is reported in output pixels per cycle as the FoM defines it: 1.0 peak (used in the FoM), 0.965 sustained per frame (1024 in 1061 cycles) reported alongside; latency is defined as first accepted pixel to first valid_out = 37 cycles.
- (REQUIRED) The kernels are the standard ones: identity, sobel_x, sobel_y, sharpen, laplacian, plus satmax (all +127) and satmin (all -128) added only to exercise the clamp; the hardware supports any 3x3 kernel of 8-bit signed coefficients.
- (REQUIRED) Utilisation, timing and power are post-route numbers (879 LUTs); the post-synthesis 910 is an estimate and is not used anywhere.
- (REQUIRED) DRC warning ZPS7-1 "PS7 block required" is accepted as expected for a PL-only Zynq design; no effect on utilisation, timing or power; a PL-only bitstream still loads over JTAG.
- (REQUIRED) Target is fixed: PYNQ-Z2 (TUL), xc7z020clg400-1, 125 MHz clock on H16 (the Ethernet-PHY clock), pinout per fpga/pynq_z2.xdc (42 pins); no board demonstration is claimed.
**Show:**
- Table: Assumptions - columns: # | Assumption | Gap in the announcement it fills | Where it is enforced (file / signal / parameter) - rows are the bullets above in order - sources rtl/cnn_pkg.sv, rtl/control_unit.sv, fpga/pynq_z2.xdc, docs/notes/POWER_METHODOLOGY.md.
**Avoid:**
- Do not write "1332 cycles at the 10 ns testbench clock": the interval 145-10800 ns is 10.655 us, which is 1065.5 cycles of the 10 ns TB clock (1024 pixels + 37 latency + margin) and 1332 cycles only when counted at the 8 ns / 125 MHz constraint clock; quote the nanosecond interval and say which clock any cycle count refers to.
- Do not call the valid_in/busy protocol "AXI-Stream" or "AXI-compatible" - there is no ready signal.
- Do not claim run-time configurability of image size or kernel size; both are parameters.
- Do not let the assumptions appear only inside other sections - instruction 4 says "clearly", so keep this list even where it repeats.
- Tools line: the SAIF header in fpga/tb_top.saif reads "Vivado Simulator, VERSION 2020.2" while implementation is Vivado 2025.2 - confirm which xsim actually ran and name both versions if both were used; do not state "xsim 2025.2" unverified.
**Sources:** rtl/cnn_pkg.sv, rtl/control_unit.sv, rtl/top.sv, fpga/pynq_z2.xdc, docs/notes/POWER_METHODOLOGY.md, docs/notes/ARCHITECTURE_LOCKED.md (§2, §3, §5), docs/notes/SUBMISSION_CHECKLIST.md §8, fpga/reports/RESULTS.md ("The one DRC warning"), fpga/saif_xsim.tcl, tb/tb_top.sv (clock period).

## 18. Bonus features claimed
**Required by:** "Bonus items: board demonstration, one-output-pixel-per-cycle pipelined architecture, support for multiple kernels, ReLU activation, a simple edge-detection / industrial-inspection demo"; requirement 7 "ReLU optional, bonus"; requirement 9 "A board demonstration is optional and will be treated as a bonus."
**Say:**
- Claimed: 4 of the 5 listed bonuses - one-output-pixel-per-cycle pipelined architecture, multiple kernels, ReLU, edge-detection demo (in simulation). Not claimed: board demonstration.
- **Bonus: one output pixel per cycle, pipelined** - 9 parallel MACs plus three register stages (prod_r 9x16b, row_r 3x18b, pixel_out); valid_out solid high mid-frame with pixel_out changing every cycle; 1024 outputs in 1061 cycles per frame, latency 37 = 34 fill + 3 pipeline.
  - evidence: docs/figures/waveforms/throughput.PNG; tb/tb_top_all.sv checks on every cycle of all 22 runs that valid_out equals win_valid delayed by exactly 3 (lat_err = 0) and that bubbles in valid_out equal STREAM stalls exactly (16 = 16 fixed; about 500 = 500 random) - a stall is input starvation, never a design bubble.
- **Bonus: multiple kernels** - any 3x3 kernel of 8-bit signed coefficients, loaded through write_en / write_addr[3:0] / data_write[7:0] (9 writes, row-major); 5 real kernels (identity, sobel_x, sobel_y, sharpen, laplacian) plus satmax / satmin verified bit-exact.
  - evidence: hw_out/ - 14 files, 1024 lines each, byte-identical to golden_model/hex/; docs/figures/waveforms/kernel_load.PNG (9 write_en pulses, write_addr 0..8, busy low); kernel reload between frames proven by the back-to-back run in tb_top_all (sobel_x then sharpen, kernel swapped while frame 1 drains, 2048 outputs, pass).
  - optional capability, not a verified result: COEF_FRAC = 7 rebuild for normalised (Q1.7) kernels.
- **Bonus: ReLU** - build parameter RELU on top (default 0), one 16-bit mux after saturation in stage 3, in rtl/top.sv: `assign relu_out = (RELU && sat[OUT_W-1]) ? '0 : sat;`; no latency change.
  - evidence: tb/tb_top_all.sv instantiates two DUTs on the same stimulus (RELU = 0 and RELU = 1) and diffs each against its own golden (golden.py optional ReLU); hw_out/<k>_relu_out.hex for all 7 kernels identical to golden_model/hex/<k>_relu_out.hex.
  - state that the FPGA numbers are the RELU = 0 build; the RELU = 1 build is verified in simulation only.
- **Bonus: edge-detection demo (simulation)** - input golden_model/cat.png resized to 32x32 grayscale, streamed through the RTL; the right-hand images are rendered from the hardware output files hw_out/<k>_out.hex by golden_model/hw_to_png.py, not from the golden model.
  - evidence: docs/figures/edge_demo_sobel_x.png, docs/figures/edge_demo_sobel_y.png, docs/figures/edge_demo_laplacian.png (input left, RTL output right).
- **Board demonstration - explicitly NOT claimed.** What exists: fpga/top.bit built for the real PYNQ-Z2 pinout (fpga/pynq_z2.xdc: clk H16, rst_n on SW0 / M20, PmodA pixel in, PmodB coefficient data, Arduino header control, Raspberry-Pi header pixel out, LED0 / LED1 = valid_out / busy; pin table in fpga/reports/io.rpt), DRC clean apart from ZPS7-1. What is missing: a wrapper with a pixel source (PS/DMA or UART), a 2-flop reset synchroniser, and a board on hand - the bitstream would load but nothing would drive the pins.
- Not bonuses, do not list them as such: 16-bit output is the spec minimum; 0 DSP / 0 BRAM is a FoM result.
**Show:**
- Table: Bonus claims - columns: Bonus item | Claimed | Evidence (file) | Note - rows: 1 px/cycle pipelined / yes / docs/figures/waveforms/throughput.PNG + tb_top_all lat_err = 0 / 1024 in 1061 cycles; multiple kernels / yes / hw_out (14 files) + docs/figures/waveforms/kernel_load.PNG + back-to-back run / any 8-bit signed 3x3 kernel; ReLU / yes / hw_out/*_relu_out.hex vs golden, dual-DUT TB / RELU parameter, default 0; edge-detection demo / yes, simulation / docs/figures/edge_demo_*.png / rendered from hw_out; board demo / no / fpga/top.bit only / needs wrapper + board.
- Figure: docs/figures/waveforms/throughput.PNG - valid_out high every cycle mid-frame, pixel_out changing each cycle (bonus 1).
- Figure: docs/figures/waveforms/kernel_load.PNG - 9 write_en pulses, write_addr 0..8, coefficients on data_write, busy low (bonus 2).
- Figure: docs/figures/edge_demo_sobel_x.png, docs/figures/edge_demo_sobel_y.png, docs/figures/edge_demo_laplacian.png - input vs RTL output; caption must say the output pixels come from hw_out/ (bonus 4).
**Avoid:**
- Do not claim or imply a board demonstration, "board-tested", or "board-ready" beyond "bitstream generated for the PYNQ-Z2 pinout".
- Do not call the edge demo "industrial inspection"; it is the simple edge-detection variant, in simulation.
- Do not quote utilisation or power for the RELU = 1 build - it was not implemented; if a cost is mentioned, say "one 16-bit mux, estimate".
- Do not say the design "supports 5 kernels" - it supports any 8-bit signed 3x3 kernel; 7 were verified.
**Sources:** tb/tb_top_all.sv, tb/tb_top.sv, rtl/top.sv, golden_model/golden.py, golden_model/hw_to_png.py, hw_out/, golden_model/hex/, fpga/pynq_z2.xdc, fpga/reports/io.rpt, fpga/README.md, docs/figures/waveforms/throughput.PNG, docs/figures/waveforms/kernel_load.PNG, docs/figures/edge_demo_*.png.

## 19. Conclusion
**Required by:** closes the report; restates the judging criteria ("correctness, digital design quality, FPGA resource usage, latency, throughput, timing closure, and power estimate") with the final numbers.
**Say:**
- What was built: a 3x3 programmable-kernel, zero-padded, stride-1 convolution accelerator for 32x32 8-bit grayscale images, 16-bit signed saturating output, one output pixel per cycle, 37-cycle latency, ReLU as a build option; 42-pin streaming interface, no BRAM, no DSP.
- Correctness: 22 of 22 regression runs pass - 7 kernels x {clean, fixed stalls, random stalls} plus a back-to-back two-frame run with a kernel swap, on two builds (RELU = 0 and RELU = 1); 14 hardware output files byte-identical to the Python golden model; both saturation branches exercised by satmax / satmin; window generator checked against 1024 golden windows on 5 patterns with 0 position/edge errors.
- Implementation: xc7z020clg400-1 (PYNQ-Z2), Vivado 2025.2, 125 MHz: 879 LUTs (16 as SRL), 441 FFs, 0 DSP, 0 BRAM; WNS +0.742 ns, WHS +0.153 ns, 0 failing endpoints of 602, Fmax 137.8 MHz; power 0.158 W (0.107 static + 0.052 dynamic, SAIF-annotated, Medium confidence); FoM = 1.0 / (0.158 x 879) = 7.20e-3; reproduced identically by two flows two days apart.
- All mandatory specifications met (Table 1); 4 of 5 bonuses claimed; board demonstration not claimed.
- Learned: with DSP and BRAM at zero the FoM denominator is LUTs alone, 56% of them are the mandatory programmable multipliers, and the rest is frame machinery that does not shrink with fewer MACs - which is why full parallelism at 1 px/cycle wins on the metric as well as the bonus.
- Learned: measuring properly beat every RTL optimisation - SAIF annotation moved the FoM +14.6% while the two RTL iterations moved the LUT count by -3; the RTL is only about 6% of the power term, static is 68%, the 42 pads 27%.
- Learned: the two changes whose main value was verification, not performance - the saturation rewrite exposed clamp branches that had never been tested, and the in_cnt removal was caught by a Python model of the FSM (1059 / 1058 instead of 1024 / 1024) before any RTL changed.
- If continued: replicate the edge-flag registers (est. 0.5-1 ns on the fanout-156 net), DRIVE 4 on the outputs (est. ~10% power), and a PS/UART wrapper with a reset synchroniser for a board demonstration.
**Show:**
- none new; optionally a one-line restatement of Table 1's Team Result column.
**Avoid:**
- No new numbers here - every figure must already appear in sections 12-16.
- Do not upgrade "Medium confidence" or fold 137.8 MHz into the FoM.
- Do not promise the future-work gains as results.
**Sources:** fpga/reports/RESULTS.md ("Final run, 13 Sep"), docs/notes/DESIGN_ITERATIONS.md ("Status"), docs/notes/SUBMISSION_CHECKLIST.md §7 (Table 1 values), docs/notes/POWER_METHODOLOGY.md.

## Appendix A. Submitted files
**Required by:** "Also to submit: RTL source files, testbench, golden model, input test images, expected output files, FPGA reports, a short presentation."
**Say:**
- Everything below is at git tag v1.0-submission ("Bitstream and pin report for the PYNQ-Z2 build"); paths are relative to the project root; regeneration commands are in README.md, fpga/README.md and the header of each testbench.
- RTL source files (7): rtl/cnn_pkg.sv (all parameters: IMG_W/IMG_H 32, COEF_FRAC, RELU_EN, PROD_W 16, ACC_W 20, FILL_CYCLES = DRAIN_CYCLES = 34), rtl/line_buffer.sv, rtl/window_gen.sv, rtl/control_unit.sv (module control_fsm), rtl/coeff_reg.sv, rtl/multiplier.sv (module mult8x8, use_dsp = "no"), rtl/top.sv.
- Testbenches (4): tb/tb_top_all.sv (22-run regression, dual DUT RELU 0/1, stalls, back-to-back frames), tb/tb_top.sv (one kernel via +KERNEL=, +STALL=1, writes hw_out/), tb/tb_top_window.sv (1024 windows vs golden vectors, edge flags, fill latency 34), tb/tb_window_gen_unit.sv (direct-drive unit test).
- Simulation scripts: sim/compile.do, sim/run.do (all | kernels | window | unit | <kernel> [stall]), sim/waves/setup.do, coeff.do, latency.do, throughput.do, stall.do, edges.do, drain.do, fsm.do (one per waveform figure), modelsim.ini.
- Golden model: golden_model/golden.py (numpy: same conv, integer accumulate, 16-bit clamp, optional ReLU, 7 kernels), golden_model/hw_to_png.py (renders hw_out/ to PNG - the edge-demo figures), golden_model/view_windows.py, golden_model/hramp_windows_all.txt, golden_model/hramp_windows_all_grid.txt (window-level listings).
- Input test images: golden_model/cat.png (source), golden_model/hex/image.hex (32x32 grayscale, the frame every kernel run uses), golden_model/png/image.png (render), golden_model/vectors/hramp_in.hex, vramp_in.hex, impulse_in.hex, random_in.hex, ring_in.hex (window-level patterns).
- Expected output files (golden): golden_model/hex/<k>_out.hex and <k>_relu_out.hex for k in identity, sobel_x, sobel_y, sharpen, laplacian, satmax, satmin (14 files, 1024 lines each); golden_model/hex/<k>_coef.hex (7, write-port order); golden_model/vectors/<n>_windows_same.hex (5, 1024 x 9 bytes); golden_model/png/<k>.png (7 golden renders).
- Hardware output files (RTL simulation): hw_out/<k>_out.hex and hw_out/<k>_relu_out.hex (14 files, 1024 lines each, byte-identical to golden_model/hex/).
- FPGA reports (fpga/reports/): utilization.rpt, utilization_hier.rpt, synth_utilization.rpt, timing_summary.rpt, paths.rpt (per-stage slack), power.rpt, drc.rpt, io.rpt (pin table), synth.log (SRL inference table, cell usage), RESULTS.md (numbers written up).
- FPGA constraints, scripts and bitstream: fpga/pynq_z2.xdc (clock, 42 pins, I/O false paths), fpga/build.tcl (whole flow), fpga/paths.tcl (per-stage worst paths), fpga/saif.bat + fpga/saif_xsim.tcl (SAIF capture, 145-10800 ns), fpga/tb_top.saif (the SAIF itself, DURATION 10,655,000 ps), fpga/top.bit (PL-only bitstream), fpga/README.md.
- Waveform screenshots (docs/figures/waveforms/, ModelSim, 14 Sep): latency.PNG, kernel_load.PNG, throughput.PNG, stall.PNG, edges.PNG, drain.PNG, fsm.PNG, Window_generator_producing_valid_taps.PNG, Window_generator_producing_valid_taps2.PNG, Window_generator_producing_last_valid_taps.PNG; capture notes in docs/notes/WAVEFORM_CAPTURES.md.
- Demo figures: docs/figures/edge_demo_sobel_x.png, docs/figures/edge_demo_sobel_y.png, docs/figures/edge_demo_laplacian.png.
- Design notes shipped as supporting documentation: docs/notes/ARCHITECTURE_LOCKED.md, docs/notes/DESIGN_ITERATIONS.md, docs/notes/POWER_METHODOLOGY.md, docs/report/BLOCK_DIAGRAM_NOTES.md, docs/competition_announcement.md, docs/spec.xlsx, README.md.
- Report: docs/Architecture_Report_Draft.docx (this document; rename for submission).
- Short presentation: not in the repository yet (docs/notes/SUBMISSION_CHECKLIST.md lists it as NOT STARTED) - add its final path here (suggest docs/presentation.pptx) before packaging.
- Diagrams referenced by the report (block diagram, datapath, FSM) are embedded in the docx; if exported as files, list them here too.
**Show:**
- Table: Deliverable map - columns: Announcement deliverable | Files | Count | How to regenerate - rows: RTL (rtl/, 7, n/a); testbench (tb/ + sim/, 4 + 11, `do sim/compile.do; do sim/run.do all`); golden model (golden_model/*.py, 3, `python golden.py hex/image.hex`); input images (cat.png, image.hex, 5 vectors, 7); expected outputs (golden_model/hex + vectors + png, 26 + 5 + 7); hardware outputs (hw_out/, 14, `do sim/run.do kernels`); FPGA reports (fpga/reports/, 10, fpga/build.tcl then fpga/paths.tcl); bitstream (fpga/top.bit, 1); presentation (path TBD, 1).
**Avoid:**
- fpga/reports/synth.log and fpga/tb_top.saif are gitignored (*.log, fpga/tb_top.saif) - they exist on disk but will not be in a git export; copy them into the submission package by hand and check they are there.
- Do not list fpga/xsim.dir, fpga/*.pb, fpga/hw_out or fpga/sim (tool litter) as deliverables.
- Do not list the presentation as delivered until the file exists.
- Do not describe hw_out/ as "board outputs" - they are RTL simulation outputs.
**Sources:** README.md, fpga/README.md, docs/notes/SUBMISSION_CHECKLIST.md §1, .gitignore, `git ls-files`, git tag v1.0-submission.

---

## Review findings

### Coverage vs the announcement

**Verdict:** Not complete. Every one of the 16 deliverables, all 13 Table 1 rows, spec items 2/6/8/9/10, the organiser's five power items and all five bonus positions are addressed by concrete bullets, and all ten waveform paths plus the three edge_demo PNGs resolve to files on disk. What is missing: three Instruction-4 assumptions that other sections say 'state as an assumption' but section 17 never lists (kernel size N = 3, cross-correlation orientation, power-analysis environment), no global note enforcing the deliverable order (the outline file has 16 before 15 and 5/6 before 3/4), an unverified xsim version stated as a required organiser item (the SAIF header says 2020.2), a fourth diagram (window generator) not in the drawing inventory, and two Appendix A path/command errors (modelsim.ini is at the root; `run.do kernels` regenerates 5 files, not 14). Numbers to fix before drafting: STREAM = 990 not 1024 cycles (sections 9 and 11), the 10/4/1 worst-path split (section 4 says 9/4/1), every RTL/testbench/script line count and code line-range citation in sections 3, 6, 7 and 8 (top.sv is 141 lines, so 'lines 143-153' cannot exist), throughput.PNG is a whole-frame capture not a mid-frame zoom, '2 x SRLC32E' should be 16, and the 'Q1.7 available' claim in Table 1 contradicts sections 7/8.

**Gaps to close:**

- **Instruction 4 (state all assumptions) / spec item 3 'Kernel size NxN': the report never states that N = 3 was assumed. Neither section 1's assumption list nor section 17's table has a kernel-size bullet; section 17 only says 'do not claim run-time configurability of kernel size'.** _(in: Section 17 Assumptions (and the assumption list in section 1))_ - Add bullet: '(REQUIRED) Kernel size: the announcement says NxN without fixing N; N = 3 is assumed (KSIZE = 3 in rtl/cnn_pkg.sv, NTAP = 9, LB_DEPTH = IMG_W). Any other N is a parameter rebuild plus a change to window_gen's tap rows, not a run-time option.' Add the same line to section 1's assumption list.
- **Instruction 4: kernel orientation. Section 10 says 'state as an assumption' that the kernel is applied unflipped (cross-correlation), but section 17 - the list Instruction 4 points at - has no such row.** _(in: Section 17 Assumptions table)_ - Add bullet: '(REQUIRED) Kernel orientation: coefficients are applied unflipped (cross-correlation, the CNN convention) - tap[n] x coef[n] with tap 0 = top-left and write_addr = 3*row + col; golden_model/golden.py conv() uses the same rule, so sobel_x/sobel_y sign conventions follow from it.'
- **Instruction 4: section 14 says the power-analysis environment (25 C ambient, ThetaJA 11.5 C/W, 250 LFM, no heat sink, medium board, commercial grade / typical process) must be 'stated as assumptions', but section 17 never lists them.** _(in: Section 17 Assumptions table)_ - Add bullet: '(REQUIRED) Power-analysis conditions are Vivado defaults: ambient 25 C, ThetaJA 11.5 C/W, 250 LFM airflow, no heat sink, medium 10x10 inch board, grade commercial, process typical (fpga/reports/power.rpt 2.1); no board measurement was made.'
- **Deliverable order ('the report MUST include, in this order ... discussion of design tradeoffs, and Table 1'). The outline file is arranged 1, 2, 5, 6, 3, 7, 4, 8-14, 16, 15, 17-19, A - section 16 precedes 15 and 5/6 precede 3/4 in the file. The only ordering instruction is one line inside section 16.** _(in: Top of the outline (a global assembly note))_ - Add a bullet above section 1: 'Assemble the report in numeric section order 1-16 exactly as the announcement lists the deliverables (architecture, block diagram, datapath, FSM, memory, window generation, bit-width, RTL, testbench, golden model, waveforms, synthesis, timing, power, tradeoffs, Table 1); sections 17-19 and Appendix A follow Table 1. The grouping tags in this file are for authoring only.'
- **Organiser item 5 (implementation and power-analysis tools must be stated). Section 14 asserts 'Vivado xsim (2025.2) for the SAIF' while section 17 says that version is unverified because fpga/tb_top.saif's header reads PROGRAM_NAME "Vivado Simulator" VERSION "2020.2" (confirmed on disk). The two sections contradict each other on a required statement.** _(in: Section 14 Power report, tools bullet (and the section 17 tools note))_ - Replace the tools bullet with the verified form: 'SAIF: Vivado xsim launched by fpga/saif.bat from the Vivado 2025.2 install (the script sources C:\AMDDesignTools\2025.2\Vivado\settings64.bat when XILINX_VIVADO is unset); the SAIF header stamps VERSION "2020.2", which is the SAIF writer's format stamp - confirm with `xsim -version` before submission and quote both strings.' Then delete the 'confirm which xsim' caveat in section 17 or point it at this bullet.
- **Figure not in inventory: section 6 asks for a new 'window generator' diagram (LB0 -> LB1 with tap rows, delays 1/2/3, 33/34/35, 65/66/67) and section 5 refers to the same drawing. The inventory lists only three diagrams to draw (5-box block diagram, detailed datapath, FSM state diagram).** _(in: Section 6 Show (and section 5 optional figure))_ - Either add 'window-generator diagram (docs/report/BLOCK_DIAGRAM_NOTES.md addendum)' to the diagrams-to-draw inventory, or replace the bullet with: 'Reuse the LB0/LB1 + tap-row portion of the detailed datapath diagram (section 3) annotated with the delays 1/2/3, 33/34/35, 65/66/67; no separate figure.'
- **Appendix A submission inventory lists 'sim/... modelsim.ini' under simulation scripts; the file is at the project root (./modelsim.ini), not in sim/.** _(in: Appendix A, simulation scripts bullet and deliverable-map table)_ - Change the bullet to 'modelsim.ini (project root, library mapping used by sim/compile.do)' and correct the '4 + 11' count if modelsim.ini is no longer counted under sim/.
- **Appendix A regeneration command for the 14 hw_out/ files is `do sim/run.do kernels`; sim/run.do's `kernels` target runs tb_top on the five real kernels only (5 x _out.hex, no _relu_out, no satmax/satmin). Only tb_top_all (`all`) writes all 14.** _(in: Appendix A deliverable-map table, 'hardware outputs' row)_ - Change the row to: hardware outputs | hw_out/ | 14 | `do sim/compile.do; do sim/run.do all` (tb_top_all writes all 14 files; `kernels` rewrites only the five real-kernel _out.hex files via tb_top).

**Number mismatches:**

| Section | Claimed | Correct |
|---|---|---|
| Section 11 Figure 11.7 caption text, Table 11.1 row 11.7, and section 9 'tb_top_window also prints the FSM trace' bullet | 'STREAM lasts 1024 cycles'; state structure '34 / 1024 / 34 / 1' | STREAM is 990 enabled cycles (in_cnt 34..1023; the quoted trace FILL->STREAM at cyc 35 and STREAM->DRAIN at cyc 1025 is 990); structure 34 / 990 / 34 / 1 - sections 1 and 4 explicitly forbid '1024' here |
| Section 4, 'What is left on the path' bullet | bottom_edge -> prod_r[8] and prod_r[6] 10 of 15, top_edge 4, right_edge 1 (sums to 14) | fpga/reports/paths.rpt: 10 from bottom_edge_reg (prod_r[8] x6, prod_r[6] x4), 4 from top_edge_reg, 1 from right_edge_reg = 15; section 13 already has 10/4/1 and says to use the report |
| Section 8, first bullet (file line counts) | cnn_pkg.sv 59, line_buffer.sv 33, window_gen.sv 71, multiplier.sv 7, coeff_reg.sv 33, control_unit.sv 106, top.sv 167; 476 lines total | Counted on the tagged files: cnn_pkg.sv 33, line_buffer.sv 31, window_gen.sv 64, multiplier.sv 8, coeff_reg.sv 34, control_unit.sv 106, top.sv 141; 417 total |
| Section 8, 'Testbench and model sizes' bullet and script bullets | tb_top.sv 138, tb_top_all.sv 183, tb_top_window.sv 189, tb_window_gen_unit.sv 175, golden.py 80, sim/compile.do 22, sim/run.do 28, fpga/build.tcl 84, fpga/pynq_z2.xdc 71 lines | tb_top.sv 137, tb_top_all.sv 180, tb_top_window.sv 171, tb_window_gen_unit.sv 165, golden.py 79, compile.do 21, run.do 25, build.tcl 76, pynq_z2.xdc 67 (wc -l on the current files); either recount or drop the line counts |
| Section 3 Show ('rtl/multiplier.sv verbatim (8 lines)') vs section 8 ('multiplier.sv 7' and 'all 7 lines') | 7 lines in one place, 8 in another | The file has 8 lines (wc -l prints 7 because the last line has no trailing newline); use 8 in both places |
| Sections 7 and 8 code-listing references to rtl/top.sv | rtl/top.sv lines 143-153 (section 7) / 143-155 (section 8) for the saturate block and RELU mux | top.sv is 141 lines; acc_top/fits are lines 117-121, the three-way sat assignment lines 124-126, the RELU mux line 129 - cite 117-129 |
| Section 6 Show, zero-padding mask table source | rtl/window_gen.sv lines 61-69 | The four mask ifs are lines 58-61 (always_comb starts at line 54); file is 64 lines |
| Section 8 Show, control_unit listing | rtl/control_unit.sv lines 41-52 and 98-101 | nxt_c/nxt_r always_comb is lines 40-51; the four registered flag assignments are lines 97-100 |
| Sections 1, 3, 15 and 18 figure captions for docs/figures/waveforms/throughput.PNG (and the inventory line) | 'mid-frame, valid_out solid high, pixel_out changing every cycle' | The shipped capture is the whole frame: cursors 'First Pixel out' 515 ns / 'Last pixel out' 10755 ns, delta 10240 ns; individual pixel_out transitions are not resolvable at that zoom. Section 11 describes it correctly; either caption it as '1024 outputs in 1024 consecutive cycles' everywhere or retake with throughput.do's 3000-3300 ns zoom |
| Sections 2 (annotation), 3 (diagram annotation) and 15 (line-buffer bullet) | 'LB0, LB1 ... inferred as 16 SRLC32E (two 8-bit-wide chains), 16 LUTs'; section 15: '(16 SRLC32E, 0 BRAM)' | 16 SRLC32E (two 8-bit-wide chains of length 30, 8 primitives each; synth.log and utilization.rpt 'LUT as Shift Register 16'); and utilization_hier.rpt shows 61 FFs under LB0, so '0 FFs' must not be stated (section 12 Avoid already forbids it) |
| Table 1 (section 16) Kernel precision comment, section 1 precision bullet, section 18 multiple-kernels bullet | 'Q1.7 available as a COEF_FRAC rebuild' / 'COEF_FRAC = 7 rebuilds for Q1.7' | COEF_FRAC is declared only (rtl/cnn_pkg.sv line 14; no other RTL file references it) and there is no shift/round stage, as sections 7 and 8 state; say 'COEF_FRAC = 7 (Q1.7) is a declared package toggle with no implementing logic and no results' or omit it |
| Appendix A deliverable-map table, 'expected outputs' row | golden_model/hex + vectors + png, 26 + 5 + 7 | golden_model/hex holds 22 files (image.hex + 7 coef + 14 out/relu_out); 21 if image.hex is counted under input images; vectors 5 windows files, png 7 kernel renders (+ image.png) |

### Numbers vs the measured results

**Verdict:** NOT consistent. Headline results (879/863+16/441/0/0/42/1; WNS +0.742, WHS +0.153, 602 endpoints, Fmax 137.8; 0.158 = 0.107 + 0.052, I/O 0.042, 19% 414/2229; FoM 7.20e-3, vectorless 6.285e-3 and +14.6%; latency 37, 1061 cycles, 0.965; 22 runs, 14 files, fixed-stall schedule; bit-width ranges; all hex/waveform data values; all critical-path, clock-insertion, hold, pulse-width, power-condition and utilization-percentage numbers) check out against the fact sheet and against the reports on disk. But the outline contradicts the fact sheet and/or itself on: STREAM cycle count (990 vs 1024, stated both ways inside the outline; fact sheet says 1024, RTL says 990), FILL split (1 IDLE + 33 vs 34), the worst-15 path split in section 4 (9/4/1 = 14, report says 10/4/1), the SRL primitive count phrasing ('2 x SRLC32E' vs 16), attribution of the 882->879 LUT change, the xsim version (SAIF header says 2020.2, outline says 2025.2), the capture date of the three window-generator PNGs (outline 9 Sep, inventory 14 Sep, git 11 Sep), the throughput.PNG description (inventory says mid-frame; the shipped file is the whole frame with 515/10755 cursors), nearly every file line count in section 8 (RTL total is 417 lines, not 476), every RTL line-number citation (top.sv saturate block is lines 116-129 not 143-153; control_unit.sv 40-51/97-100 not 41-52/98-101; window_gen.sv 54-62 not 61-69), and Appendix A file counts (golden_model/hex has 22 files, png 8, sim/ has no modelsim.ini, fpga/top.bit is also gitignored, build.tcl has no write_bitstream line at all). The fact sheet itself carries one arithmetic error the outline correctly avoids: 10.655 us is 1065.5 cycles at the 10 ns TB clock, 1332 only at 8 ns. Several numbers appear in the outline but not in the fact sheet (baseline path 8 levels / 7.633 ns / 62% / fanout 127, 437 FFs, control_fsm 165, 'about 2 LUTs', 1087->2380 nets, vectorless I/O 0.059 W, 16->22 runs, 285645 ns, 3.48 s, per-run random-stall counts, 'about 8 FFs', 3-MAC/1-MAC/BRAM estimates); all of these that could be checked were verified against docs/notes/DESIGN_ITERATIONS.md, docs/notes/POWER_METHODOLOGY.md, the reports or the VCD except 3.48 s and the 21 per-run random-stall counts, which have no source in the repo. All figure paths cited exist in the inventory and on disk.

**Gaps to close:**

- **Numbers not in the fact sheet, verified against docs/notes/DESIGN_ITERATIONS.md and fpga/reports/RESULTS.md: baseline critical path 8 levels (4 CARRY4, 2 LUT6, LUT5, LUT4), 7.633 ns, 62% routing, comparator fanout 127; baseline 437 FFs; control_fsm 165 LUTs baseline; 'about 2 LUTs' for the saturation rewrite; regression 16 -> 22 runs; WNS -5.166 ns with a 1 ns I/O budget; early hierarchy split 485/165/96/96/89 (RESULTS.md, total 890/882).** _(in: Sections 4, 8, 12, 13, 15)_ - All check out against the cited docs but are absent from the fact sheet; add them to the fact sheet (source: docs/notes/DESIGN_ITERATIONS.md sections 0-2, fpga/reports/RESULTS.md) so the report and the fact sheet agree, or keep them clearly attributed to those files.
- **Numbers not in the fact sheet, verified against docs/notes/POWER_METHODOLOGY.md and fpga/reports/power.rpt: vectorless I/O 0.059 W; SAIF 1087 -> 2380 nets; DURATION 10,655,000 ps; SAIF captured 11 Sep; report_power conditions (25 C, ThetaJA 11.5, 250 LFM, junction 26.8 C, 10x10 board, 8-11 layers); component 'Used' counts 3 / 1757 / 1403 / 42; confidence rows.** _(in: Section 14)_ - Correct on disk; add the vectorless I/O 0.059 W and the 1087/2380 net counts to the fact sheet since the outline uses them as arguments.
- **Numbers not in the fact sheet, verified against fpga/reports/*: device totals 53200 LUT / 106400 FF / 17400 SRL / 13300 slices / 125 IOB / 220 DSP / 140 RAMB36 / 280 RAMB18 / 32 BUFG; 279 slices (157 SLICEL + 122 SLICEM); 16 unique control sets; 284 LUTs using O5+O6; 21 master + 21 slave pads; 12 mA slow slew; primitive census 399/251/211/182/101/3/128/438/3/16/24/18/1; Build 6299465, 13 Sep 2026; clock insertion 1.451 + 2.522 + 0.101 + 2.054 = 6.128 ns, skew -0.034, uncertainty 0.035, jitter 0.071; tap_out[8][4] net 0.880 ns; logic 2.973 / route 4.324; required 14.167 / arrival 13.425; worst-15 slack range 0.742..1.077; hold path FSM_onehot_state_reg[2] -> out_c_reg[1], 0.257 ns; pulse width 0.980 vs 4.000 on SRLC32E; 23 / 18 false-pathed ports; 0 combinational loops; utilization_hier rows including LB0 36 LUTs / 8 SRL / 61 FFs and (u_wg) 51 / 24.** _(in: Sections 5, 12, 13)_ - All match the reports; no change needed. Consider adding the device totals and the clock-insertion breakdown to the fact sheet since Table 1 and section 13 quote them.
- **Numbers with no source in the repository: '3.48 s process time in ModelSim ASE'; the 21 per-run random-stall counts in Table 9.1 (558/534, 502/476, 551/523, 493/479, 498/480, 555/538, 537/512) and the derived ranges 493-558 / 476-538; the tb_top_window FSM trace cycle numbers (cyc 2 / 35 / 1025 / 1059 / 1060); tb_top +STALL=1 'latency 39' and '1024 outputs in 1040 cycles'.** _(in: Section 9 (regression result, Table 9.1, FSM trace bullet, fixed-stall bullet))_ - sim/out/ contains only tb_top_all.vcd (which does confirm 285645 ns end time) and no transcript. Fact sheet says only 'roughly 500 stall cycles per run'. Re-run `do sim/run.do all`, `window` and `sobel_x 1` and paste the transcript numbers, or replace the per-run counts with 'about 500' and drop 3.48 s.
- **Estimates presented with specific numbers that are not in the fact sheet: 3-MAC removes 312-354 LUTs, denominator ~0.6x, FoM 'roughly halves'; 1-MAC 'roughly 4-5x worse'; '46 units, about 5%' DSP delta; flag replication 'about 8 FFs', 'about 24 loads instead of 156'; '24 tap zero-muxes'; 'each driving 24 tap muxes'; 'roughly 300x wider'; '1.4% of an 18 kbit tile'; pre-implementation 'roughly 1.5x' denominator estimate.** _(in: Sections 1, 3, 4, 7, 13, 15)_ - Arithmetic checks out (6 x 52..59 = 312..354; 496 - 450 = 46 = 5.2%; 256/18432 = 1.4%; 293760/934 = 314) and the 1.5x figure is in docs/notes/ARCHITECTURE_LOCKED.md section 4. Keep them labelled as estimates as the outline already does; the '24 tap zero-muxes' / '24 loads' wording should be spelled out as 3 taps x 8 bits per flag so a reader can reproduce it.
- **Inventory conflict on window-generator captures: inventory lists all ten waveforms as '14 Sep, tagged RTL'; the three Window_generator_*.PNG files were committed 11 Sep and were not retaken (docs/notes/FINAL_TWO_DAYS.md line 146 says they are untouched).** _(in: Figure inventory; Section 11 Figures 11.8-11.10; Appendix A waveform list)_ - Correct the inventory/Appendix A: seven tb_top captures retaken 14 Sep; three window-generator captures from the 11 Sep commit (pre-tag RTL, unchanged by later commits per tb_top_window's 0 errors). Do not write '9 Sep' without a source.
- **Inventory conflict on throughput.PNG: inventory says 'mid frame'; the shipped image is the whole frame with cursors 515/10755 ns (verified by viewing the file).** _(in: Figure inventory; Sections 1, 3, 15, 18 all cite throughput.PNG as 'mid-frame, pixel_out changing every cycle')_ - Either retake with sim/waves/throughput.do's 3000-3300 ns zoom (and then the 515/10755 cursor claim in Table 11.1 goes away) or change every caption in sections 1, 3, 15, 18 to the whole-frame wording used in section 11 ('valid_out one unbroken bar for 10240 ns = 1024 cycles').
- **Section 8 Avoid cites 'sim/run.do's header comment "5 kernels"'; the header (lines 1-3) has no such text.** _(in: Section 8 Avoid)_ - Drop the item or point at the file that actually says '5 kernels' (fpga/reports/RESULTS.md / docs/notes/ARCHITECTURE_LOCKED.md).
- **Section 8 'utilization.rpt 1.1 confirms ... 438 FDRE + 3 FDSE' and 'the 3 set-type flops are top_edge, left_edge and the one-hot IDLE bit' - the 438/3 split is in the report; the identity of the three FDSE is inferred, not reported.** _(in: Section 8 (synchronous reset bullet))_ - Keep 438/3; label the identification of the three FDSE as inferred from the reset values (top_edge, left_edge reset to 1; one-hot IDLE bit) rather than reported.
- **Section 12 'window_gen 117 = 72 tap bits + the end stages Vivado kept as flip-flops' and section 8 '72 tap bits + 45 flip-flops belonging to the delay lines' - utilization_hier.rpt actually splits u_wg 117 FFs as (u_wg) 24 + LB0 61 (no LB1 row), which does not map to 72 + 45.** _(in: Sections 5, 8, 12 (window_gen FF breakdown))_ - Quote 117 as the u_wg total only; do not decompose it into 72 + 45, or say explicitly that the hierarchical rows (24 + 61, LB1 absorbed into the SRL chains) do not follow RTL boundaries.
- **Non-figure paths referenced by the outline that are not in the inventory: docs/notes/WAVEFORM_CAPTURES.md, docs/notes/FINAL_TWO_DAYS.md, docs/notes/SUBMISSION_CHECKLIST.md, docs/competition_announcement.md, docs/spec.xlsx, docs/Architecture_Report_Draft.docx, fpga/README.md, golden_model/hramp_windows_all_grid.txt, sim/modelsim.ini.** _(in: Sections 11, 15, 17, 19, Appendix A)_ - All exist on disk except sim/modelsim.ini (absent). Remove modelsim.ini from Appendix A; optionally add the others to the inventory's notes list.

**Number mismatches:**

| Section | Claimed | Correct |
|---|---|---|
| 1 (Avoid), 4 (frame bookkeeping, table, Avoid), 9 (FSM trace), 11 (Fig 11.7, Table 11.1) | Sections 1 and 4: STREAM = 990 enabled cycles (in_cnt 34..1023), frame 1061 = 34 + 990 + 34 + 3. Section 9: trace gives FILL->STREAM at cyc 35 and STREAM->DRAIN at cyc 1025 (= 990) but then calls it 'the 34 / 1024 / 34 / 1 cycle structure'. Section 11 Fig 11.7 and Table 11.1: 'STREAM lasts 1024 cycles', '34 / 1024 / 34 / 1'. | Fact sheet says 'STREAM (1024 cycles)'. The RTL (rtl/control_unit.sv: FILL->STREAM at in_cnt == 33, STREAM->DRAIN at in_cnt == 1023, consume also runs in IDLE/FILL) gives 990 STREAM cycles, and the fact sheet's own arithmetic (consume-only 34 = output-only 34, both totals 1024) only works with 990. Pick one: either correct the fact sheet to 990 (recommended, it is what the RTL and the tb_top_window trace show) and fix sections 9 and 11 to say 34 / 990 / 34 / 1, or change sections 1 and 4. The outline must not say both. |
| 4 (frame bookkeeping, state table) | 34 consume-only = 1 in IDLE + 33 in FILL; FILL row: '33 enabled cycles (34 consume-only with the IDLE pixel)' | Fact sheet: 'FILL (34 consume-only cycles)'. RTL supports the outline (en = valid_in in IDLE, consume increments in_cnt 0->1 on the IDLE->FILL edge, FILL runs in_cnt 1..33). Either align the fact sheet wording or keep the outline's split; do not present both. |
| 4 (what is left on the path) | bottom_edge -> prod_r[8] and prod_r[6] 10 of 15, top_edge -> prod_r[2][*] 4, right_edge -> prod_r[5][13] 1 (sums to 14) | fpga/reports/paths.rpt: bottom_edge_reg 10 (6 to prod_r[8], 4 to prod_r[6]), top_edge_reg 4 (prod_r[2]), right_edge_reg 1 (prod_r[5][13]) = 15. The '9' comes from docs/notes/DESIGN_ITERATIONS.md line 190; section 13 already has the correct 10/4/1. |
| 2 (annotations), 3 (diagram annotation), 15 (line buffers) | 'LB0, LB1: 32 x 8, inferred as 16 SRLC32E (two 8-bit-wide chains), 16 LUTs' (sec 2); '16 SRLC32E (two 8-bit-wide chains), 16 LUTs' (sec 3); '16 LUTs Vivado actually used (16 SRLC32E, 0 BRAM)' (sec 15) | 16 SRLC32E primitives (two 8-bit-wide chains of 8 SRLC32E each, synth.log Static Shift Register Report; utilization.rpt SRLC32E 16). Sections 5 and 12 say it correctly. '2 x' is wrong; also sec 15's '0 FFs' contradicts sec 12's Avoid (LB0 shows 61 FFs in utilization_hier.rpt). |
| 12 (context bullet) | 882 / 437 -> 879 / 441 'after registering the four edge flags (+4 FFs) and the top-bits saturation rewrite (-3 LUTs net)' | Fact sheet attributes LUTs 882 -> 879 to iteration (b) (registered edge flags) alone; sections 4, 6, 8, 15 say the same. The saturation rewrite's 'about 2 LUTs' is from docs/notes/DESIGN_ITERATIONS.md line 103, not the fact sheet, and the fact sheet gives no LUT delta for (c). Do not attribute the -3 to (c). |
| 8 (file inventory, script inventory, testbench sizes) | Seven files, 476 lines: cnn_pkg 59, line_buffer 33, window_gen 71, multiplier 7, coeff_reg 33, control_unit 106, top 167; tb_top 138, tb_top_all 183, tb_top_window 189, tb_window_gen_unit 175; sim/compile.do 22, sim/run.do 28, fpga/build.tcl 84, fpga/pynq_z2.xdc 71 | Counted on disk: cnn_pkg 33, line_buffer 31, window_gen 64, multiplier 8, coeff_reg 34, control_unit 106, top 141 = 417 lines; tb_top 137, tb_top_all 180, tb_top_window 171, tb_window_gen_unit 165; compile.do 21, run.do 25, build.tcl 76, pynq_z2.xdc 67. golden.py 80 is correct. None of these are in the fact sheet; either drop them or recount from the tagged tree. |
| 3 (code excerpt) vs 8 (multiplier bullet, listing) | Section 3: 'rtl/multiplier.sv verbatim (8 lines)'; section 8: '7 lines' / 'all 7 lines' | The file has 8 lines (endmodule on line 8, no trailing newline). Use one number. |
| 7 (saturation mechanism, code excerpt), 8 (listing) | rtl/top.sv lines 143-153 (sec 7) / 143-155 (sec 8) for the saturate block and RELU mux | acc_top/fits/sat/relu_out are at rtl/top.sv lines 116-129 (file is 141 lines long). |
| 8 (listing) | rtl/control_unit.sv lines 41-52 and 98-101 (nxt_c / nxt_r and the four registered flag assignments) | nxt_c / nxt_r always_comb is lines 40-51; the four flag assignments are lines 97-100. |
| 6 (zero-padding table source) | rtl/window_gen.sv lines 61-69 | The mask always_comb is lines 54-62 (the four ifs are lines 58-61; file is 64 lines long). |
| 5 (sources) | fpga/reports/synth.log (lines 229-270) | Static Shift Register Report is lines 232-238 and Report Cell Usage lines 253-269; 229-270 covers them but starts/ends mid-block. Minor. |
| 14 (tools), 17 (tools line) | 'Vivado xsim (2025.2) for the SAIF' | fpga/tb_top.saif header: PROGRAM_NAME 'Vivado Simulator', VERSION '2020.2', DATE Fri Sep 11 2026. Fact sheet says only 'xsim for the SAIF'. Section 17 already flags this; section 14 states 2025.2 as fact. Name the version actually in the header or verify which xsim ran. |
| 11 (Figures 11.8-11.10) | window-generator captures '9 Sep' | Inventory says all waveforms are '14 Sep'; git shows the three Window_generator_*.PNG files were committed 11 Sep 2026 and were NOT part of the 14 Sep retake (only the seven tb_top captures were). Neither '9 Sep' nor '14 Sep' is supported; say 'captured before the 14 Sep retake (committed 11 Sep), unchanged by later RTL commits'. The inventory line is wrong for these three files. |
| 11 (Fig 11.3, Table 11.1) vs inventory | Inventory: throughput.PNG 'mid frame, valid_out solid high, pixel_out changes every cycle'. Outline Table 11.1: '11.3 throughput.PNG sobel_x throughput.do 515/10755'. | The shipped docs/figures/waveforms/throughput.PNG is the whole frame (0-10805 ns) with cursors 'First Pixel out' 515 ns and 'Last pixel out' 10755 ns, delta 10240 ns; individual pixel_out transitions are not visible. The outline's Fig 11.3 text is right and the inventory description is wrong. Note also sim/waves/throughput.do contains only 'wave zoom range 3000ns 3300ns' and no cursors, so the 515/10755 cursors in Table 11.1 were hand-placed, not produced by throughput.do. |
| 15 (line buffers) vs 1 and 5 | Section 15: 'a BRAM would have added 84-184 units to 879, i.e. 10-21% worse FoM' | 84/879 = 9.6% (sections 1 and 5 say +9.6%), 184/879 = 20.9%. Write '9.6-21%' or round both the same way. |
| 15 (design iterations table) | baseline row: '882, 437, +0.332, 130.4, 0.181 vectorless' | Fact sheet's 0.181 W / 0.074 W vectorless figure belongs to the final 879-LUT build (FoM 6.285e-3 = 1/(0.181 x 879)). No vectorless power for the 882-LUT baseline is given anywhere; leave the baseline power cell blank or mark it 'not measured'. |
| 8 (register inventory cross-check) | '906 register bits declared (3 x 18, 10 x 16, 1 x 10, 82 x 8, 1 x 6, 2 x 5, 7 x 1, state 3)' | synth.log RTL Component Statistics lists 3x18 + 10x16 + 1x10 + 82x8 + 1x6 + 2x5 + 7x1 = 903 bits; the 3-bit state register is not in that table. Say '903 listed + 3-bit state = 906' or the sum will not reconcile with the log. |
| 14 (SAIF interval) and SAIF window timeline table | 'the 9 coefficient writes (~50 ns)'; timeline row '~50 nine coefficient writes' | tb_top releases reset after 4 cycles (~45 ns) and then issues 9 one-cycle writes, so the writes span ~45-135 ns, i.e. about 90 ns, ending just before the first pixel at 145 ns (visible in latency.PNG, write_en low before 145 ns). '~50 ns' is only the start time; say 'starting ~50 ns, 9 cycles = 90 ns'. |
| 4 (transitions) vs 9 (FSM trace) vs 11 (Fig 11.7) | Sec 4: FILL->STREAM on in_cnt == 33, DRAIN->DONE on drain_cnt == 33. Sec 9: 'FILL->STREAM at cyc 35 (in_cnt = 34)', 'DRAIN->DONE at cyc 1059 (drain_cnt = 34)'. Sec 11: 'FILL->STREAM at in_cnt = 34, DRAIN->DONE at drain_cnt = 34'. | RTL conditions are in_cnt == FILL_CYCLES-1 = 33 and drain_cnt == DRAIN_CYCLES-1 = 33 (control_unit.sv lines 69, 71); 34 is the counter value on the first cycle of the next state. Both are true but read as a contradiction; state once that the trace prints the post-transition value. |
| 19 (correctness) | 'window generator checked against 1024 golden windows on 5 patterns with 0 position/edge errors' | tb_top_window reads only hramp (tb/tb_top_window.sv lines 38 and 121; fact sheet: '1024 windows vs golden window vectors (hramp)'). The other four patterns (vramp, impulse, random, ring) are shipped vectors, not run by any testbench. Say 'on the hramp pattern'. |
| Appendix A (expected outputs, script list, deliverable map, gitignore note) | 'expected outputs (golden_model/hex + vectors + png, 26 + 5 + 7)'; sim scripts include 'modelsim.ini' and the map counts 'tb/ + sim/, 4 + 11'; 'fpga/reports/synth.log and fpga/tb_top.saif are gitignored' | golden_model/hex holds 22 files (14 out/relu_out + 7 coef + image.hex); golden_model/png holds 8 (7 kernels + image.png); no number in the repo gives 26. sim/ contains compile.do, run.do and 8 wave scripts = 10 files; there is no sim/modelsim.ini. .gitignore also excludes fpga/top.bit (and all *.log, *.pb, xsim.dir/), so the bitstream must be copied by hand too. |
| 8 (Avoid: write_bitstream) | 'Do not say write_bitstream is part of build.tcl (the line is commented out)' | fpga/build.tcl contains no write_bitstream line at all, commented or otherwise. Say 'build.tcl does not write a bitstream'. |
| Fact sheet (Power) vs 14 and 17 | Fact sheet: '10.655 us = 1332 cycles at the 10 ns TB clock' | 10655 ns / 10 ns = 1065.5 TB cycles; 1332 is 10655 / 8 ns (docs/notes/POWER_METHODOLOGY.md line 58 says '10.655 us at 125 MHz = 1332 cycles'). The outline (sections 14, 17) is right to avoid the fact-sheet wording; the fact sheet should be corrected so the report writer is not pulled back to the wrong number. |
| 12 (synth warnings) | 'synth_design had 18 ordinary warnings' | synth.log has 18 lines starting 'WARNING', but its own closing line reads 'Synthesis finished with 0 errors, 0 critical warnings and 0 warnings'. If the 18 is quoted, say '18 WARNING lines in synth.log (the synthesis summary itself reports 0)'. |
