ThirstySALMON/conv3x3-edge-accelerator/docs/notes/Architecture_Report_Draft.docx

Architecture, Memory Organization, and Fixed-Point Analysis

FPGA-Based 3×3 CNN Convolution Accelerator for Edge-AI Vision

# 1. Architecture Overview

The accelerator computes a single-channel 3×3 convolution over a fixed 32×32 grayscale image using same (zero-padded) convolution, producing a 32×32 output feature map of 1024 pixels. It is a fully streaming design: one 8-bit pixel enters per clock cycle and, after an initial fill latency, one 16-bit output pixel is produced per clock cycle.

## 1.1 Window Generation

The design consists of a window generator , which has two 32 deep line buffers and 9 taps , the outputs of the taps are muxxed with zeros (except the center tap) , to handle edge and corner padding , this is done through 4 flags which are controlled by counters in the control unit. The window generator outputs 9 taps which are 8 bits each which directly enters into a 9 element MAC (Multiply and Accumalate) array.

The two line buffers are chained in series. The incoming pixel enters the bottom window row and feeds the first line buffer LB0, the output of LB0 , is the newest pixel of the middle window row and feeds LB1. The output of LB1, delayed by two image rows ,is the newest pixel of the top window row. Three horizontal tap-register chains (three registers each) shift these three streams sideways to complete the nine-pixel window.

This design choice should free us from needing a BRAM block , as 73 bytes are trivial.

Storage element | Size | Implementation
Line buffer LB0 | 32 × 8 bits | FF / distributed LUTRAM shift register
Line buffer LB1 | 32 × 8 bits | FF / distributed LUTRAM shift register
Tap registers (a–i) | 9 × 8 bits | Flip-flops
Block RAM (BRAM) | 0 | None — eliminated by design

Table 1. Memory organization.

## 1.2 Bit Width and Arithmetic Analysis

All arithmetic is fixed-point. Input pixels are 8-bit unsigned, matching 8-bit grayscale. Kernel coefficients are 8-bit signed integers. Signed coefficients are required because edge-detection kernels such as Sobel and Laplacian contain negative weights. The datapath widths below are not chosen but derived from worst-case bit growth, then confirmed against measured ranges from the Python golden model.

Product width. Each tap multiplies an 8-bit unsigned pixel by an 8-bit signed coefficient. The extreme product is 255 × (−128) = −32,640, and 255 × 127 = +32,385, both of which fit in a 16-bit signed value (range −32,768 to +32,767).

Accumulator width. Nine such products are summed. The worst-case magnitude is 9 × 255 × 128 = 293,760, which requires 20 bits signed to represent losslessly. The accumulator is therefore 20 bits, the minimum width that guarantees no overflow for any 8-bit unsigned image and any 8-bit signed kernel.

Output width and saturation. The output is 16-bit signed (the specified minimum). Because the 20-bit accumulator can exceed the 16-bit range in principle, the result is passed through a saturating stage that clamps to [−32,768, +32,767] rather than wrapping or truncating, which avoids gross artifacts from overflow. The golden model applies the identical clamp so hardware and reference remain bit-exact. A ReLU stage clips negative results to zero as a post-processing bonus.

Signal | Format | Width | Worst-case range
Input pixel | Q8.0 unsigned | 8 | 0 … 255
Coefficient | Q8.0 signed | 8 | −128 … 127
Product (per tap) | signed | 16 | −32,640 … 32,385
Accumulator | signed | 20 | −293,760 … 293,760
Output pixel | signed, saturated | 16 | −32,768 … 32,767

Table 2. Bit-width derivation from worst-case growth.

Measured ranges (golden-model evidence). The theoretical 20-bit accumulator bound assumes a pathological kernel. For the actual target kernels, the measured accumulator ranges over the test images (random, horizontal ramp, ring, and an all-maximum stress image) are far smaller, and no real kernel saturates the 16-bit output:

Kernel | Measured acc range | 16-bit output status
identity | 0 … 255 | within range
sobel_x | −1,020 … 1,020 | within range
sobel_y | −1,020 … 1,020 | within range
sharpen | −762 … 1,003 | within range
laplacian | −756 … 787 | within range
box (integer sum) | 0 … 2,295 | within range

Table 3. Measured accumulator ranges from the Python golden model across all test images. The 20-bit accumulator is sized for the theoretical worst case (293,760); real edge kernels use a small fraction of it, and none saturate the 16-bit output — the saturation stage is a correctness guarantee, not a routine operation.

This two-part result is the justification for the chosen widths: the 20-bit accumulator guarantees losslessness for any admissible input, while the measured ranges confirm that the 16-bit saturating output is more than adequate for the intended edge-detection workload, with saturation serving as a safety clamp rather than a frequent event.

3×3 Edge-AI Convolution Accelerator
