ThirstySALMON/conv3x3-edge-accelerator/docs/notes/spec.xlsx

Parameter | Decision | Future Improvement | Justification
Kernal Size | 3x3- Fixed | Variable
Input precision | 8 bit unsigned integer | N/A | Standard for grayscale
Kernal Precision | 8 bit signed integer | N/A | Per Spec
Output precision | 20 Bit signed | N/A | 20 bits worst case, Extra bit for head room
Overflow/saturation handling | Saturation | N/A | Cleaner Implementation and more predictable behaviour
Architecture
Buffering Scheme | 2 Line buffers + Window gen
Stride | 1 | N/A | Locked By spec
Border handling | No padding , valid Convolution | N/A
Kernel loading interface | write-enable + address + data | N/A | Simple load interface
Output Flow | single-pixel-per-cycle output | N/A
