ThirstySALMON/conv3x3-edge-accelerator/docs/figures/edge_demo_laplacian.png

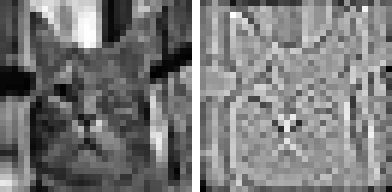
docs/figures/edge_demo_laplacian.png
