ThirstySALMON/conv3x3-edge-accelerator/docs/figures/edge_demo_sobel_y.png

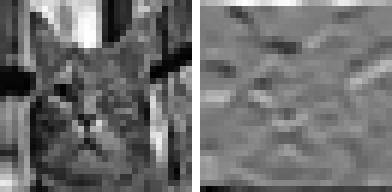
docs/figures/edge_demo_sobel_y.png
