ThirstySALMON/conv3x3-edge-accelerator/docs/figures/waveforms/drain.PNG

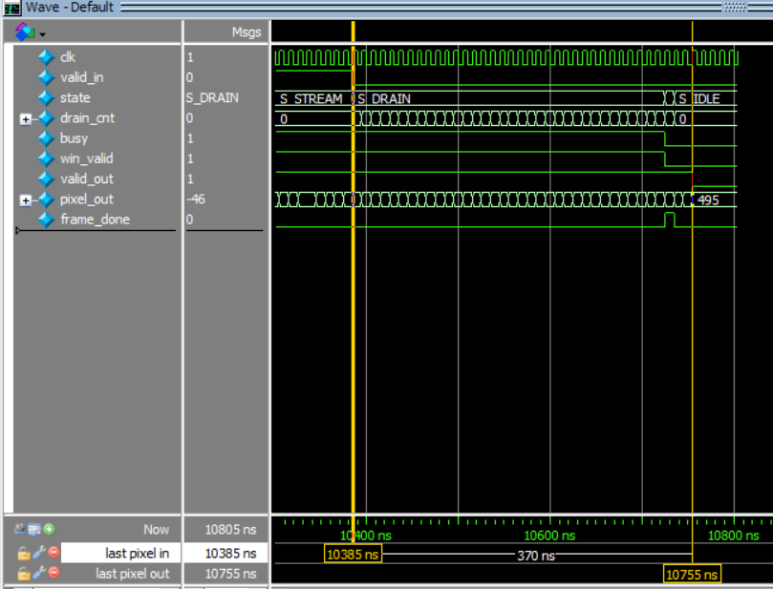
docs/figures/waveforms/drain.PNG
