ThirstySALMON/conv3x3-edge-accelerator/docs/figures/waveforms/fsm.PNG

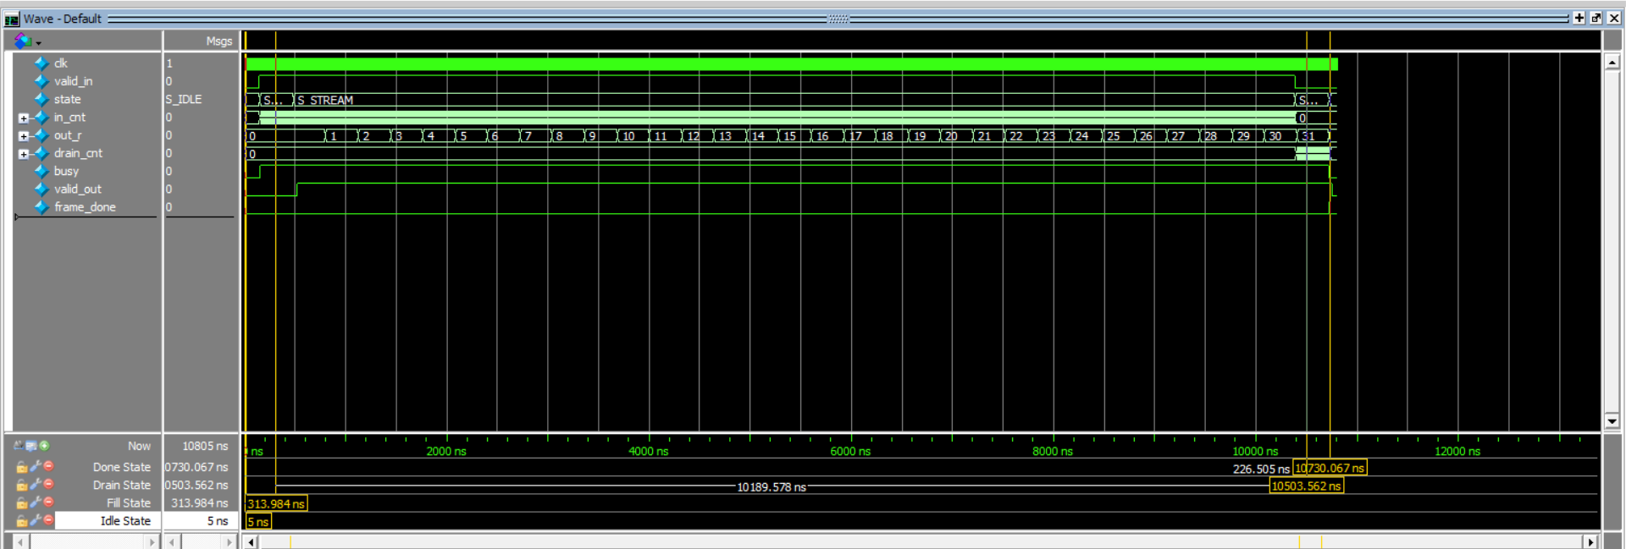
docs/figures/waveforms/fsm.PNG
