ThirstySALMON/conv3x3-edge-accelerator/docs/figures/waveforms/kernel_load.PNG

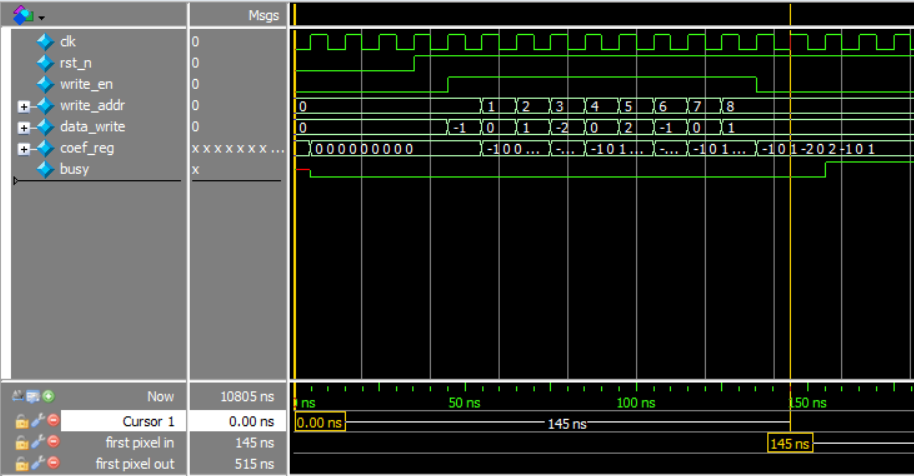
docs/figures/waveforms/kernel_load.PNG
