ThirstySALMON/conv3x3-edge-accelerator/docs/figures/waveforms/Latency.PNG

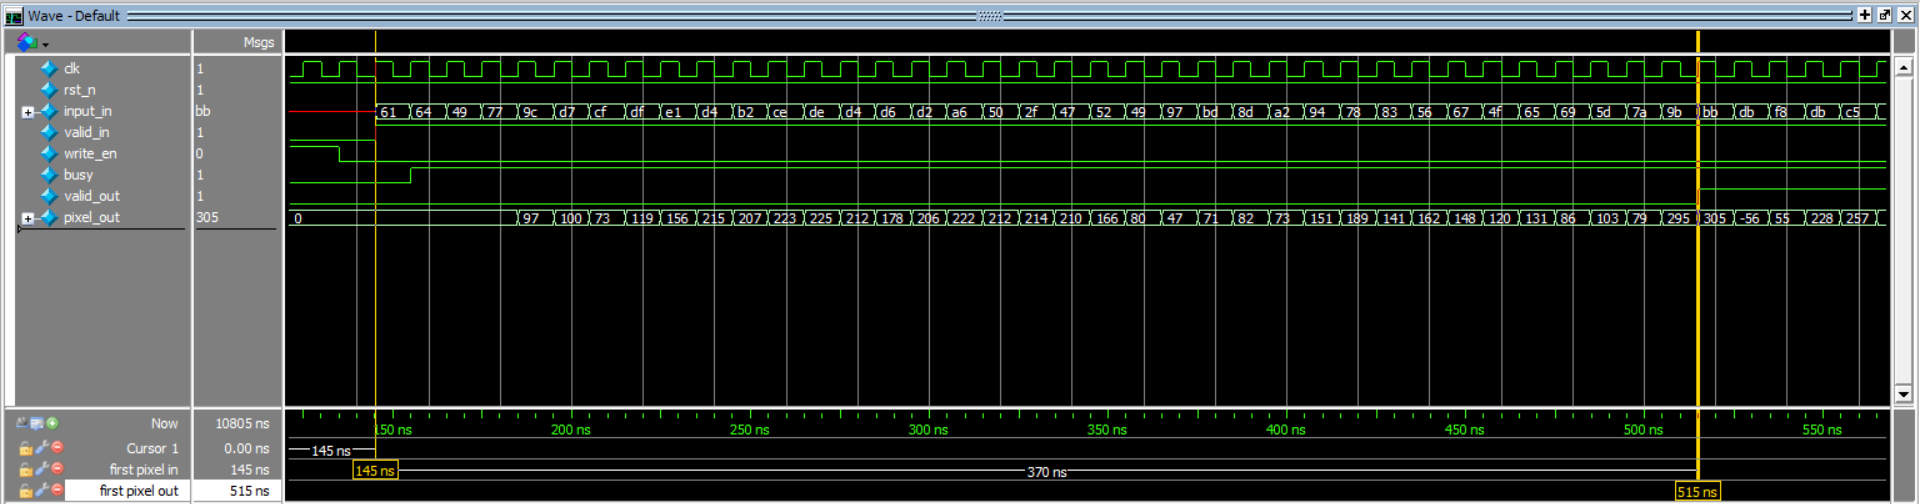
docs/figures/waveforms/Latency.PNG
