ThirstySALMON/conv3x3-edge-accelerator/docs/figures/waveforms/stall.PNG

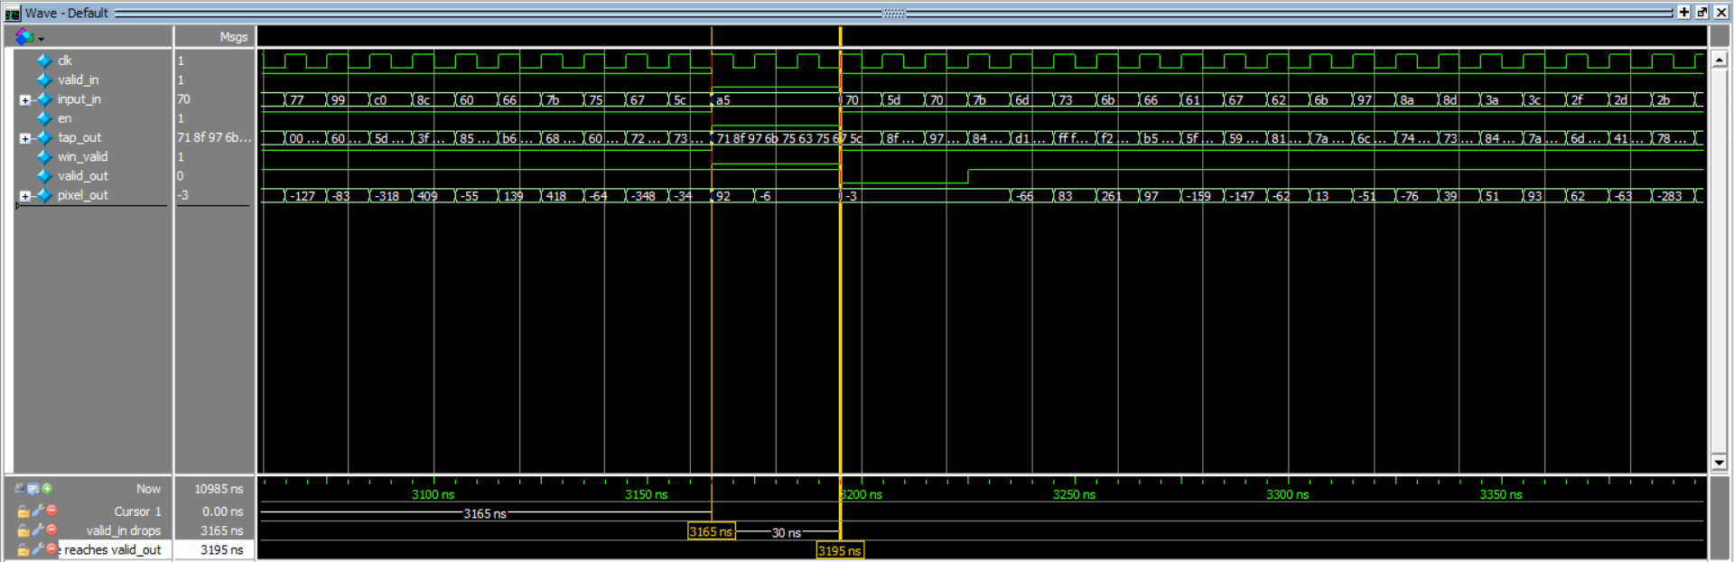
docs/figures/waveforms/stall.PNG
