ThirstySALMON/conv3x3-edge-accelerator/docs/figures/waveforms/throughput.PNG

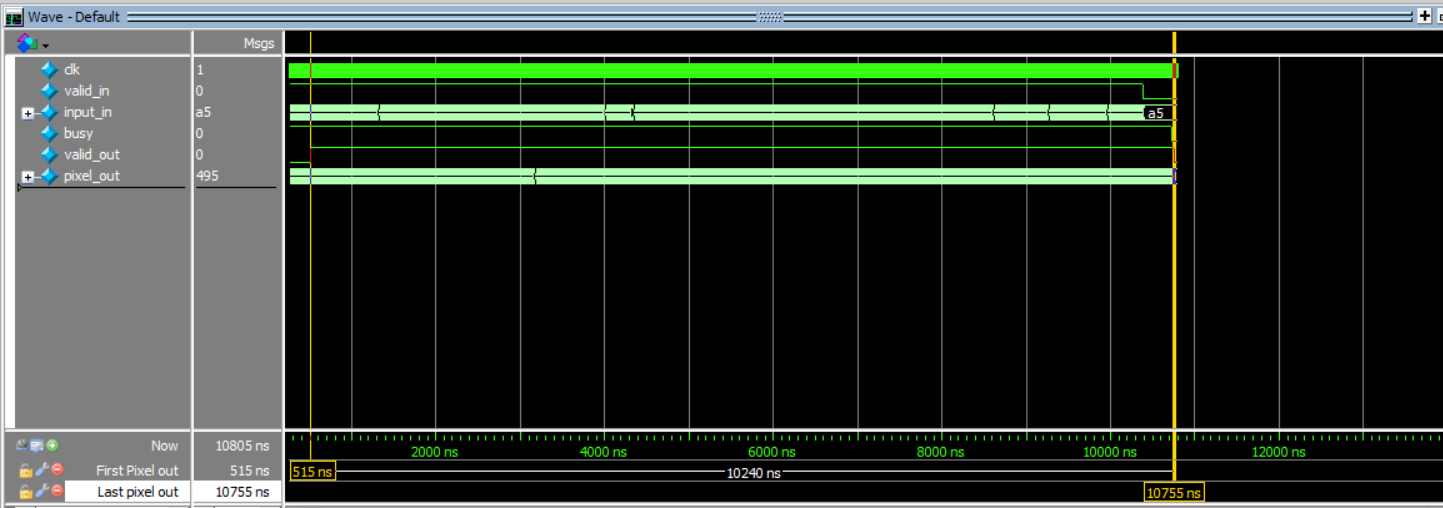
docs/figures/waveforms/throughput.PNG
