ThirstySALMON/conv3x3-edge-accelerator/docs/figures/waveforms/Window_generator_producing_valid_taps.PNG

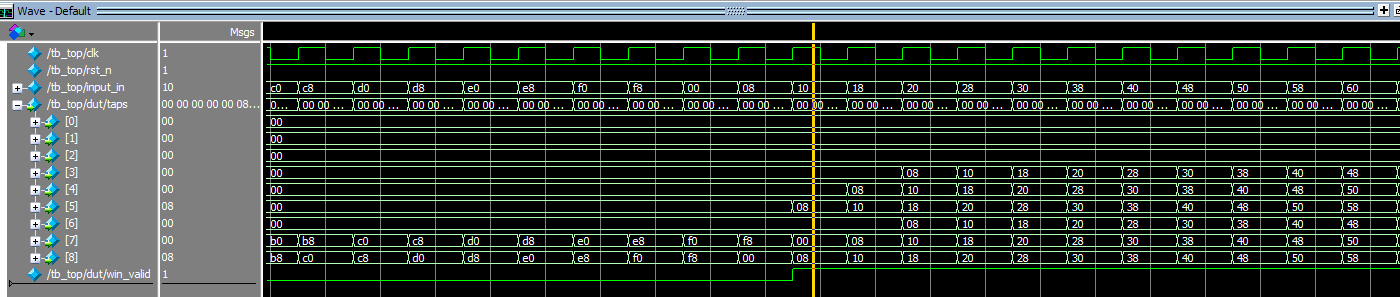
docs/figures/waveforms/Window_generator_producing_valid_taps.PNG
