ThirstySALMON/conv3x3-edge-accelerator/golden_model/cat.png

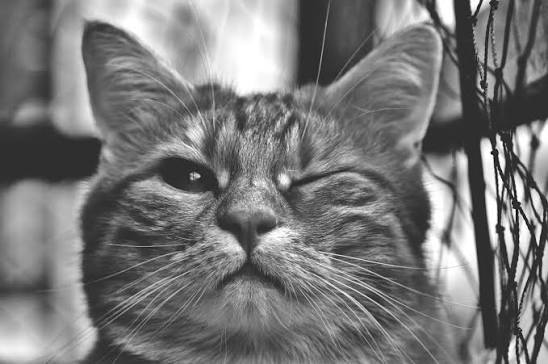
golden_model/cat.png
