ThirstySALMON/conv3x3-edge-accelerator/golden_model/png/laplacian.png

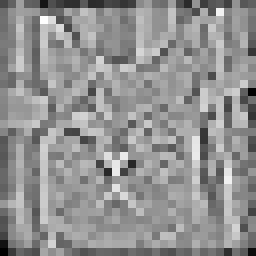
golden_model/png/laplacian.png
