ThirstySALMON/conv3x3-edge-accelerator/golden_model/png/sharpen.png

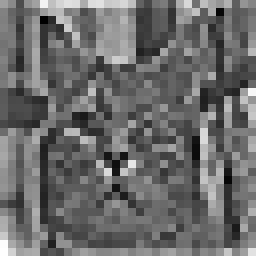
golden_model/png/sharpen.png
