ThirstySALMON/conv3x3-edge-accelerator/golden_model/png/sobel_y.png

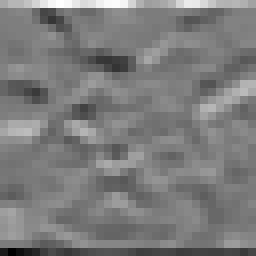
golden_model/png/sobel_y.png
