ThirstySALMON/conv3x3-edge-accelerator/rtl/control_unit.sv

import cnn_pkg::*;
module control_fsm (
    input  logic clk,
    input  logic rst_n,
    input  logic valid_in,

    output logic en,
    output logic win_valid,
    output logic top_edge,
    output logic bottom_edge,
    output logic left_edge,
    output logic right_edge,
    output logic busy,
    output logic frame_done
);

 typedef enum logic [2:0] {
        S_IDLE, S_FILL, S_STREAM, S_DRAIN, S_DONE
    } state_e;

    state_e state, next;

    logic [$clog2(NPIX)-1:0]         in_cnt;
    logic [$clog2(IMG_W)-1:0]        out_c;
    logic [$clog2(IMG_H)-1:0]        out_r;
    logic [$clog2(DRAIN_CYCLES)-1:0] drain_cnt;
    logic                            consume, out_adv, last_consume;
    logic [$clog2(IMG_W)-1:0]        nxt_c;
    logic [$clog2(IMG_H)-1:0]        nxt_r;

        always_comb begin
        case (state)
            S_DRAIN: en = 1'b1;
            S_DONE:  en = 1'b0;
            default: en = valid_in;
        endcase
    end

    // next position computed here so edge flags can be registered, keeps the comparators off the tap-mux path
    always_comb begin
        nxt_c = out_c;
        nxt_r = out_r;
        if (out_adv) begin
            if (out_c == IMG_W-1) begin
                nxt_c = '0;
                nxt_r = (out_r == IMG_H-1) ? '0 : out_r + 1;
            end else begin
                nxt_c = out_c + 1;
            end
        end
    end

    assign consume = en && (state != S_DRAIN);
    assign out_adv = en && (state == S_STREAM || state == S_DRAIN);

    
    assign last_consume = consume && (in_cnt == NPIX-1);


    assign win_valid  = out_adv;
    assign busy       = (state != S_IDLE) && (state != S_DONE);
    assign frame_done = (state == S_DONE);


    always_comb begin
        next = state;
        case (state)
            S_IDLE:   if (valid_in)                              next = S_FILL;
            S_FILL:   if (valid_in && in_cnt == FILL_CYCLES-1)   next = S_STREAM;
            S_STREAM: if (last_consume)                          next = S_DRAIN;
            S_DRAIN:  if (drain_cnt == DRAIN_CYCLES-1)           next = S_DONE;
            S_DONE:                                              next = S_IDLE;
            default:                                             next = S_IDLE;
        endcase
    end

     always_ff @(posedge clk) begin           // sync reset
        if (!rst_n) begin
            state     <= S_IDLE;
            in_cnt    <= '0;
            out_r     <= '0;
            out_c     <= '0;
            drain_cnt <= '0;
            top_edge    <= 1'b1;      // reset flags match pixel (0,0)
            bottom_edge <= 1'b0;
            left_edge   <= 1'b1;
            right_edge  <= 1'b0;
        end else begin
            state <= next;

            if (consume)
                in_cnt <= (in_cnt == NPIX-1) ? '0 : in_cnt + 1;

            out_c <= nxt_c;
            out_r <= nxt_r;

            top_edge    <= (nxt_r == 0);
            bottom_edge <= (nxt_r == IMG_H-1);
            left_edge   <= (nxt_c == 0);
            right_edge  <= (nxt_c == IMG_W-1);

            drain_cnt <= (state == S_DRAIN) ? (drain_cnt + 1) : '0;
        end
    end

endmodule 
