ThirstySALMON/conv3x3-edge-accelerator/rtl/line_buffer.sv

import cnn_pkg::*;

// one image row of delay, kept as FF/LUTRAM shift reg - BRAM costs ~100x in FoM
module line_buffer #(
    parameter int DEPTH = LB_DEPTH,
    parameter int WIDTH = IN_W
) (
    input  logic             clk,
    input  logic             rst_n,
    input  logic [WIDTH-1:0] d_in,
    input  logic             en,

    output logic [WIDTH-1:0] d_out
);

    logic [WIDTH-1:0] sr [0:DEPTH-1];

    always_ff @(posedge clk) begin
        if (!rst_n) begin
            for (int i = 0; i < DEPTH; i++)
                sr[i] <= '0;
        end else if (en) begin
            sr[0] <= d_in;
            for (int i = 1; i < DEPTH; i++)
                sr[i] <= sr[i-1];
        end
    end

    assign d_out = sr[DEPTH-1];

endmodule
