ThirstySALMON/conv3x3-edge-accelerator/(commit log)

2026-08-25 Added Window generator and starter docs
    [spec.xlsx]
2026-08-31 Refactor code structure and remove redundant sections for improved readability and maintainability
    [spec.xlsx]
2026-09-01 Add top module and testbench for pixel processing
    - Created a new top module in `rtl/top.sv` with inputs for clock, reset, data, and control signals, and outputs for pixel data and status.
    - Implemented a testbench in `tb/tb_top.sv` to simulate the top module, including clock generation and reset sequence.
    - Added functionality to load input vectors from a file and prepare for data streaming.
    [tb_top.sv, top.sv]
2026-09-11 Implement on xc7z020, timing closed, FPGA reports
    882 LUTs, 437 FFs, 0 DSP, 0 BRAM. WNS +0.332ns at 125 MHz -> Fmax 130.4 MHz.
    Power 0.181 W vectorless. FoM 6.27e-3 pending the formula check against the PDF.
    Vivado inferred SRL32E for both line buffers (nothing reads the intermediate
    elements), so they cost 16 LUTs instead of 512 FFs. Earlier notes said LUT as
    shift register had to be 0 - that was wrong, corrected in the fpga docs.
    XDC false-paths IO: with a nominal 1ns budget all 84 setup failures were pad
    delay (3v3 OBUF alone is 3.557ns of an 8ns period) with 2 logic levels. Nothing
    external clocks these pins, so what gets reported is core register-to-register
    Fmax.
    coeff_reg: synchron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
    [coeff_reg.sv, pynq_z2.xdc, tb_top.sv, tb_top_all.sv, tb_top_window.sv]
2026-09-11 Set power switching activity by hand, xsim will not run here
    Both xsim and batch-mode vivado die with "Unknown error occured while verifying
    the digital signature. Error Code: -2146869232" before running anything - a two
    line $display fails the same way, so it is the install or a security product,
    not the design. The GUI flow works, which is where the committed reports came
    from.
    build.tcl now sets toggle rates from what the testbench actually does when no
    SAIF is present, and still prefers fpga/tb_top.saif if one exists. saif.bat is
    kept for a machine where xsim works.
2026-09-11 Register the edge flags, take the comparator out of the multiplier path
    Vivado's critical path was out_c -> right_edge -> tap mux -> multiplier -> prod_r,
    8 levels and 7.633 ns: the column counter, the edge comparator, the tap masking
    and the multiply all in one cycle. The flags are now registered, computed from
    the next output position so they are valid when used. 4 FFs, no extra LUTs, same
    latency, same interface.
    Regression 16/16 and tb_top_window reports 0 position/edge errors across all
    1024 windows.
    Also corrects a wrong claim in RESULTS.md: in_cnt is NOT a redundant counter.
    consume runs during FILL too, so inputs lead outputs by FILL_CYCLES and the last
    consumed pixel sits at outpu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
    [control_unit.sv]
2026-09-11 Saturate by sign-extension check, and actually test the saturation
    acc fits in 16 bits signed exactly when acc[19:15] are all copies of the sign
    bit, so two 20-bit magnitude compares (two carry chains) become one 5-bit
    equality test, ~2 LUTs. Proved equivalent over all 2^20 accumulator values
    before touching the RTL.
    Doing this exposed that the saturation branches had never been exercised: the
    widest real kernel is sobel_y at [-898, +934], nowhere near +/-32767. Added
    satmax (all +127) and satmin (all -128) to the golden model, which clamp on all
    1024 outputs including the zero-padded borders. Regression 16 -> 22 runs, all
    pass.
    docs/DESIGN_ITERATIONS.md records the profiling, this change,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
2026-09-11 Re-implement with both changes: WNS +0.332 -> +0.742, Fmax 130 -> 138 MHz
    Routed 11 Sep 18:06, xc7z020clg400-1. 879 LUTs (-3), 441 FFs (+4), 0 DSP,
    0 BRAM, 0.181 W. FoM 6.285e-3.
    The critical path moved off the edge comparator but stays inside stage 1:
    bottom_edge_reg -> tap mux -> multiplier -> prod_r[8][13], 7 levels, 7.297 ns.
    bottom_edge now has fanout 156 and 1.517 ns of that path is the net into
    window_gen, so the routing to the 24 tap muxes is the largest single term.
    Stage 3 did not become the new bottleneck. Whether it is close behind is still
    unmeasured - paths.tcl has not been run.
    Regression 22/22 against exactly this RTL.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
2026-09-11 Measure per-stage slack: stage 1 binds, saturate stage has 1.9ns spare
    paths.tcl on the routed design:
    stage 1 (multipliers) +0.742 ns
    stage 3 (saturate) +2.666 ns
    stage 2 (row adders) +3.799 ns
    The saturate stage was never the bottleneck, so the top-bits rewrite bought no
    timing - it stays for the 2 LUTs and because writing it is what exposed the
    untested saturation branches.
    All 15 worst paths start at an edge flag (bottom_edge x9, top_edge x4,
    right_edge x1) and end at prod_r. The constraint is flag arrival at the
    multipliers, not the multiplier logic. bottom_edge has fanout 156 and that one
    net is 1.517 ns of the 7.297 ns path; replicating the flag registers per tap row
    wo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
2026-09-11 Window the SAIF to active convolution, document power methodology
    Organiser confirmed the FoM power term is total post-implementation power
    (static + dynamic) and the SAIF must represent active convolution, excluding
    reset and idle. saif_xsim.tcl now windows the capture to 145-10800 ns instead
    of logging the whole run: that skips the 4 reset cycles and 9 coefficient
    writes and covers 1024 outputs plus fill and drain, 1332 cycles, no idle.
    FoM formula confirmed against the PDF, matches what the docs assumed. No power
    unit given there, watts assumed and flagged as an assumption.
    docs/POWER_METHODOLOGY.md holds the five items they asked to be reported, the
    SAIF interval, why the FoM is comput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
2026-09-11 SAIF-annotated power 0.158 W, FoM 7.20e-3, 125 MHz locked, block diagram notes
    xsim runs now that the signature error is cleared. saif.bat had a path bug of
    its own: --tclbatch fpga\saif_xsim.tcl lost its backslash going through tcl.
    Forward slashes fix it. Capture is windowed to 145-10800 ns so reset and the
    coefficient load are excluded, as the organiser asked. Logged recursively,
    2380 nets.
    read_saif matches 414 of 2229 nets however the SAIF is logged - the rest are
    synthesis-invented internal names no RTL sim can produce, so 19% is a ceiling
    and not a coverage problem. Dynamic 0.074 -> 0.052 W, total 0.181 -> 0.158 W,
    Low -> Medium confidence. FoM 6.285e-3 -> 7.20e-3, +14.6%, no RTL cha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
2026-09-13 Two-day plan, PYNQ-Z2 is a hard requirement, edge-detection figures from hw_out
    docs/FINAL_TWO_DAYS.md: step by step for Sunday and Monday, with the answers
    to two questions - the waveforms do not need retaking (three RTL commits landed
    after them, none changes anything visible, proven by the regression), and the
    XDC would load and run on a PYNQ-Z2 but a demo needs a wrapper because nothing
    on the board drives the 42 pins.
    The Basys 3 experiment is dropped for good: PYNQ-Z2 is a hard requirement.
    golden_model/hw_to_png.py renders hw_out/<kernel>_out.hex - the hardware
    outputs, not the golden ones - next to the input image. That is the
    edge-detection bonus in simulation. sobel_x, sobel_y, l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
2026-09-13 Final run 13 Sep reproduces the Friday numbers exactly, submission build frozen
    Fresh Vivado project, GUI flow, SAIF read in afterwards, committed RTL: 879 LUTs,
    441 FFs, 16 SRL, 0 DSP, 0 BRAM, WNS +0.742 / WHS +0.153, 0.158 W (0.052 dynamic
    + 0.107 static), FoM 7.20e-3. Identical to the 11 Sep in-memory flow. The 910
    seen after synthesis is the pre-opt estimate; post-route is the number.
    One DRC warning, ZPS7-1 PS7 block required - expected for a PL-only Zynq design,
    no effect on any reported figure. Written up in RESULTS.md.
    paths.tcl: report_timing has no -header option in 2025.2; the section titles
    are now written by the script itself and the whole thing goes to
    fpga/reports/paths.rpt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
2026-09-13 Per-stage timing report and synthesis-stage artefacts
    fpga/reports/paths.rpt: worst 15 paths plus the worst 3 into each pipeline
    stage, from the final routed design. Stage 1 (multipliers) binds at +0.742,
    stage 3 (saturate) has 1.9 ns spare, stage 2 has 3 ns.
    synth_utilization.rpt and synth.log copied out of the Vivado project run so
    the package holds synthesis results as well as implementation results, which
    is what announcement item 9 asks for. The synth log also carries the shift
    register inference table (2 x SRLC32E chains, 16 LUTs) and the cell usage.
2026-09-13 Bitstream and pin report for the PYNQ-Z2 build
    fpga/top.bit: xc7z020clg400-1, PL-only, the pinout in pynq_z2.xdc. Generated to
    show the design is implementable end to end; not demonstrated, no board on
    hand. The only DRC is ZPS7-1 (PS7 block required), expected for a PL-only Zynq
    design.
    fpga/reports/io.rpt: every port with its package pin, bank, IO standard and
    drive - all 42 on user-accessible connectors (Pmod A/B, Arduino header, RPi
    header, SW0, LED0/1).
2026-09-14 Restructure docs into report / figures / notes
    docs/report/ what gets written: REPORT_SKELETON.md (headings in the
    announcement's deliverable order, figure and table numbers
    pre-assigned), the two outlines, the diagram notes
    docs/figures/ the 10 waveform PNGs and the 3 edge-detection renders, the only
    images the report uses
    docs/notes/ reference only - power method, design iterations, architecture
    notes, checklists, the announcement. Export-ignored.
    docs/README.md says which two PDFs get submitted, where each number comes from,
    and the order to write in.
    All cross-references updated to the new paths; hw_to_png.py regenerates into
    d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
    [spec.xlsx]
2026-09-14 fix the docs move: the originals were still tracked, and export-ignore needs a glob
    git mv had failed silently so docs/ held both copies; the stale index entries
    are removed. docs/notes/ as a bare directory matched nothing - docs/notes/**
    does.
    [spec.xlsx]
2026-09-14 datapath diagram (figure 3.1)
    Updated drawing: valid chain named as three stages, saturate and relu split,
    clk/rst_n and the four edge flags shown. Still to add: SRL annotation on the
    line buffers, 8u x 8s on the multiplier, stage boundaries, latency 37.
2026-09-14 report sections 3 (datapath) and 4 (control FSM)
    Written to match the style of the sections already in the docx. Numbers from
    paths.rpt, utilization_hier.rpt and the RTL; figure placeholders marked for
    insertion.
    Also files the datapath drawing as docs/figures/Data_path.svg.
2026-09-14 report sections 3-19 and appendix written into the docx
    Sections 3, 4, 7-19 and Appendix A appended using the document's own styles
    (Heading2/3, GridTable1Light, code-line). 32 tables. Every figure has a marked
    placeholder for insertion.
    All numbers taken from fpga/reports/ and the RTL. Section 4.1 states the STREAM
    duration as 990 cycles with the explanation; sections 9 and 16 carry the
    regression matrix and the required Table 1.
    Markdown sources kept in docs/report/ for editing.
2026-09-14 rewrite section 1 and put the sections in the announcement's order
    Section 1 was duplicating four other sections wholesale - the resource
    breakdown (12), verification summary (9), assumptions list (17) and module map
    (8) - and several of its numbers had been lost with dropped equation fields,
    so it read 'WNS , WHS' and 'Power: total ( static, dynamic)'. Rewritten around
    what only section 1 can say: the control/datapath split, the processing chain,
    the interface, and the three FoM decisions with their arithmetic. Results are
    now a six-row summary table with the real numbers, pointing forward rather than
    restating.
    Sections reordered to 1,2,3,4,5,6,7..19 as the announcement lists the
    delivera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
2026-09-14 correct the DSP-suppression claim: the attribute alone, not -max_dsp 0
    The submitted numbers came from the Vivado GUI project run, whose synth_design
    line is plain:
    synth_design -top top -part xc7z020clg400-1
    -max_dsp 0 exists only in fpga/build.tcl, which produced the earlier in-memory
    run, not the reports in the submission. The (* use_dsp = "no" *) attribute on
    mult8x8 achieved DSPs = 0 of 220 on its own - the synth log shows nine
    multipliers inferred with no DSP mapping.
    Three paragraphs in the report credited both mechanisms; they now credit the
    attribute and note -max_dsp 0 as an unused guard available in the scripted flow.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
